maglambayan/tahanan/manufacturing/bom/tahanan-pcba-bom.csv

References | Qty | Value | Description | Manufacturer | MPN | Footprint | Fit | Alternates | Unit USD | Ext USD | Price basis | DigiKey stock | Supply note | DigiKey search | Mouser search | LCSC search | Datasheet
BT1 | 1 | CR1220 | Coin cell holder 12mm, RTC backup | Keystone | 3000 | BatteryHolder_Keystone_3000_1x12mm | fit |  | 0.550 | 0.55 | estimate |  |  | https://www.digikey.com/en/products/result?keywords=3000 | https://www.mouser.com/c/?q=3000 | https://www.lcsc.com/search?q=3000
C1 C2 C15 C25 C35 C45 C46 C53 C87 C88 C94 C95 C97 | 13 | 1uF 16V | MLCC 1uF 16V X5R 0402 | Samsung | CL05A105KO5NNNC | C_0402_1005Metric | fit |  | 0.008 | 0.10 | estimate |  |  | https://www.digikey.com/en/products/result?keywords=CL05A105KO5NNNC | https://www.mouser.com/c/?q=CL05A105KO5NNNC | https://www.lcsc.com/search?q=CL05A105KO5NNNC
C3 | 1 | 4.7uF 50V | MLCC 4.7uF 50V X5R 0805 | Samsung | CL21A475KBQNNNE | C_0805_2012Metric | fit |  | 0.008 | 0.01 | estimate |  |  | https://www.digikey.com/en/products/result?keywords=CL21A475KBQNNNE | https://www.mouser.com/c/?q=CL21A475KBQNNNE | https://www.lcsc.com/search?q=CL21A475KBQNNNE
C4 C6 C7 | 3 | 100nF 50V | MLCC 100nF 50V X7R 0603 | Samsung | CL10B104KB8NNNC | C_0603_1608Metric | fit |  | 0.008 | 0.02 | estimate |  |  | https://www.digikey.com/en/products/result?keywords=CL10B104KB8NNNC | https://www.mouser.com/c/?q=CL10B104KB8NNNC | https://www.lcsc.com/search?q=CL10B104KB8NNNC
C5 C8 C9 C11 C12 C21 C22 C31 C32 | 9 | 10uF 50V | MLCC 10uF 50V X7R 1210 | Samsung | CL32B106KBJNNNE | C_1210_3225Metric | fit |  | 0.160 | 1.44 | estimate |  |  | https://www.digikey.com/en/products/result?keywords=CL32B106KBJNNNE | https://www.mouser.com/c/?q=CL32B106KBJNNNE | https://www.lcsc.com/search?q=CL32B106KBJNNNE
C10 | 1 | 100uF 35V | Aluminium electrolytic 100uF 35V low-ESR | Panasonic | EEE-FT1V101AP | CP_Elec_6.3x7.7 | fit |  | 0.235 | 0.23 | DigiKey 2026-11-11, break at 1000 | 17076 |  | https://www.digikey.com/en/products/result?keywords=EEE-FT1V101AP | https://www.mouser.com/c/?q=EEE-FT1V101AP | https://www.lcsc.com/search?q=EEE-FT1V101AP
C13 C23 C33 | 3 | 220nF 50V | MLCC 220nF 50V X7R 0603 | Samsung | CL10B224KB8NNNC | C_0603_1608Metric | fit |  | 0.036 | 0.11 | DigiKey 2026-11-11, break at 500 | 138733 |  | https://www.digikey.com/en/products/result?keywords=CL10B224KB8NNNC | https://www.mouser.com/c/?q=CL10B224KB8NNNC | https://www.lcsc.com/search?q=CL10B224KB8NNNC
C14 C24 C34 C42 C51 C52 C57 C58 C60 C62 C64 C65 C66 C67 C68 C76 C80 C81 C83 C84 C85 C86 C91 C92 C93 C96 | 26 | 100nF 16V | MLCC 100nF 16V X7R 0402 | Samsung | CL05B104KO5NNNC | C_0402_1005Metric | fit |  | 0.008 | 0.21 | estimate |  |  | https://www.digikey.com/en/products/result?keywords=CL05B104KO5NNNC | https://www.mouser.com/c/?q=CL05B104KO5NNNC | https://www.lcsc.com/search?q=CL05B104KO5NNNC
C16 C26 C36 | 3 | 22pF 50V | MLCC 22pF 50V C0G 0402 | Samsung | CL05C220JB5NNNC | C_0402_1005Metric | fit |  | 0.008 | 0.02 | estimate |  |  | https://www.digikey.com/en/products/result?keywords=CL05C220JB5NNNC | https://www.mouser.com/c/?q=CL05C220JB5NNNC | https://www.lcsc.com/search?q=CL05C220JB5NNNC
C17 C18 C19 C20 C27 C28 C29 C30 C37 C38 C39 C40 C43 C44 C47 C48 C49 C50 C54 C55 C56 C90 | 22 | 22uF 10V | MLCC 22uF 10V X5R 0805 | Samsung | CL21A226MPQNNNE | C_0805_2012Metric | fit |  | 0.050 | 1.10 | estimate |  |  | https://www.digikey.com/en/products/result?keywords=CL21A226MPQNNNE | https://www.mouser.com/c/?q=CL21A226MPQNNNE | https://www.lcsc.com/search?q=CL21A226MPQNNNE
C41 C59 C75 C79 C82 C89 | 6 | 10uF 10V | MLCC 10uF 10V X5R 0603 | Samsung | CL10A106KP8NNNC | C_0603_1608Metric | fit |  | 0.008 | 0.05 | estimate |  |  | https://www.digikey.com/en/products/result?keywords=CL10A106KP8NNNC | https://www.mouser.com/c/?q=CL10A106KP8NNNC | https://www.lcsc.com/search?q=CL10A106KP8NNNC
C61 C63 | 2 | 150uF 6.3V | Polymer tantalum 150uF 6.3V 70mOhm | KEMET | T520B157M006ATE070 | CP_EIA-3528-21_Kemet-B | fit |  | 1.380 | 2.76 | DigiKey 2026-11-11, list price, break not shown | not shown |  | https://www.digikey.com/en/products/result?keywords=T520B157M006ATE070 | https://www.mouser.com/c/?q=T520B157M006ATE070 | https://www.lcsc.com/search?q=T520B157M006ATE070
C69 | 1 | 100nF 100V | MLCC 100nF 100V X7R 0805 | Samsung | CL21B104KCFNNNE | C_0805_2012Metric | fit |  | 0.008 | 0.01 | estimate |  |  | https://www.digikey.com/en/products/result?keywords=CL21B104KCFNNNE | https://www.mouser.com/c/?q=CL21B104KCFNNNE | https://www.lcsc.com/search?q=CL21B104KCFNNNE
C70 C72 | 2 | 1000uF 16V | Aluminium electrolytic 1000uF 16V, required by Ag5810 | Panasonic | EEE-FT1C102AP | CP_Elec_10x10.5 | fit |  | 0.580 | 1.16 | DigiKey 2026-11-11, break at 1000 | 9181 |  | https://www.digikey.com/en/products/result?keywords=EEE-FT1C102AP | https://www.mouser.com/c/?q=EEE-FT1C102AP | https://www.lcsc.com/search?q=EEE-FT1C102AP
C71 C73 | 2 | 10uF 25V | MLCC 10uF 25V X7R 1206 | Samsung | CL31B106KAHNNNE | C_1206_3216Metric | fit |  | 0.070 | 0.14 | estimate |  |  | https://www.digikey.com/en/products/result?keywords=CL31B106KAHNNNE | https://www.mouser.com/c/?q=CL31B106KAHNNNE | https://www.lcsc.com/search?q=CL31B106KAHNNNE
C74 | 1 | 4.7nF 2kV | MLCC 4.7nF 2kV X7R 1812 | KEMET | C1812C472KGRACTU | C_1812_4532Metric | fit |  | 0.740 | 0.74 | DigiKey 2026-11-11, break at 1000 | 2074 |  | https://www.digikey.com/en/products/result?keywords=C1812C472KGRACTU | https://www.mouser.com/c/?q=C1812C472KGRACTU | https://www.lcsc.com/search?q=C1812C472KGRACTU
C77 C78 | 2 | DNP 50V | MLCC DNP 50V C0G 0402 |  |  | C_0402_1005Metric | DNP |  | 0.000 | 0.00
C98 C99 | 2 | 1nF 50V | MLCC 1nF 50V X7R 0402 | Samsung | CL05B102KB5NNNC | C_0402_1005Metric | fit |  | 0.008 | 0.02 | estimate |  |  | https://www.digikey.com/en/products/result?keywords=CL05B102KB5NNNC | https://www.mouser.com/c/?q=CL05B102KB5NNNC | https://www.lcsc.com/search?q=CL05B102KB5NNNC
D1 | 1 | SMAJ22A | TVS 22V unidirectional 400W SMA | Littelfuse | SMAJ22A | D_SMA | fit |  | 0.120 | 0.12 | estimate |  |  | https://www.digikey.com/en/products/result?keywords=SMAJ22A | https://www.mouser.com/c/?q=SMAJ22A | https://www.lcsc.com/search?q=SMAJ22A | https://www.littelfuse.com/media?itemid=75e32973-b177-4ee3-a0ff-cedaf1abdb93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
D2 | 1 | BZT52C10S 10V | Zener 10V 200mW SOD-323, Q1 gate clamp | Diodes Inc | BZT52C10S-7-F | D_SOD-323 | fit |  | 0.030 | 0.03 | estimate |  |  | https://www.digikey.com/en/products/result?keywords=BZT52C10S-7-F | https://www.mouser.com/c/?q=BZT52C10S-7-F | https://www.lcsc.com/search?q=BZT52C10S-7-F
D3 | 1 | LED red | LED red 0603 | Wurth | 150060RS75000 | LED_0603_1608Metric | fit |  | 0.030 | 0.03 | estimate |  |  | https://www.digikey.com/en/products/result?keywords=150060RS75000 | https://www.mouser.com/c/?q=150060RS75000 | https://www.lcsc.com/search?q=150060RS75000
D4 D16 | 2 | LED green | LED green 0603 | Wurth | 150060GS75000 | LED_0603_1608Metric | fit |  | 0.030 | 0.06 | estimate |  |  | https://www.digikey.com/en/products/result?keywords=150060GS75000 | https://www.mouser.com/c/?q=150060GS75000 | https://www.lcsc.com/search?q=150060GS75000
D5 | 1 | LED blue | LED blue 0603 | Wurth | 150060BS75000 | LED_0603_1608Metric | fit |  | 0.030 | 0.03 | estimate |  |  | https://www.digikey.com/en/products/result?keywords=150060BS75000 | https://www.mouser.com/c/?q=150060BS75000 | https://www.lcsc.com/search?q=150060BS75000
D6 D17 | 2 | LED yellow | LED yellow 0603 | Wurth | 150060YS75000 | LED_0603_1608Metric | fit |  | 0.030 | 0.06 | estimate |  |  | https://www.digikey.com/en/products/result?keywords=150060YS75000 | https://www.mouser.com/c/?q=150060YS75000 | https://www.lcsc.com/search?q=150060YS75000
D7 D8 D9 D10 D11 D12 D13 D14 | 8 | PMEG10020ELR | Schottky 100V 2A SOD-123W, PoE input bridge | Nexperia | PMEG10020ELRX | Nexperia_CFP3_SOD-123W | fit | SS210 | 0.138 | 1.10 | DigiKey 2026-11-11, break at 500 | 236366 |  | https://www.digikey.com/en/products/result?keywords=PMEG10020ELRX | https://www.mouser.com/c/?q=PMEG10020ELRX | https://www.lcsc.com/search?q=PMEG10020ELRX | https://assets.nexperia.com/documents/data-sheet/PMEG10020ELR.pdf
D15 | 1 | SMAJ58A | TVS 58V unidirectional 400W SMA (pin 1 cathode to VPOE_P) | Littelfuse | SMAJ58A | D_SMA | fit |  | 0.120 | 0.12 | estimate |  |  | https://www.digikey.com/en/products/result?keywords=SMAJ58A | https://www.mouser.com/c/?q=SMAJ58A | https://www.lcsc.com/search?q=SMAJ58A | https://www.littelfuse.com/media?itemid=75e32973-b177-4ee3-a0ff-cedaf1abdb93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
FB1 FB2 | 2 | 1k@100MHz 2A | Ferrite bead | Taiyo Yuden | FBMH3225HM102NT | L_1210_3225Metric | fit |  | 0.530 | 1.06 | DigiKey 2026-11-11, list price, break not shown | not shown |  | https://www.digikey.com/en/products/result?keywords=FBMH3225HM102NT | https://www.mouser.com/c/?q=FBMH3225HM102NT | https://www.lcsc.com/search?q=FBMH3225HM102NT
FB3 FB5 FB6 | 3 | 220R@100MHz 1.4A | Ferrite bead | Murata | BLM18PG221SN1D | L_0603_1608Metric | fit |  | 0.030 | 0.09 | estimate |  |  | https://www.digikey.com/en/products/result?keywords=BLM18PG221SN1D | https://www.mouser.com/c/?q=BLM18PG221SN1D | https://www.lcsc.com/search?q=BLM18PG221SN1D
FB4 | 1 | 220R@100MHz 2A | Ferrite bead | Murata | BLM21PG221SN1D | L_0805_2012Metric | fit |  | 0.040 | 0.04 | estimate |  |  | https://www.digikey.com/en/products/result?keywords=BLM21PG221SN1D | https://www.mouser.com/c/?q=BLM21PG221SN1D | https://www.lcsc.com/search?q=BLM21PG221SN1D
H1 H2 H3 H4 | 4 | M2.5 standoff 3mm | SMT spacer M2.5 internal thread, 3.0mm, CM5 mounting | Wurth | 9774030151R | Mounting_Wuerth_WA-SMSI-M2.5_H3mm_9774030151 | fit |  | 0.601 | 2.41 | DigiKey 2026-11-11, break at 700 | 61790 |  | https://www.digikey.com/en/products/result?keywords=9774030151R | https://www.mouser.com/c/?q=9774030151R | https://www.lcsc.com/search?q=9774030151R
H9 | 1 | M.2 standoff 2280 | SMT spacer M2, M.2 2280 retention | Wurth | 9774025243R | Mounting_Wuerth_WA-SMSI-M2_H2.5mm_9774025243 | fit |  | 0.692 | 0.69 | DigiKey 2026-11-11, break at 950 | 127269 |  | https://www.digikey.com/en/products/result?keywords=9774025243R | https://www.mouser.com/c/?q=9774025243R | https://www.lcsc.com/search?q=9774025243R
H10 | 1 | M.2 standoff 2242 | SMT spacer M2, M.2 2242 retention | Wurth | 9774025243R | Mounting_Wuerth_WA-SMSI-M2_H2.5mm_9774025243 | fit |  | 0.692 | 0.69 | DigiKey 2026-11-11, break at 950 | 127269 |  | https://www.digikey.com/en/products/result?keywords=9774025243R | https://www.mouser.com/c/?q=9774025243R | https://www.lcsc.com/search?q=9774025243R
J1 | 1 | USB-C PD | USB Type-C receptacle, USB 2.0, 16 pin, top mount | GCT | USB4105-GF-A | USB_C_Receptacle_GCT_USB4105-xx-A_16P_TopMnt_Horizontal | fit | HRO TYPE-C-31-M-12 (different footprint) | 0.800 | 0.80 | DigiKey 2026-11-11, list price, break not shown | not shown |  | https://www.digikey.com/en/products/result?keywords=USB4105-GF-A | https://www.mouser.com/c/?q=USB4105-GF-A | https://www.lcsc.com/search?q=USB4105-GF-A | https://www.usb.org/sites/default/files/documents/usb_type-c.zip
J2 | 1 | RJ45 GbE PoE | RJ45 1000BASE-T with magnetics, four cable-side centre taps for PoE, 600 mA per tap | Wurth Elektronik | 7499511001A | RJ45_Wuerth_7499511001A | fit | Link-PP LPJG0926HENL (different footprint) | 7.791 | 7.79 | DigiKey 2026-11-11, break at 100 | 0 | 42 expected 2026-11-18 | https://www.digikey.com/en/products/result?keywords=7499511001A | https://www.mouser.com/c/?q=7499511001A | https://www.lcsc.com/search?q=7499511001A | https://www.we-online.com/components/products/datasheet/7499511001A.pdf
J3 | 1 | CM5 pins 1-100 | 100-pin 0.4mm board-to-board receptacle, 3.0mm stack, mates with CM5 | Hirose | DF40HC(3.0)-100DS-0.4V(51) | Hirose_DF40HC(3.0)-100DS-0.4V_2x50_P0.4mm | fit | Amphenol 10164227-1004A1RLF (4.0mm stack; confirm land pattern and change standoffs to 4.0mm) | 2.234 | 2.23 | DigiKey 2026-11-11, break at 1000 | 0 | backorder | https://www.digikey.com/en/products/result?keywords=DF40HC%283.0%29-100DS-0.4V%2851%29 | https://www.mouser.com/c/?q=DF40HC%283.0%29-100DS-0.4V%2851%29 | https://www.lcsc.com/search?q=DF40HC%283.0%29-100DS-0.4V%2851%29 | https://datasheets.raspberrypi.com/cm5/cm5-datasheet.pdf
J4 | 1 | M.2 Key M | M.2 Key M socket 0.5mm pitch, NVMe SSD | TE Connectivity | 2199119-4 | TE_M.2_M_2x38-1MP_P0.5mm | fit |  | 2.140 | 2.14 | DigiKey 2026-11-11, list price, break not shown | not shown |  | https://www.digikey.com/en/products/result?keywords=2199119-4 | https://www.mouser.com/c/?q=2199119-4 | https://www.lcsc.com/search?q=2199119-4 | https://web.archive.org/web/20200613074028/http://read.pudn.com/downloads794/doc/project/3133918/PCIe_M.2_Electromechanical_Spec_Rev1.0_Final_11012013_RS_Clea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
J5 | 1 | USB 3.0 x2 | Dual stacked USB 3.0 Type-A receptacle | Molex | 48406-0001 | USB3_A_Molex_48406-0001_Horizontal_Stacked | fit |  | 2.060 | 2.06 | DigiKey 2026-11-11, break at 1080 | 2312 | listed as 0484060001 | https://www.digikey.com/en/products/result?keywords=48406-0001 | https://www.mouser.com/c/?q=48406-0001 | https://www.lcsc.com/search?q=48406-0001
J6 | 1 | FAN | 4-pin 1.0mm fan header, Raspberry Pi 5 fan pinout | JST | SM04B-SRSS-TB | JST_SH_SM04B-SRSS-TB_1x04-1MP_P1.00mm_Horizontal | fit |  | 0.220 | 0.22 | estimate |  |  | https://www.digikey.com/en/products/result?keywords=SM04B-SRSS-TB | https://www.mouser.com/c/?q=SM04B-SRSS-TB | https://www.lcsc.com/search?q=SM04B-SRSS-TB
J7 | 1 | CONSOLE 3V3 | 3-pin header, serial console (UART4, 3.3V) | Wurth | 61300311121 | PinHeader_1x03_P2.54mm_Vertical | fit |  | 0.080 | 0.08 | estimate |  |  | https://www.digikey.com/en/products/result?keywords=61300311121 | https://www.mouser.com/c/?q=61300311121 | https://www.lcsc.com/search?q=61300311121
J8 | 1 | ZB SWD | SWD pads, not fitted |  |  | PinHeader_1x05_P1.27mm_Vertical | DNP |  | 0.000 | 0.00
J9 | 1 | U.FL Zigbee | U.FL coaxial receptacle 50 ohm | Hirose | U.FL-R-SMT-1(80) | U.FL_Hirose_U.FL-R-SMT-1_Vertical | fit |  | 0.380 | 0.38 | estimate |  |  | https://www.digikey.com/en/products/result?keywords=U.FL-R-SMT-1%2880%29 | https://www.mouser.com/c/?q=U.FL-R-SMT-1%2880%29 | https://www.lcsc.com/search?q=U.FL-R-SMT-1%2880%29
J10 | 1 | TH SWD | SWD pads, not fitted |  |  | PinHeader_1x05_P1.27mm_Vertical | DNP |  | 0.000 | 0.00
J11 | 1 | Z-Wave module socket | 2x5 2.54mm socket, Raspberry Pi header pins 1-10 for Z-Wave 800 module | Samtec | SSW-105-01-G-D | PinSocket_2x05_P2.54mm_Vertical | fit |  | 0.850 | 0.85 | estimate |  |  | https://www.digikey.com/en/products/result?keywords=SSW-105-01-G-D | https://www.mouser.com/c/?q=SSW-105-01-G-D | https://www.lcsc.com/search?q=SSW-105-01-G-D
J12 | 1 | SPEAKER 4R 3W | 2-pin 2.0mm header, speaker | JST | S2B-PH-K-S | JST_PH_S2B-PH-K_1x02_P2.00mm_Horizontal | fit |  | 0.060 | 0.06 | estimate |  |  | https://www.digikey.com/en/products/result?keywords=S2B-PH-K-S | https://www.mouser.com/c/?q=S2B-PH-K-S | https://www.lcsc.com/search?q=S2B-PH-K-S
J13 | 1 | CM5 pins 101-200 | 100-pin 0.4mm board-to-board receptacle, 3.0mm stack, mates with CM5 | Hirose | DF40HC(3.0)-100DS-0.4V(51) | Hirose_DF40HC(3.0)-100DS-0.4V_2x50_P0.4mm | fit | Amphenol 10164227-1004A1RLF (4.0mm stack; confirm land pattern and change standoffs to 4.0mm) | 2.234 | 2.23 | DigiKey 2026-11-11, break at 1000 | 0 | backorder | https://www.digikey.com/en/products/result?keywords=DF40HC%283.0%29-100DS-0.4V%2851%29 | https://www.mouser.com/c/?q=DF40HC%283.0%29-100DS-0.4V%2851%29 | https://www.lcsc.com/search?q=DF40HC%283.0%29-100DS-0.4V%2851%29 | https://datasheets.raspberrypi.com/cm5/cm5-datasheet.pdf
L1 L2 L3 | 3 | 6.8uH | Shielded power inductor 6.8uH | Bourns | SRP1038CC-6R8M | L_Bourns_SRP1038C_10.0x10.0mm | fit |  | 0.450 | 1.35 | DigiKey 2026-11-11, break at 1000 | 0 | 500 expected 2027-01-18. Replaces SRP1038C-6R8M, which is obsolete. Listed as 11.0 x 10.0 mm: check the footprint | https://www.digikey.com/en/products/result?keywords=SRP1038CC-6R8M | https://www.mouser.com/c/?q=SRP1038CC-6R8M | https://www.lcsc.com/search?q=SRP1038CC-6R8M
L4 | 1 | 4.7uH | Shielded power inductor 4.7uH 2A | Bourns | SRN4018-4R7M | L_Bourns-SRN4018 | fit |  | 0.220 | 0.22 | DigiKey 2026-11-11, break at 1000 | 90533 |  | https://www.digikey.com/en/products/result?keywords=SRN4018-4R7M | https://www.mouser.com/c/?q=SRN4018-4R7M | https://www.lcsc.com/search?q=SRN4018-4R7M
MK1 | 1 | IM73A135V01 | Analog MEMS microphone, 73dB SNR, differential, bottom port, IP57 | Infineon | IM73A135V01XTSA1 | Infineon_PG-LLGA-5-2 | fit | Knowles SPH8878LR5H-1 (different footprint) | 1.386 | 1.39 | DigiKey 2026-11-11, break at 500 | 87089 |  | https://www.digikey.com/en/products/result?keywords=IM73A135V01XTSA1 | https://www.mouser.com/c/?q=IM73A135V01XTSA1 | https://www.lcsc.com/search?q=IM73A135V01XTSA1 | https://www.infineon.com/dgdl/Infineon-IM73A135-DataSheet-v01_00-EN.pdf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
Q1 | 1 | DMP3013SFV | P-MOSFET -30V 13mOhm PowerDI3333-8 | Diodes Inc | DMP3013SFV-7 | Diodes_PowerDI3333-8 | fit | Si7617DN | 0.402 | 0.40 | DigiKey 2026-11-11, break at 100 | 25059 |  | https://www.digikey.com/en/products/result?keywords=DMP3013SFV-7 | https://www.mouser.com/c/?q=DMP3013SFV-7 | https://www.lcsc.com/search?q=DMP3013SFV-7 | https://www.diodes.com/assets/Datasheets/DMP3013SFV.pdf
Q2 Q3 | 2 | CSD17581Q3A | N-MOSFET 30V 3.8mOhm SON3.3x3.3 | Texas Instruments | CSD17581Q3A | VSON-8_3.3x3.3mm_P0.65mm_NexFET | fit | CSD17577Q3A | 1.330 | 2.66 | DigiKey 2026-11-11, list price, break not shown | not shown |  | https://www.digikey.com/en/products/result?keywords=CSD17581Q3A | https://www.mouser.com/c/?q=CSD17581Q3A | https://www.lcsc.com/search?q=CSD17581Q3A | https://www.ti.com/lit/ds/symlink/csd17581q3a.pdf
R1 | 1 | 470 | Resistor 470 1% 0402 | Yageo | RC0402FR-07470RL | R_0402_1005Metric | fit |  | 0.003 | 0.00 | estimate |  |  | https://www.digikey.com/en/products/result?keywords=RC0402FR-07470RL | https://www.mouser.com/c/?q=RC0402FR-07470RL | https://www.lcsc.com/search?q=RC0402FR-07470RL
R2 | 1 | 1k | Resistor 1k 1% 0603 | Yageo | RC0603FR-071kL | R_0603_1608Metric | fit |  | 0.003 | 0.00 | estimate |  |  | https://www.digikey.com/en/products/result?keywords=RC0603FR-071kL | https://www.mouser.com/c/?q=RC0603FR-071kL | https://www.lcsc.com/search?q=RC0603FR-071kL
R3 R5 R7 R8 R10 R12 R13 R15 R16 R24 R34 | 11 | 100k | Resistor 100k 1% 0402 | Yageo | RC0402FR-07100kL | R_0402_1005Metric | fit |  | 0.003 | 0.03 | estimate |  |  | https://www.digikey.com/en/products/result?keywords=RC0402FR-07100kL | https://www.mouser.com/c/?q=RC0402FR-07100kL | https://www.lcsc.com/search?q=RC0402FR-07100kL
R4 | 1 | 22k | Resistor 22k 1% 0402 | Yageo | RC0402FR-0722kL | R_0402_1005Metric | fit |  | 0.003 | 0.00 | estimate |  |  | https://www.digikey.com/en/products/result?keywords=RC0402FR-0722kL | https://www.mouser.com/c/?q=RC0402FR-0722kL | https://www.lcsc.com/search?q=RC0402FR-0722kL
R6 R11 | 2 | 24.9k | Resistor 24.9k 1% 0402 | Yageo | RC0402FR-0724k9L | R_0402_1005Metric | fit |  | 0.003 | 0.01 | estimate |  |  | https://www.digikey.com/en/products/result?keywords=RC0402FR-0724k9L | https://www.mouser.com/c/?q=RC0402FR-0724k9L | https://www.lcsc.com/search?q=RC0402FR-0724k9L
R9 | 1 | 18k | Resistor 18k 1% 0402 | Yageo | RC0402FR-0718kL | R_0402_1005Metric | fit |  | 0.003 | 0.00 | estimate |  |  | https://www.digikey.com/en/products/result?keywords=RC0402FR-0718kL | https://www.mouser.com/c/?q=RC0402FR-0718kL | https://www.lcsc.com/search?q=RC0402FR-0718kL
R14 | 1 | 43.2k | Resistor 43.2k 1% 0402 | Yageo | RC0402FR-0743k2L | R_0402_1005Metric | fit |  | 0.003 | 0.00 | estimate |  |  | https://www.digikey.com/en/products/result?keywords=RC0402FR-0743k2L | https://www.mouser.com/c/?q=RC0402FR-0743k2L | https://www.lcsc.com/search?q=RC0402FR-0743k2L
R17 R18 | 2 | 4.7k | Resistor 4.7k 1% 0402 | Yageo | RC0402FR-074k7L | R_0402_1005Metric | fit |  | 0.003 | 0.01 | estimate |  |  | https://www.digikey.com/en/products/result?keywords=RC0402FR-074k7L | https://www.mouser.com/c/?q=RC0402FR-074k7L | https://www.lcsc.com/search?q=RC0402FR-074k7L
R19 R20 R21 R22 | 4 | 1k | Resistor 1k 1% 0402 | Yageo | RC0402FR-071kL | R_0402_1005Metric | fit |  | 0.003 | 0.01 | estimate |  |  | https://www.digikey.com/en/products/result?keywords=RC0402FR-071kL | https://www.mouser.com/c/?q=RC0402FR-071kL | https://www.lcsc.com/search?q=RC0402FR-071kL
R23 | 1 | 47k | Resistor 47k 1% 0402 | Yageo | RC0402FR-0747kL | R_0402_1005Metric | fit |  | 0.003 | 0.00 | estimate |  |  | https://www.digikey.com/en/products/result?keywords=RC0402FR-0747kL | https://www.mouser.com/c/?q=RC0402FR-0747kL | https://www.lcsc.com/search?q=RC0402FR-0747kL
R25 | 1 | 27k | Resistor 27k 1% 1206 0.25W, opto LED current limit from 57V | Yageo | RC1206FR-0727kL | R_1206_3216Metric | fit |  | 0.003 | 0.00 | estimate |  |  | https://www.digikey.com/en/products/result?keywords=RC1206FR-0727kL | https://www.mouser.com/c/?q=RC1206FR-0727kL | https://www.lcsc.com/search?q=RC1206FR-0727kL
R26 R31 R33 | 3 | 10k | Resistor 10k 1% 0402 | Yageo | RC0402FR-0710kL | R_0402_1005Metric | fit |  | 0.003 | 0.01 | estimate |  |  | https://www.digikey.com/en/products/result?keywords=RC0402FR-0710kL | https://www.mouser.com/c/?q=RC0402FR-0710kL | https://www.lcsc.com/search?q=RC0402FR-0710kL
R27 | 1 | 1M | Resistor 1M 1% 1206 | Yageo | RC1206FR-071ML | R_1206_3216Metric | fit |  | 0.003 | 0.00 | estimate |  |  | https://www.digikey.com/en/products/result?keywords=RC1206FR-071ML | https://www.mouser.com/c/?q=RC1206FR-071ML | https://www.lcsc.com/search?q=RC1206FR-071ML
R28 R29 | 2 | 330 | Resistor 330 1% 0402 | Yageo | RC0402FR-07330RL | R_0402_1005Metric | fit |  | 0.003 | 0.01 | estimate |  |  | https://www.digikey.com/en/products/result?keywords=RC0402FR-07330RL | https://www.mouser.com/c/?q=RC0402FR-07330RL | https://www.lcsc.com/search?q=RC0402FR-07330RL
R30 | 1 | 0 | 0 ohm 0402, series element of antenna matching pi network | Yageo | RC0402FR-070RL | R_0402_1005Metric | fit |  | 0.003 | 0.00 | estimate |  |  | https://www.digikey.com/en/products/result?keywords=RC0402FR-070RL | https://www.mouser.com/c/?q=RC0402FR-070RL | https://www.lcsc.com/search?q=RC0402FR-070RL
R32 | 1 | 33 | Resistor 33 1% 0402 | Yageo | RC0402FR-0733RL | R_0402_1005Metric | fit |  | 0.003 | 0.00 | estimate |  |  | https://www.digikey.com/en/products/result?keywords=RC0402FR-0733RL | https://www.mouser.com/c/?q=RC0402FR-0733RL | https://www.lcsc.com/search?q=RC0402FR-0733RL
SW1 | 1 | POWER | Tactile switch, top actuated: POWER | C&K | PTS636SM25FSMTRLFS | SW_Tactile_SPST_NO_Straight_CK_PTS636Sx25SMTRLFS | fit |  | 0.166 | 0.17 | DigiKey 2026-11-11, break at 1000 | 12632 |  | https://www.digikey.com/en/products/result?keywords=PTS636SM25FSMTRLFS | https://www.mouser.com/c/?q=PTS636SM25FSMTRLFS | https://www.lcsc.com/search?q=PTS636SM25FSMTRLFS
SW2 | 1 | RPIBOOT | Tactile switch, top actuated: RPIBOOT | C&K | PTS636SM25FSMTRLFS | SW_Tactile_SPST_NO_Straight_CK_PTS636Sx25SMTRLFS | fit |  | 0.166 | 0.17 | DigiKey 2026-11-11, break at 1000 | 12632 |  | https://www.digikey.com/en/products/result?keywords=PTS636SM25FSMTRLFS | https://www.mouser.com/c/?q=PTS636SM25FSMTRLFS | https://www.lcsc.com/search?q=PTS636SM25FSMTRLFS
SW3 | 1 | USER | Tactile switch, top actuated: USER | C&K | PTS636SM25FSMTRLFS | SW_Tactile_SPST_NO_Straight_CK_PTS636Sx25SMTRLFS | fit |  | 0.166 | 0.17 | DigiKey 2026-11-11, break at 1000 | 12632 |  | https://www.digikey.com/en/products/result?keywords=PTS636SM25FSMTRLFS | https://www.mouser.com/c/?q=PTS636SM25FSMTRLFS | https://www.lcsc.com/search?q=PTS636SM25FSMTRLFS
SW4 | 1 | MIC MUTE | Slide switch SPDT, hardware microphone mute | C&K | JS102011SAQN | SW_SPDT_CK_JS102011SAQN | fit |  | 0.499 | 0.50 | DigiKey 2026-11-11, break at 1000 | 52403 |  | https://www.digikey.com/en/products/result?keywords=JS102011SAQN | https://www.mouser.com/c/?q=JS102011SAQN | https://www.lcsc.com/search?q=JS102011SAQN
U1 | 1 | STUSB4500QTR | Stand-alone USB PD controller (with sink Auto-run mode), QFN-24 | STMicroelectronics | STUSB4500QTR | QFN-24-1EP_4x4mm_P0.5mm_EP2.7x2.7mm | fit | STUSB4500LQTR (5V-only variant is NOT a substitute) | 1.220 | 1.22 | DigiKey 2026-11-11, break at 500 | 21991 |  | https://www.digikey.com/en/products/result?keywords=STUSB4500QTR | https://www.mouser.com/c/?q=STUSB4500QTR | https://www.lcsc.com/search?q=STUSB4500QTR | https://www.st.com/resource/en/datasheet/stusb4500.pdf
U2 | 1 | USBLC6-2SC6 | Very low capacitance ESD protection diode, 2 data-line, SOT-23-6 | STMicroelectronics | USBLC6-2SC6 | SOT-23-6 | fit |  | 0.540 | 0.54 | DigiKey 2026-11-11, list price, break not shown | not shown |  | https://www.digikey.com/en/products/result?keywords=USBLC6-2SC6 | https://www.mouser.com/c/?q=USBLC6-2SC6 | https://www.lcsc.com/search?q=USBLC6-2SC6 | https://www.st.com/resource/en/datasheet/usblc6-2.pdf
U3 U4 | 2 | LM74700-Q1 | Low Iq reverse battery protection ideal diode controller, SOT-23-6 | Texas Instruments | LM74700QDBVRQ1 | SOT-23-6 | fit | LM74701-Q1 | 1.333 | 2.67 | DigiKey 2026-11-11, break at 1000 | 0 | backorder | https://www.digikey.com/en/products/result?keywords=LM74700QDBVRQ1 | https://www.mouser.com/c/?q=LM74700QDBVRQ1 | https://www.lcsc.com/search?q=LM74700QDBVRQ1 | http://www.ti.com/lit/gpn/LM74700-Q1
U5 U6 | 2 | LMR33640ADDA | Simple Switcher Synchronous Buck Regulator, Vin=3.8-36V, Iout=4A, F=400kHz, Adjustable output voltage, HSOP-8 | Texas Instruments | LMR33640ADDAR | Texas_HSOP-8-1EP_3.9x4.9mm_P1.27mm_ThermalVias | fit | LMR33640DDDAR (2.1MHz, needs smaller L) | 1.694 | 3.39 | DigiKey 2026-11-11, break at 500 | 0 | 2,500 expected 2027-07-08, 26 week lead time | https://www.digikey.com/en/products/result?keywords=LMR33640ADDAR | https://www.mouser.com/c/?q=LMR33640ADDAR | https://www.lcsc.com/search?q=LMR33640ADDAR | http://www.ti.com/lit/ds/symlink/lmr33640.pdf
U7 | 1 | LMR33630ADDA | Simple Switcher Synchronous Buck Regulator, Vin=3.8-36V, Iout=3A, F=400kHz, Adjustable output voltage, HSOP-8 | Texas Instruments | LMR33630ADDAR | Texas_HSOP-8-1EP_3.9x4.9mm_P1.27mm_ThermalVias | fit | LMR33640ADDAR | 1.642 | 1.64 | DigiKey 2026-11-11, break at 500 | 0 | backorder | https://www.digikey.com/en/products/result?keywords=LMR33630ADDAR | https://www.mouser.com/c/?q=LMR33630ADDAR | https://www.lcsc.com/search?q=LMR33630ADDAR | http://www.ti.com/lit/ds/symlink/lmr33630.pdf
U8 | 1 | AP63203WU | 2A, 1.1MHz Buck DC/DC Converter, fixed 3.3V output voltage, TSOT-23-6 | Diodes Inc | AP63203WU-7 | TSOT-23-6 | fit | AP63205WU-7 is 5V, not a substitute | 0.502 | 0.50 | DigiKey 2026-11-11, break at 100 | 4977 |  | https://www.digikey.com/en/products/result?keywords=AP63203WU-7 | https://www.mouser.com/c/?q=AP63203WU-7 | https://www.lcsc.com/search?q=AP63203WU-7 | https://www.diodes.com/assets/Datasheets/AP63200-AP63201-AP63203-AP63205.pdf
U9 | 1 | AP2112K-1.8 | 600mA low dropout linear regulator, with enable pin, 2.5V-6V input voltage range, 1.8V fixed positive output, SOT-23-5 | Diodes Inc | AP2112K-1.8TRG1 | SOT-23-5 | fit |  | 0.132 | 0.13 | DigiKey 2026-11-11, break at 100 | not shown |  | https://www.digikey.com/en/products/result?keywords=AP2112K-1.8TRG1 | https://www.mouser.com/c/?q=AP2112K-1.8TRG1 | https://www.lcsc.com/search?q=AP2112K-1.8TRG1 | https://www.diodes.com/assets/Datasheets/AP2112.pdf
U10 | 1 | TPS2561DRC | Dual channel precision adjustable current-limited power switches | Texas Instruments | TPS2561DRCR | VSON-10-1EP_3x3mm_P0.5mm_EP1.65x2.4mm_ThermalVias | fit | TPS2561ADRCR | 0.763 | 0.76 | DigiKey 2026-11-11, break at 1000 | 0 | 3,000 expected 2026-12-01 | https://www.digikey.com/en/products/result?keywords=TPS2561DRCR | https://www.mouser.com/c/?q=TPS2561DRCR | https://www.lcsc.com/search?q=TPS2561DRCR | http://www.ti.com/lit/ds/symlink/tps2561.pdf
U11 U13 U15 U16 | 4 | TPD4E05U06DQA | 4-channel ESD array 0.5pF, USB 3.0 SuperSpeed pairs | Texas Instruments | TPD4E05U06DQAR | USON-10_2.5x1.0mm_P0.5mm | fit |  | 0.860 | 3.44 | DigiKey 2026-11-11, list price, break not shown | not shown |  | https://www.digikey.com/en/products/result?keywords=TPD4E05U06DQAR | https://www.mouser.com/c/?q=TPD4E05U06DQAR | https://www.lcsc.com/search?q=TPD4E05U06DQAR | https://www.ti.com/lit/ds/symlink/tpd4e05u06.pdf
U12 U14 | 2 | TPD2EUSB30 | 2-channel ESD array, USB 2.0 D+/D- | Texas Instruments | TPD2EUSB30DRTR | Texas_DRT-3 | fit |  | 0.391 | 0.78 | DigiKey 2026-11-11, break at 500 | 0 | backorder | https://www.digikey.com/en/products/result?keywords=TPD2EUSB30DRTR | https://www.mouser.com/c/?q=TPD2EUSB30DRTR | https://www.lcsc.com/search?q=TPD2EUSB30DRTR | http://www.ti.com/lit/ds/symlink/tpd2eusb30a.pdf
U17 | 1 | Ag5810 | 60 W IEEE 802.3bt Type 4 isolated PoE PD module, 12 V out | Silvertel | Ag5810 | Silvertel_Ag5810 | fit | Ag5800 (85W, larger footprint) | 17.490 | 17.49 | DigiKey 2026-11-11, list price, break not shown | 343 | top price tier, via Octopart listing of DigiKey | https://www.digikey.com/en/products/result?keywords=Ag5810 | https://www.mouser.com/c/?q=Ag5810 | https://www.lcsc.com/search?q=Ag5810 | https://silvertel.com/images/datasheets/Ag5810-datasheet-IEEE802_3bt-Power-over-Ethernet-4-pair-PD.pdf
U18 | 1 | LTV-817S | Optocoupler 5kV, PoE Type 4 detect across the isolation barrier | Lite-On | LTV-817S | SMDIP-4_W9.53mm | fit | PC817X (SMD), TLP785 | 0.410 | 0.41 | DigiKey 2026-11-11, list price, break not shown | not shown |  | https://www.digikey.com/en/products/result?keywords=LTV-817S | https://www.mouser.com/c/?q=LTV-817S | https://www.lcsc.com/search?q=LTV-817S | http://www.us.liteon.com/downloads/LTV-817-827-847.PDF
U19 | 1 | MGM240P Zigbee (RF pin) | Silicon Labs MGM240P EFR32MG24 multiprotocol 2.4 GHz module (Zigbee, Thread, BLE) | Silicon Labs | MGM240PA32VNN3 | SiliconLabs_MGM240P | fit | MGM240PB32VNA3 / MGM240PB32VNN3 pending certification check | 9.610 | 9.61 | DigiKey 2026-11-11, list price, break not shown | not shown |  | https://www.digikey.com/en/products/result?keywords=MGM240PA32VNN3 | https://www.mouser.com/c/?q=MGM240PA32VNN3 | https://www.lcsc.com/search?q=MGM240PA32VNN3 | https://www.silabs.com/documents/public/data-sheets/mgm240p-datasheet.pdf
U20 | 1 | MGM240P Thread (antenna) | Silicon Labs MGM240P EFR32MG24 multiprotocol 2.4 GHz module (Zigbee, Thread, BLE) | Silicon Labs | MGM240PA32VNA3 | SiliconLabs_MGM240P | fit | MGM240PB32VNA3 / MGM240PB32VNN3 pending certification check | 11.070 | 11.07 | DigiKey 2026-11-11, list price, break not shown | not shown |  | https://www.digikey.com/en/products/result?keywords=MGM240PA32VNA3 | https://www.mouser.com/c/?q=MGM240PA32VNA3 | https://www.lcsc.com/search?q=MGM240PA32VNA3 | https://www.silabs.com/documents/public/data-sheets/mgm240p-datasheet.pdf
U21 | 1 | TLV320AIC3100 | Low Power Audio Codec with Audio Processing and Mono Class‑D Amplifier, VQFN-32 | Texas Instruments | TLV320AIC3100IRHBR | VQFN-32-1EP_5x5mm_P0.5mm_EP3.5x3.5mm | fit | TLV320AIC3110IRHBR (stereo class-D, same driver) | 2.188 | 2.19 | DigiKey 2026-11-11, break at 500 | 0 | 2,995 expected 2026-11-18 | https://www.digikey.com/en/products/result?keywords=TLV320AIC3100IRHBR | https://www.mouser.com/c/?q=TLV320AIC3100IRHBR | https://www.lcsc.com/search?q=TLV320AIC3100IRHBR | http://www.ti.com/lit/ds/symlink/tlv320aic3100.pdf
Y1 | 1 | 12.288MHz | CMOS oscillator 12.288MHz 2.5x2.0mm | ECS | ECS-2520MVLC-122.8-BN-TR | Oscillator_SMD_ECS_2520MV-xxx-xx-4Pin_2.5x2.0mm | fit | SiTime SIT2001BI-S2-33E-12.288000 | 0.922 | 0.92 | DigiKey 2026-11-11, break at 1000 | 862 | replaces ECS-2520MV-122.8-BN-TR, which DigiKey does not list | https://www.digikey.com/en/products/result?keywords=ECS-2520MVLC-122.8-BN-TR | https://www.mouser.com/c/?q=ECS-2520MVLC-122.8-BN-TR | https://www.lcsc.com/search?q=ECS-2520MVLC-122.8-BN-TR | https://www.ecsxtal.com/store/pdf/ECS-2520MV.pdf
