maglambayan/tahanan/mechanical/out/tahanan-assembly.step

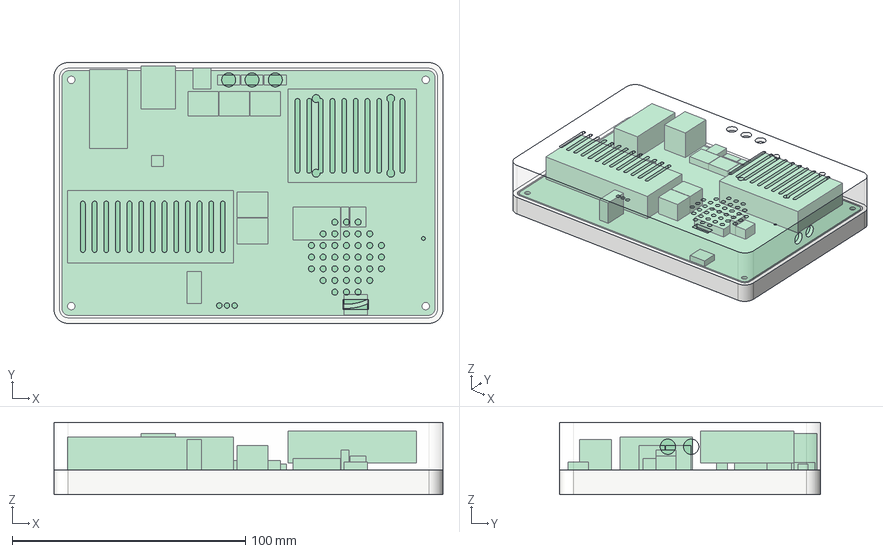
[picture p1: CAD file, 2026-11-10]
mechanical/out/tahanan-assembly.step
166.8 x 111.8 x 30.9 mm
base_part
lid_part
pcb_keepout_part
