maglambayan/tahanan/mechanical/out/tahanan-lid.step

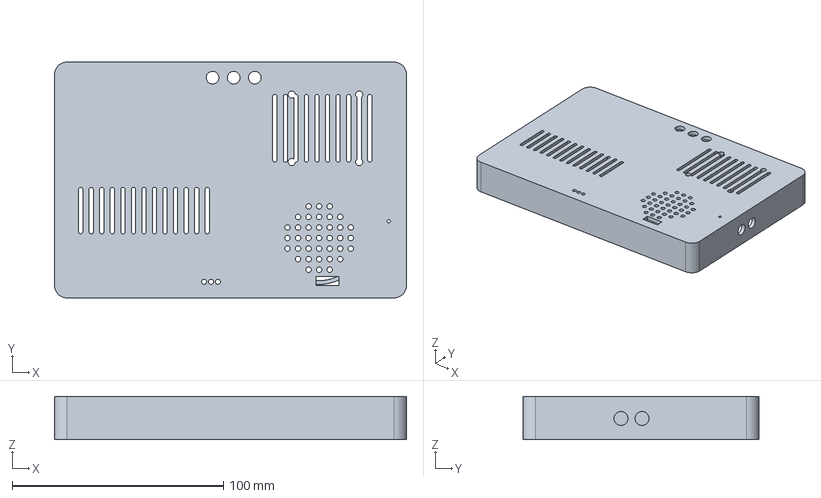
[picture p2: CAD file, 2026-11-10]
mechanical/out/tahanan-lid.step
166.8 x 111.8 x 20.4 mm
