maglambayan/tahanan/mechanical/out/tahanan-base.step

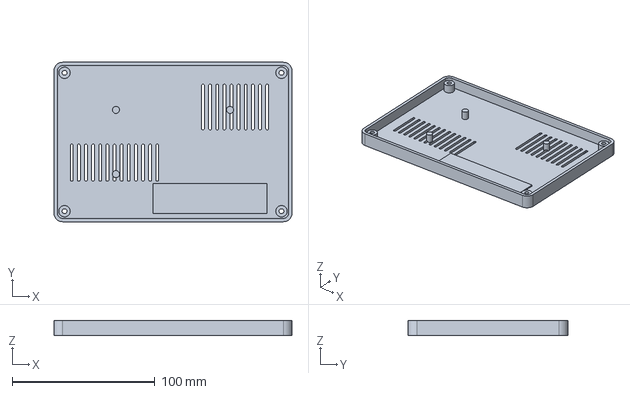
[picture p3: CAD file, 2026-11-10]
mechanical/out/tahanan-base.step
166.8 x 111.8 x 10.5 mm
