maglambayan/tahanan/mechanical/out/tahanan-button-plunger.step

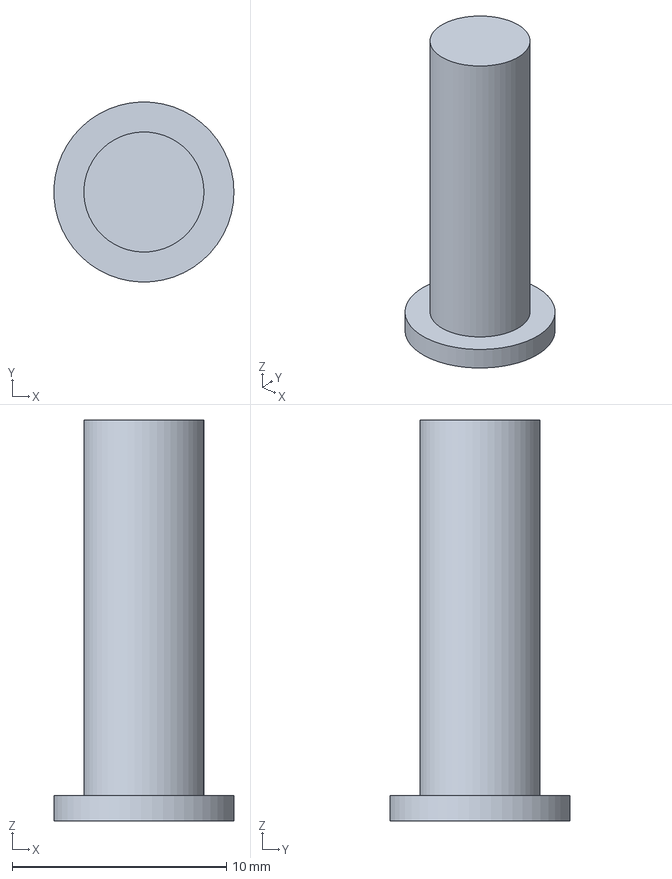
[picture p4: CAD file, 2026-11-10]
mechanical/out/tahanan-button-plunger.step
8.39 x 8.40 x 18.7 mm
