maglambayan/tahanan/mechanical/out/tahanan-mute-slider.step

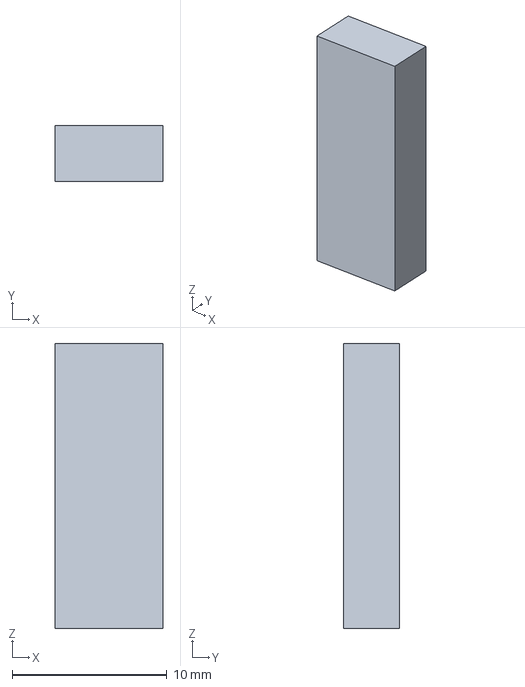
[picture p5: CAD file, 2026-11-10]
mechanical/out/tahanan-mute-slider.step
7.00 x 3.60 x 18.4 mm
