maglambayan/tahanan/(list of files, cad)

Other CAD files:
mechanical/out/tahanan-base.3mf
mechanical/out/tahanan-base.stl
mechanical/out/tahanan-button-plunger.3mf
mechanical/out/tahanan-button-plunger.stl
mechanical/out/tahanan-lid.3mf
mechanical/out/tahanan-lid.stl
mechanical/out/tahanan-mute-slider.3mf
mechanical/out/tahanan-mute-slider.stl
