maglambayan/tahanan/manufacturing/drawings/tahanan-placement-top.pdf

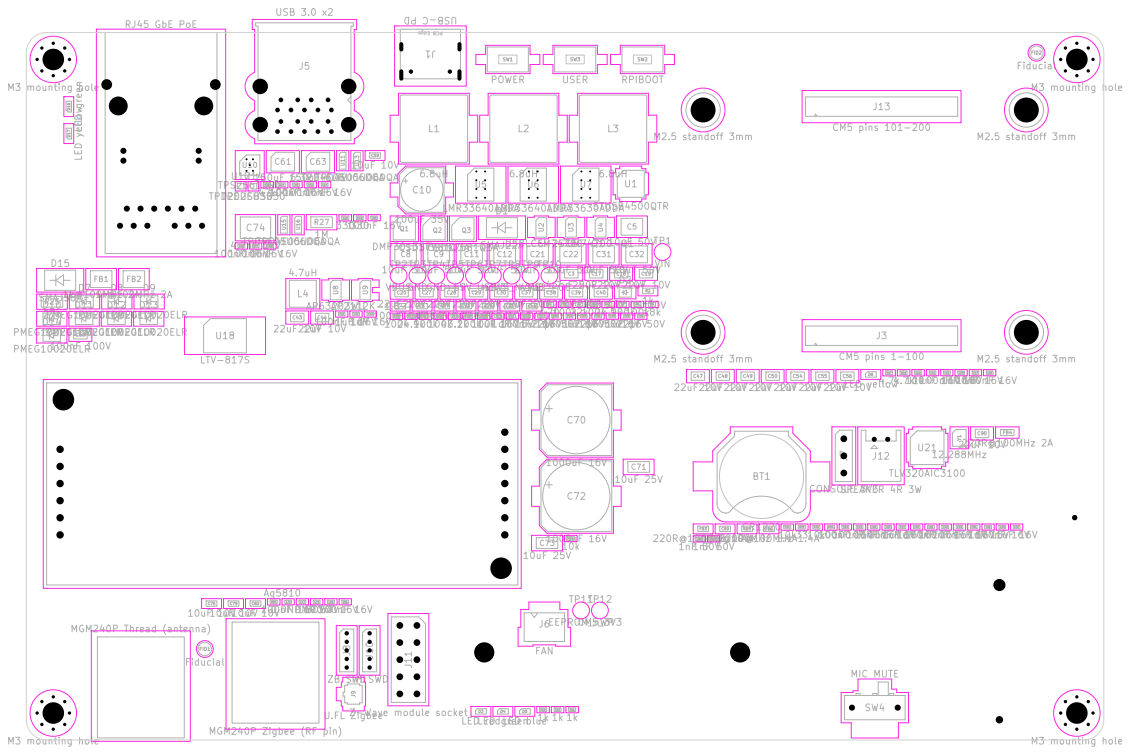
[picture p6: page 1]

L4 | VBUS | 4.7uF 50V | 22uF 10V

D14 | PMEG10020ELR | C44 | 22k C25 100nF 50V
