maglambayan/tahanan/manufacturing/drawings/tahanan-schematic.pdf

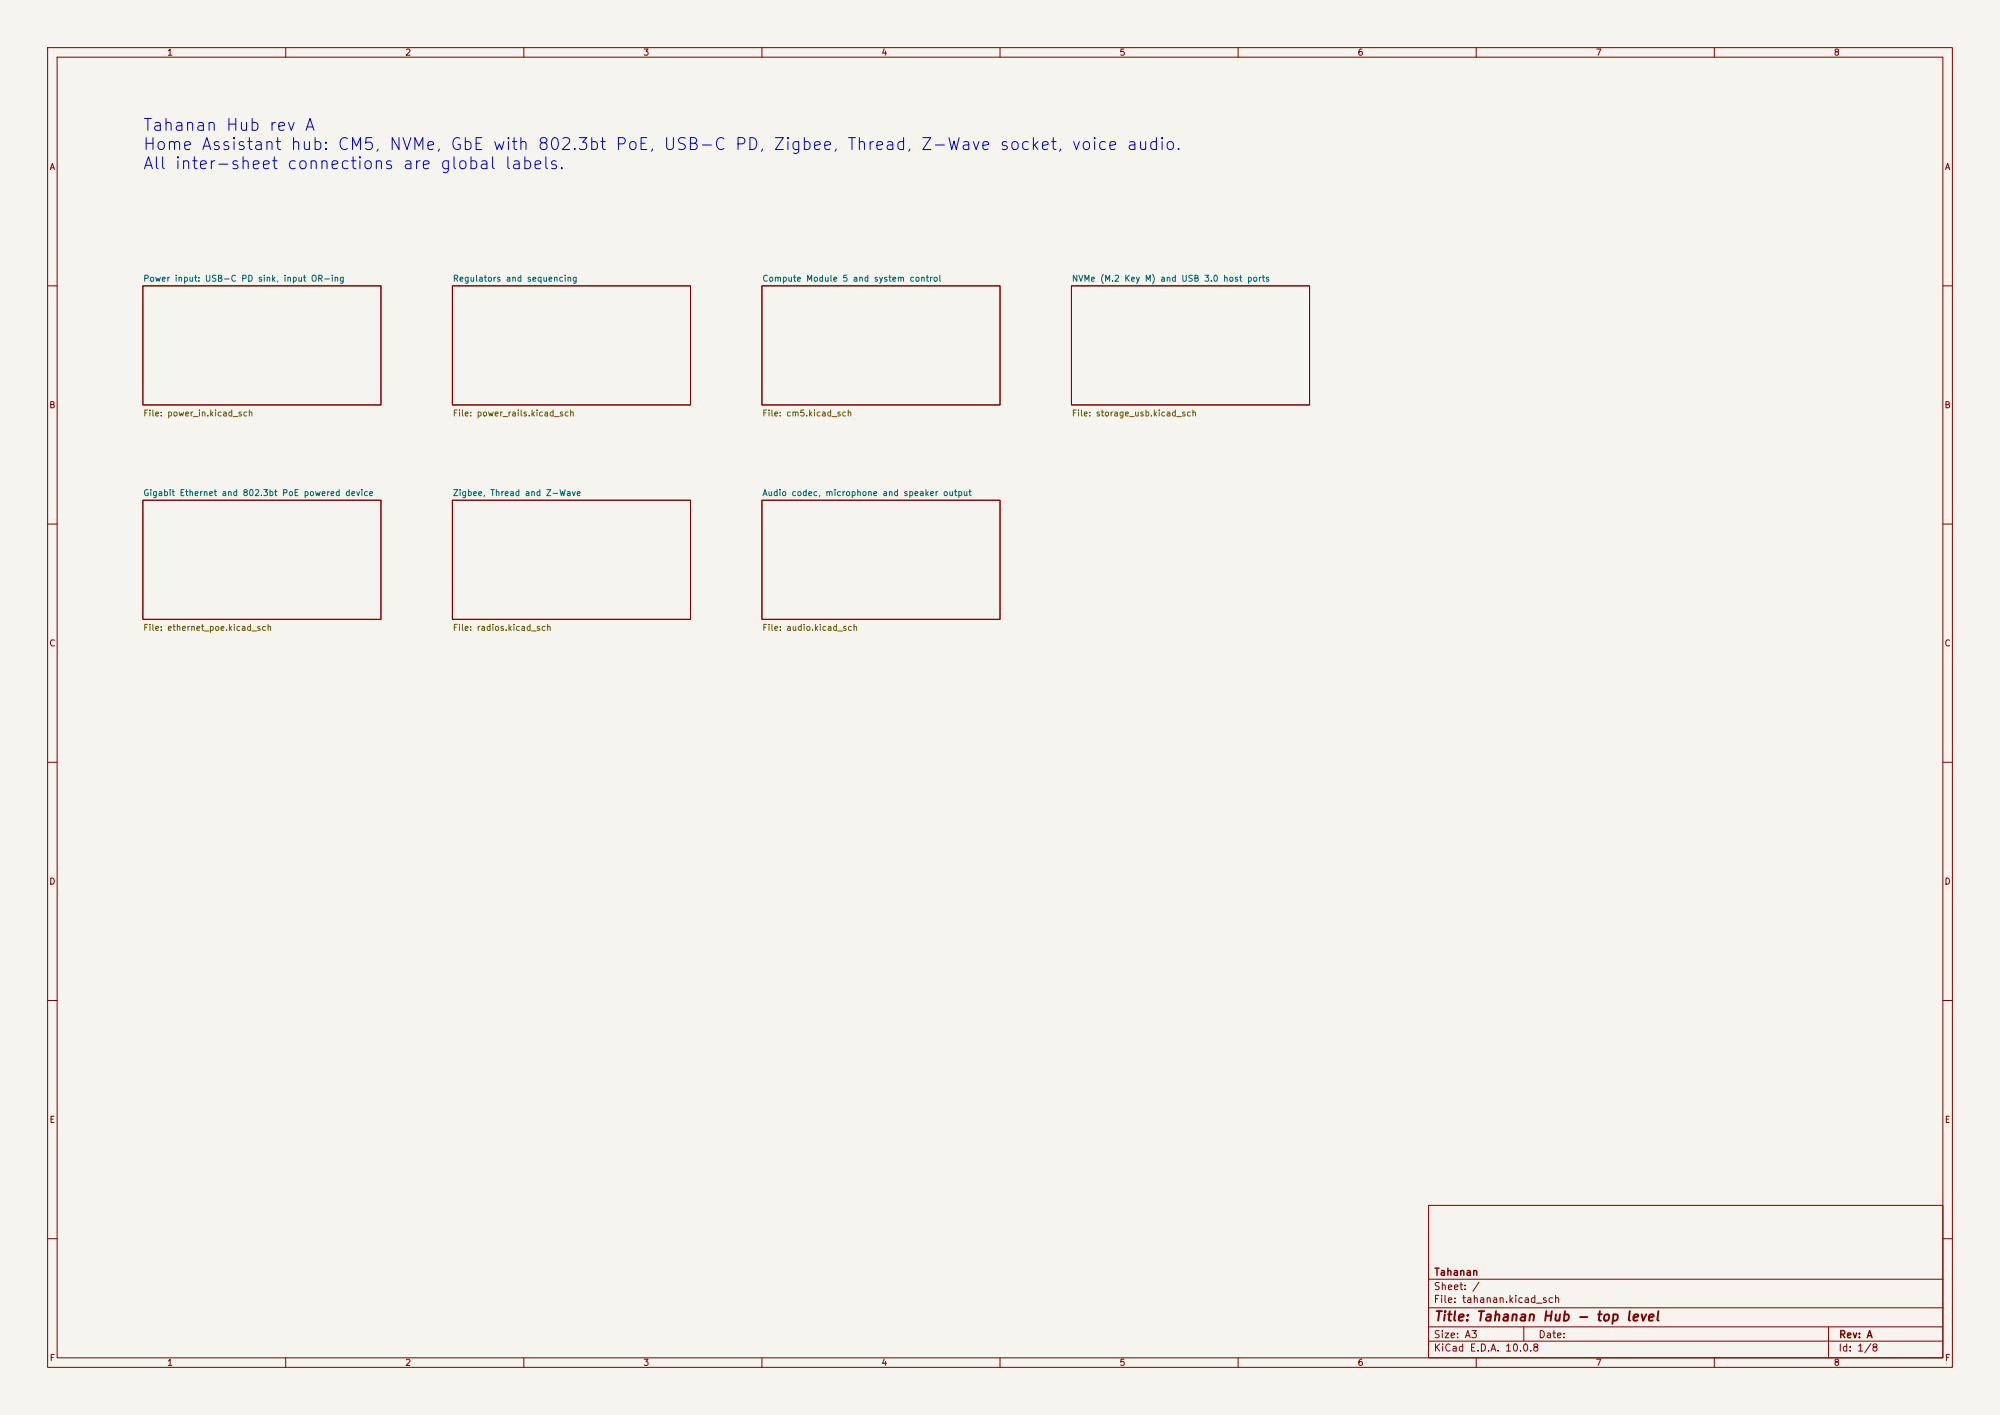
[picture p7: page 1]

Audio codec, microphone and speaker output File: audio.kicad_sch Tahanan Hub rev A
Home Assistant hub: CM5, NVMe, GbE with 802.3bt PoE, USB-C PD, Zigbee, Thread, Z-Wave socket, voice audio.
All inter-sheet connections are global labels.

Power input: USB-C PD sink, input OR-ing

Gigabit Ethernet and 802.3bt PoE powered device

Zigbee, Thread and Z-Wave

Tahanan
Sheet: /
File: tahanan.kicad_sch
Title: Tahanan Hub - top level

Size: A3 | Rev: A | F Date:
KiCad E.D.A. 10.0.8 | Id: 1/8

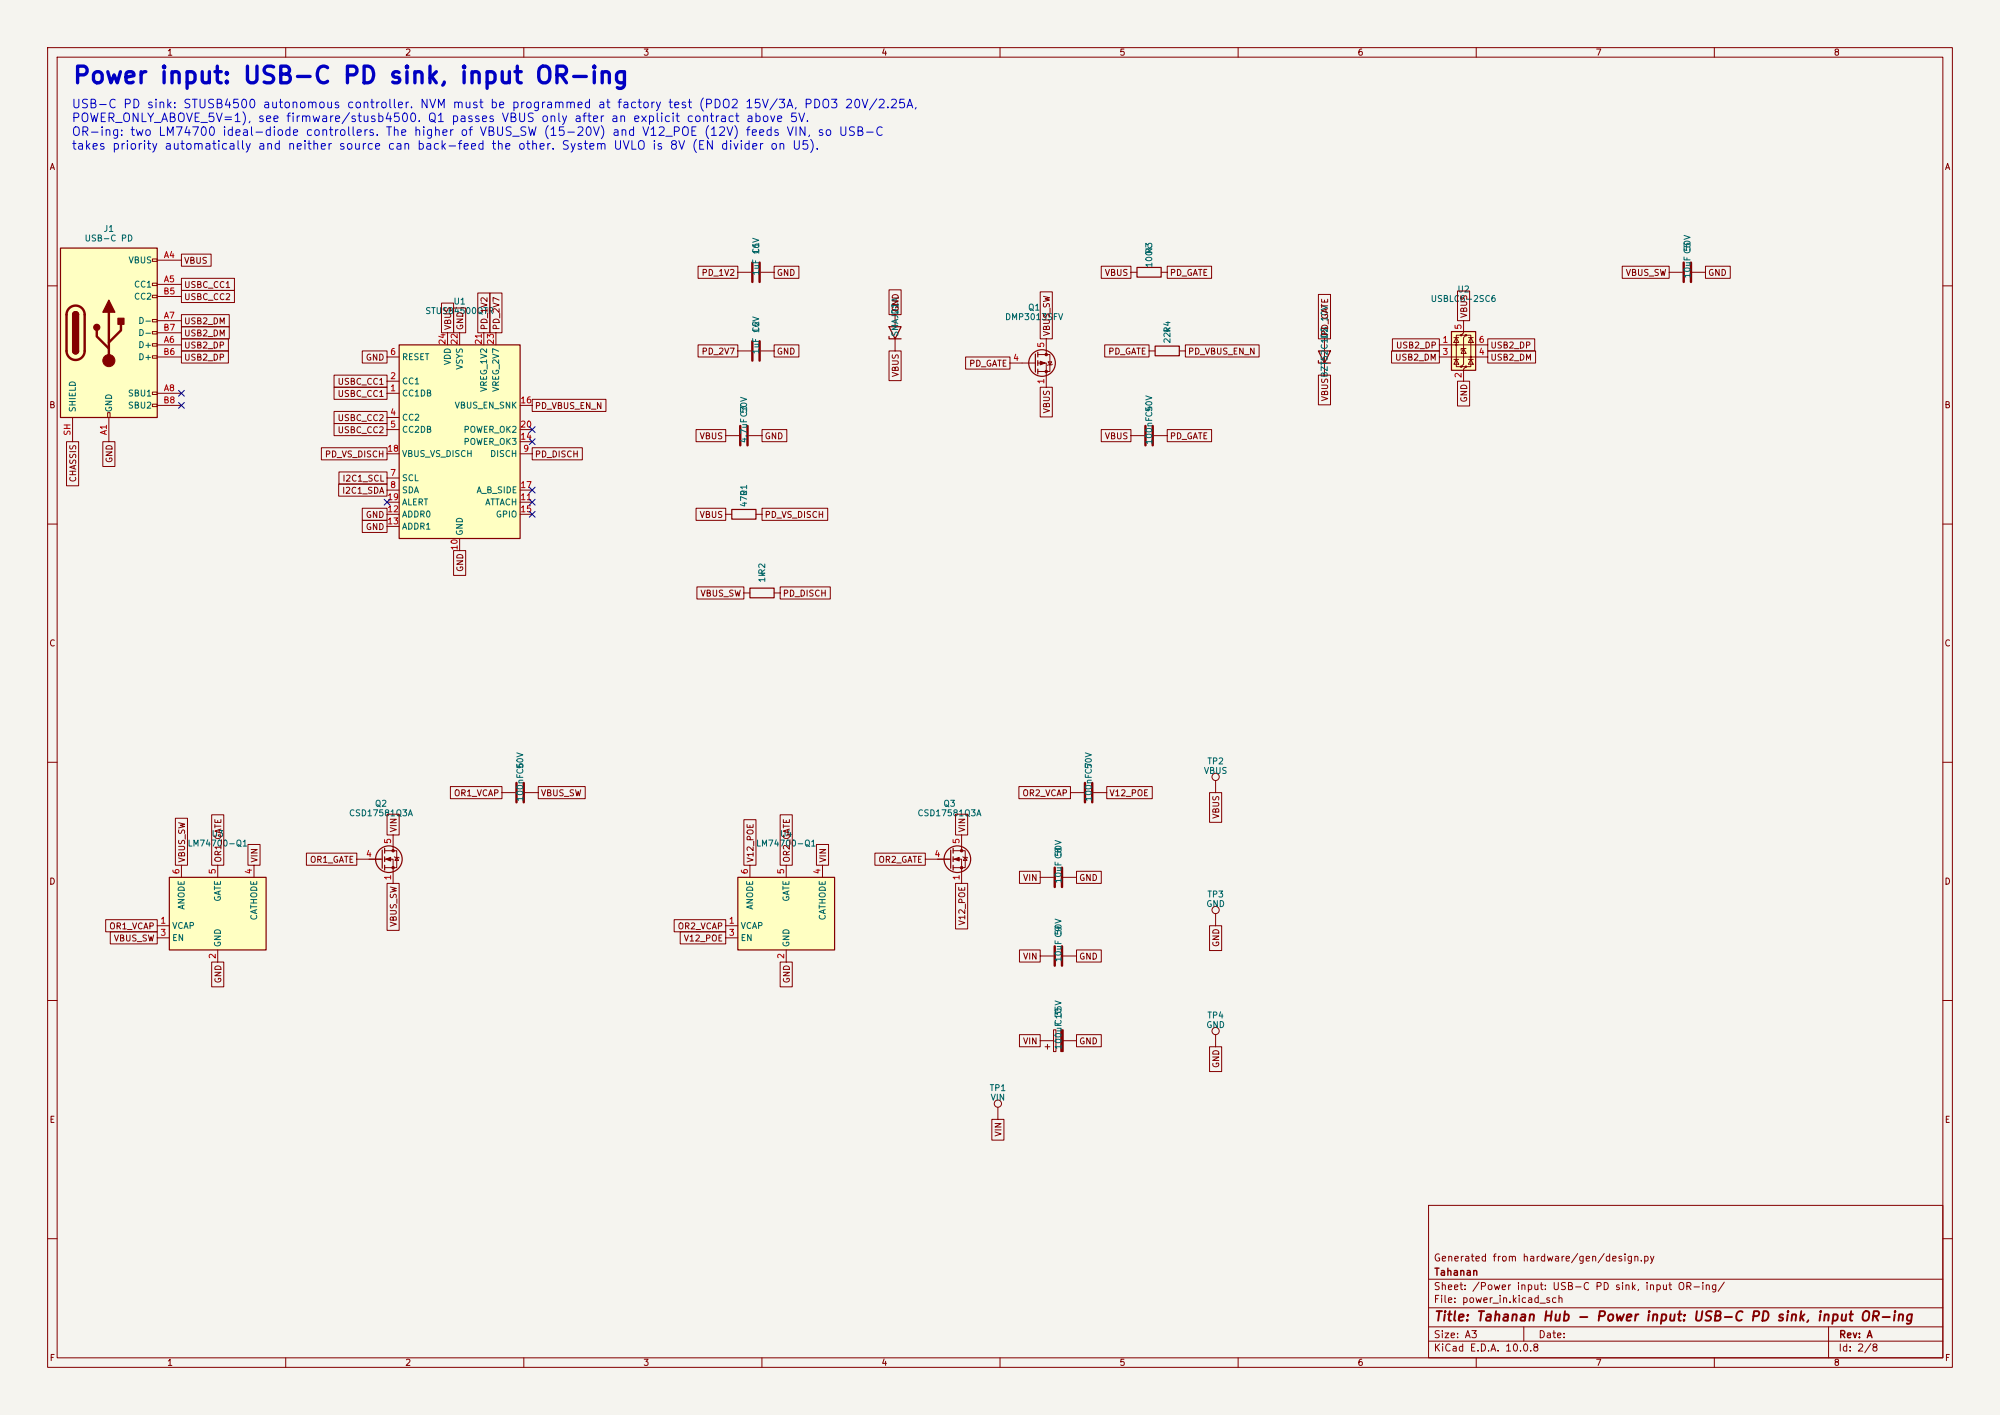
[picture p8: page 2]

Power input: USB-C PD sink, input OR-ing

PD_1V2 USB-C PD sink: STUSB4500 autonomous controller. NVM must be programmed at factory test (PDO2 15V/3A, PDO3 20V/2.25A,
POWER_ONLY_ABOVE_5V=1), see firmware/stusb4500. Q1 passes VBUS only after an explicit contract above 5V.
OR-ing: two LM74700 ideal-diode controllers. The higher of VBUS_SW (15-20V) and V12_POE (12V) feeds VIN, so USB-C
takes priority automatically and neither source can back-feed the other. System UVLO is 8V (EN divider on U5).

Generated from hardware/gen/design.py
Tahanan
Sheet: /Power input: USB-C PD sink, input OR-ing/
File: power_in.kicad_sch
Title: Tahanan Hub - Power input: USB-C PD sink, input OR-ing

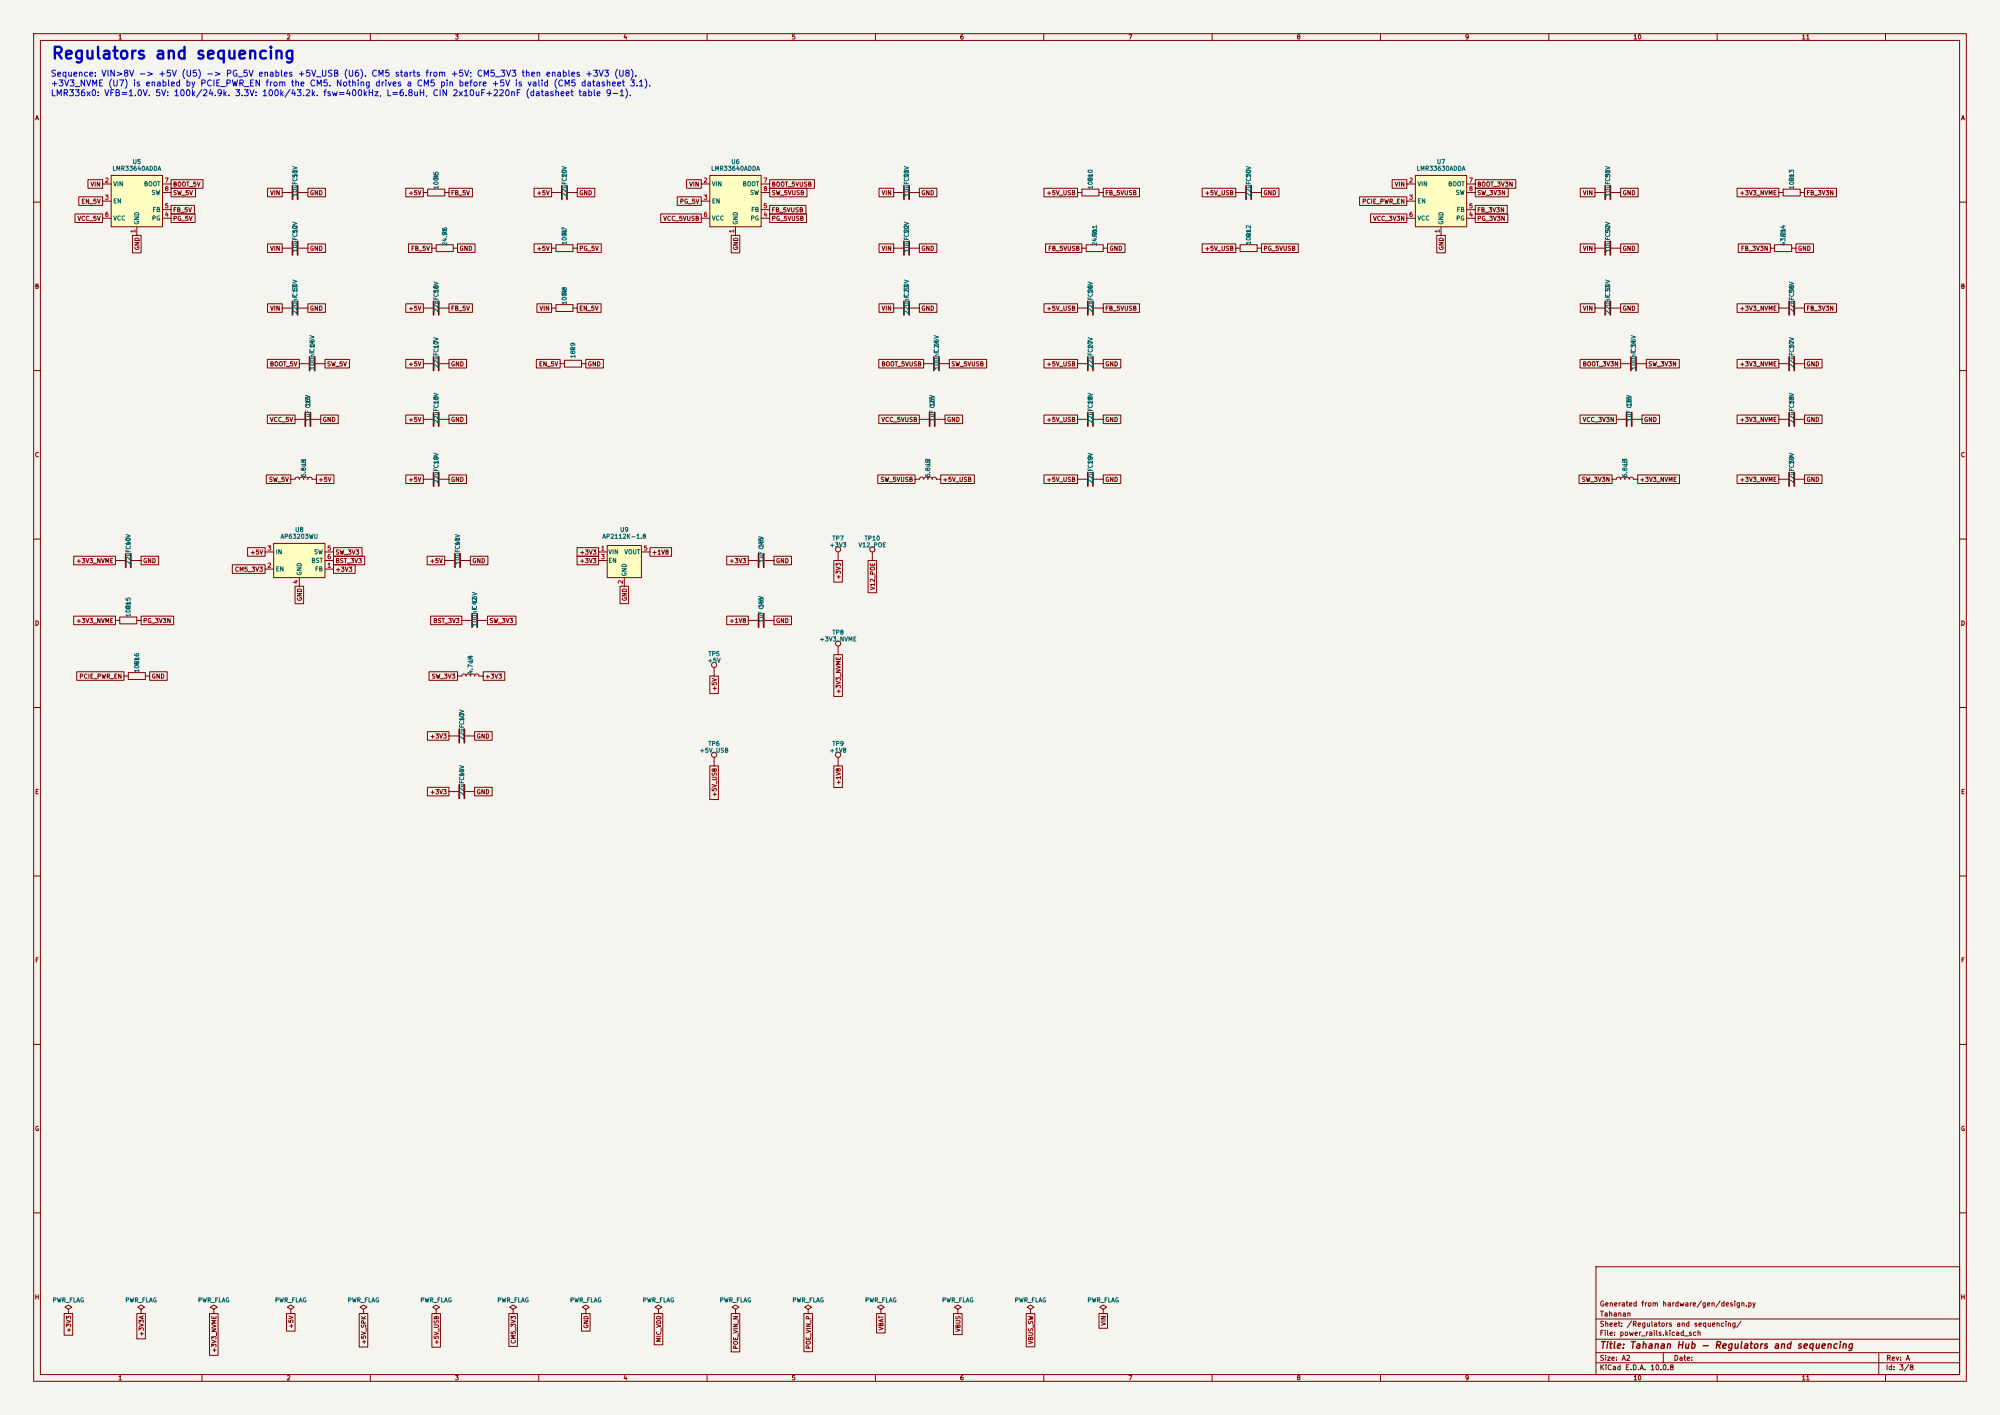
[picture p9: page 3]

VIN Sequence: VIN>8V -> +5V (U5) -> PG_5V enables +5V_USB (U6). CM5 starts from +5V; CM5_3V3 then enables +3V3 (U8).
+3V3_NVME (U7) is enabled by PCIE_PWR_EN from the CM5. Nothing drives a CM5 pin before +5V is valid (CM5 datasheet 3.1).
LMR336x0: VFB=1.0V. 5V: 100k/24.9k. 3.3V: 100k/43.2k. fsw=400kHz, L=6.8uH, CIN 2x10uF+220nF (datasheet table 9-1).

Tahanan
Sheet: /Regulators and sequencing/
File: power_rails.kicad_sch
Title: Tahanan Hub - Regulators and sequencing

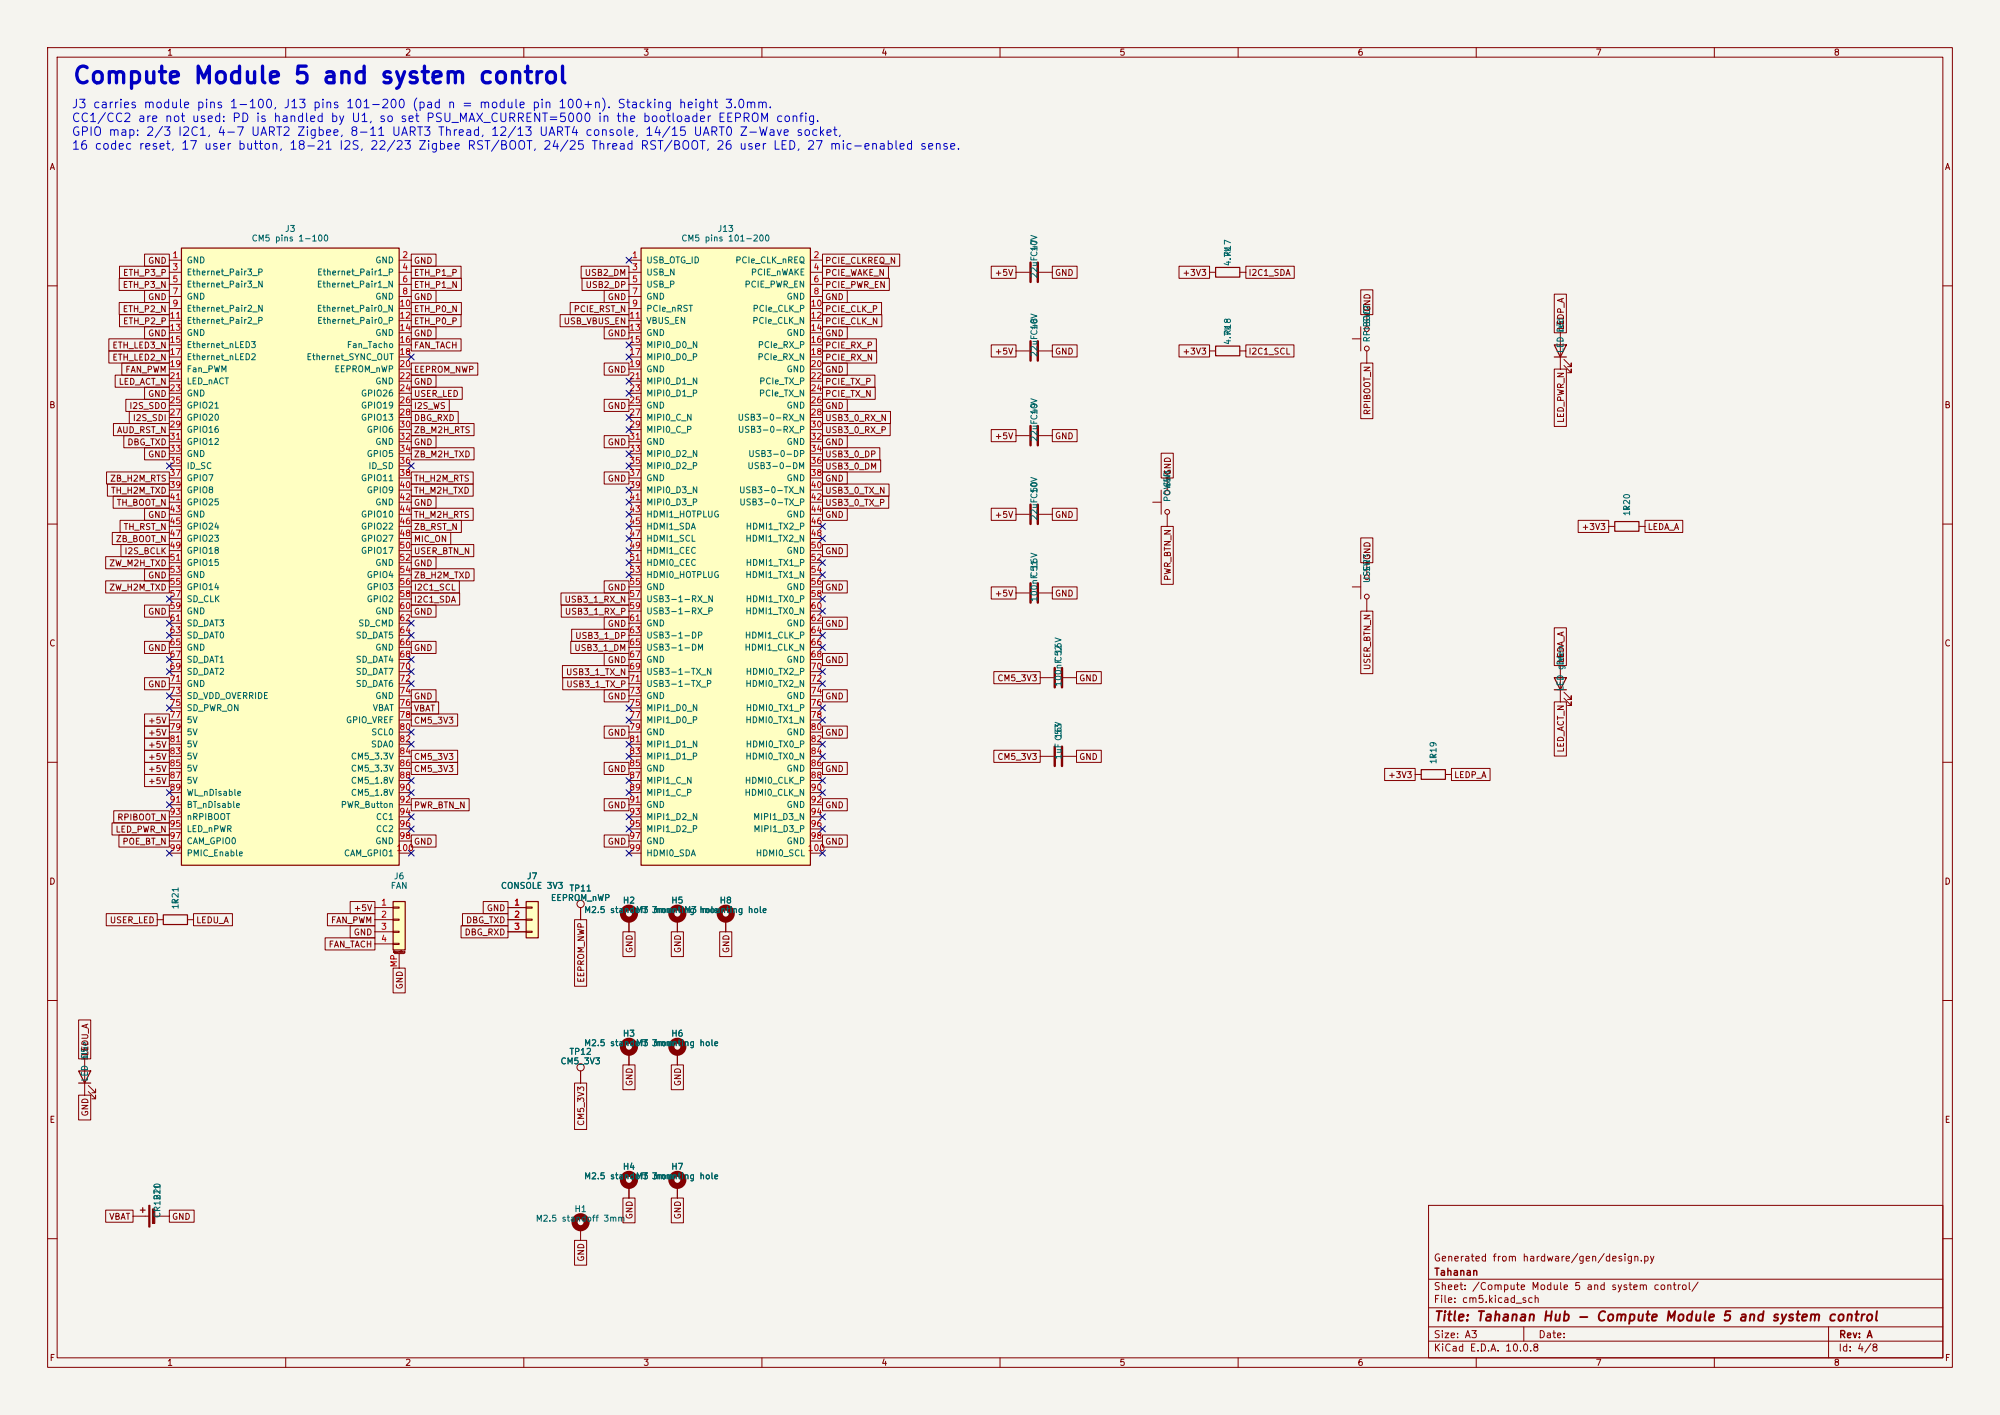
[picture p10: page 4]

16 codec reset, 17 user button, 18-21 I2S, 22/23 Zigbee RST/BOOT, 24/25 Thread RST/BOOT, 26 user LED, 27 mic-enabled sense. Compute Module 5 and system control
GND USB_VBUS_EN
FAN_TACH

J3 carries module pins 1-100, J13 pins 101-200 (pad n = module pin 100+n). Stacking height 3.0mm.
CC1/CC2 are not used: PD is handled by U1, so set PSU_MAX_CURRENT=5000 in the bootloader EEPROM config.
GPIO map: 2/3 I2C1, 4-7 UART2 Zigbee, 8-11 UART3 Thread, 12/13 UART4 console, 14/15 UART0 Z-Wave socket,

GND
H7 M3 mounting hole H5 M3 mounting hole H2 M2.5 standoff 3mm

Generated from hardware/gen/design.py R21 1k

Tahanan
Sheet: /Compute Module 5 and system control/
File: cm5.kicad_sch
Title: Tahanan Hub - Compute Module 5 and system control

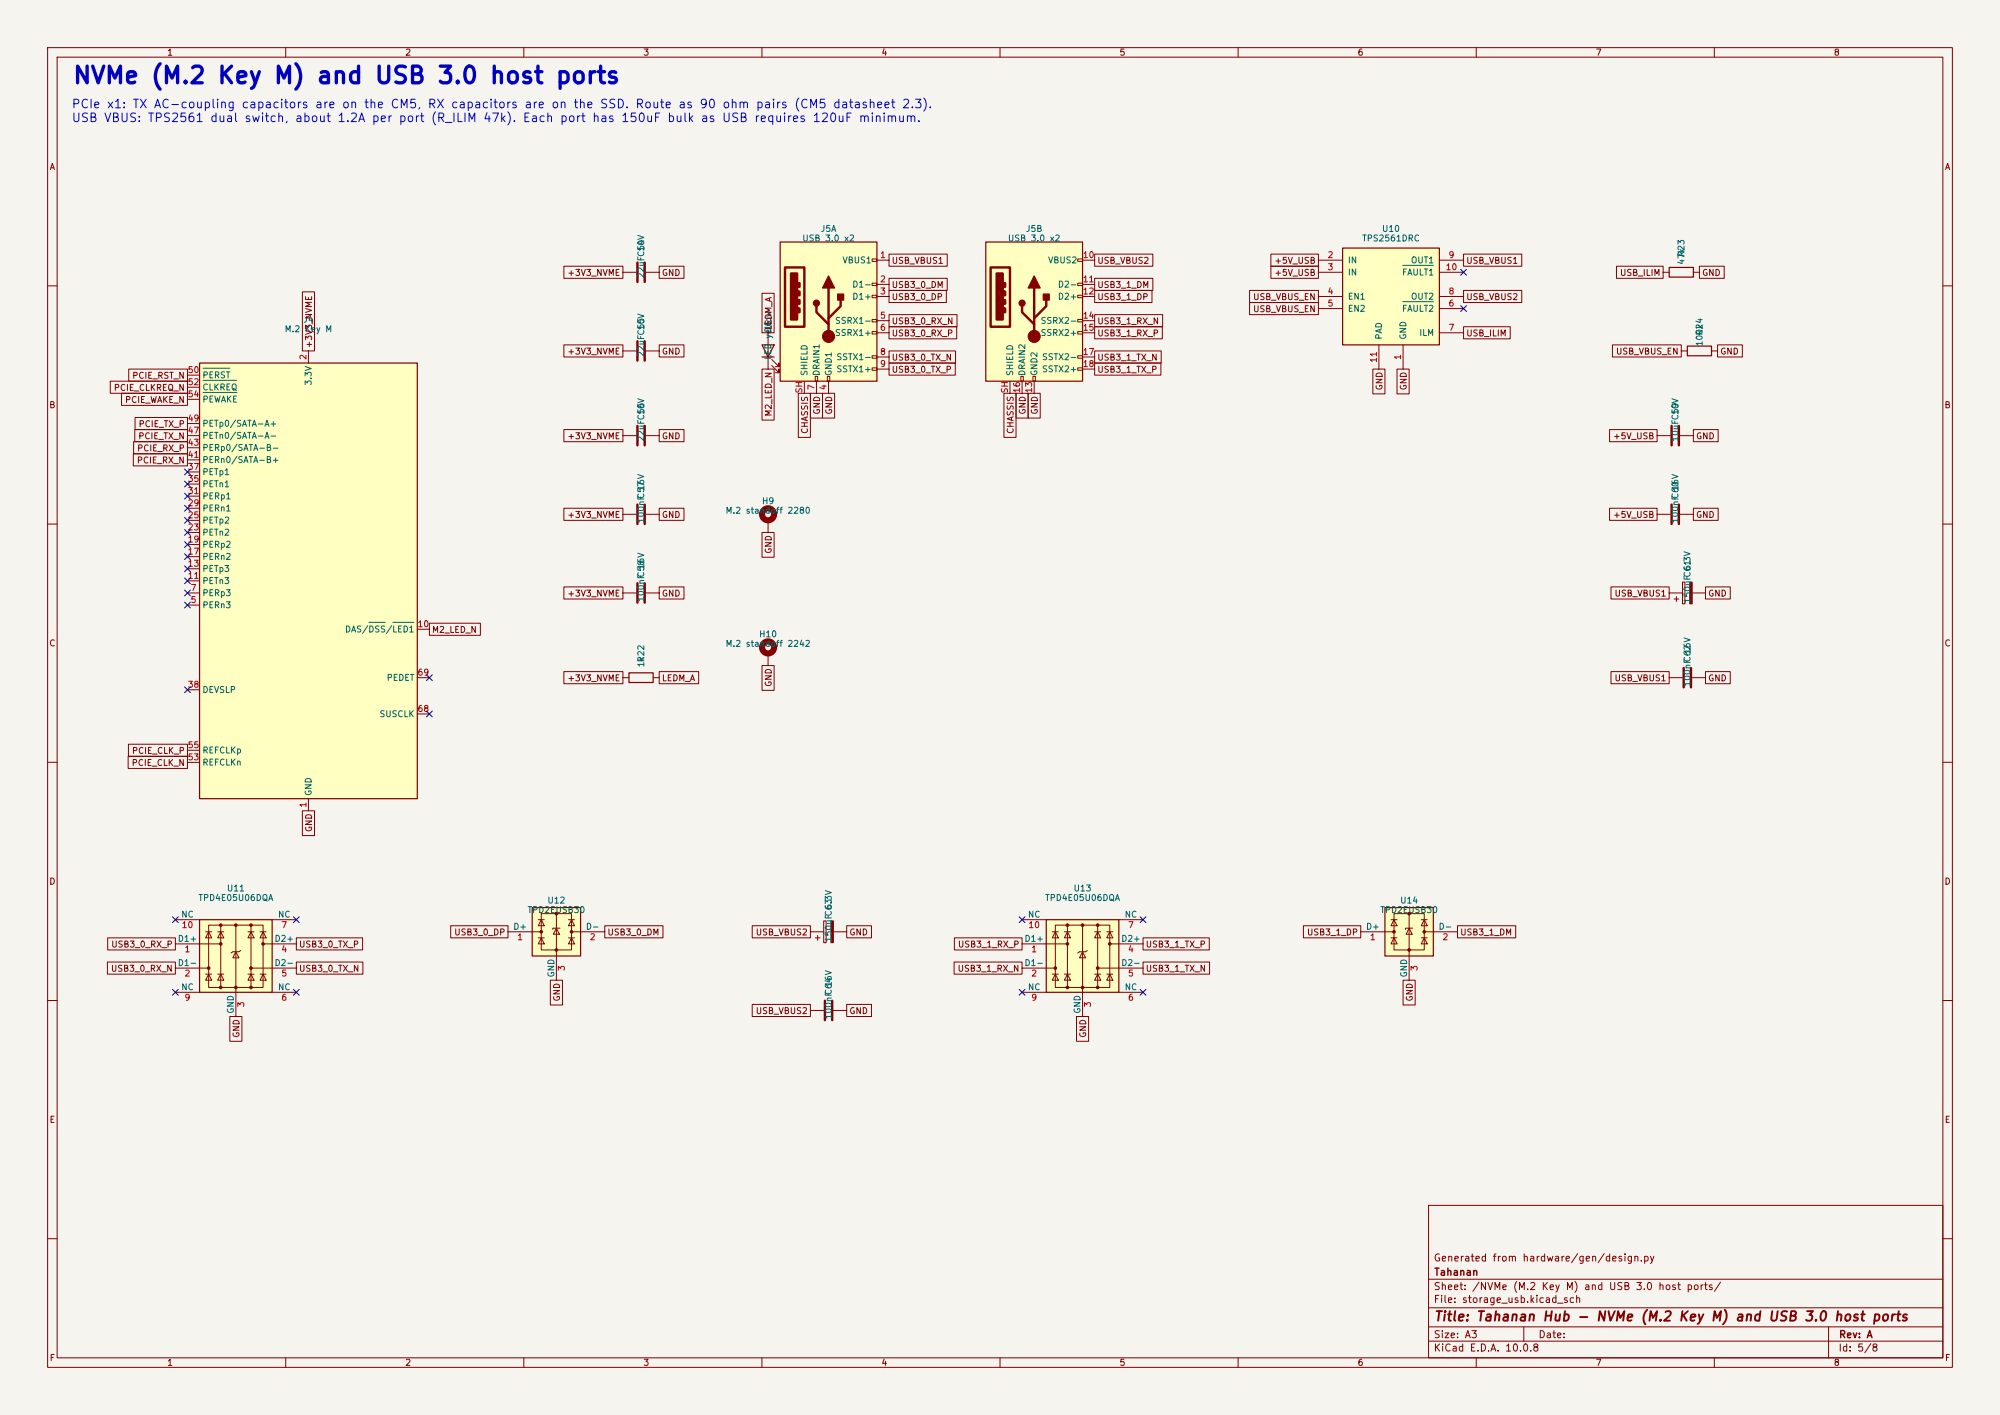
[picture p11: page 5]

USB3_1_DM NVMe (M.2 Key M) and USB 3.0 host ports

PCIe x1: TX AC-coupling capacitors are on the CM5, RX capacitors are on the SSD. Route as 90 ohm pairs (CM5 datasheet 2.3).
USB VBUS: TPS2561 dual switch, about 1.2A per port (R_ILIM 47k). Each port has 150uF bulk as USB requires 120uF minimum.

1 3.3V 2 PERn3 5 PERp3 7 DAS/DSS/LED1 10 PETn3 11 PETp3 13 PERn2 17 PERp2 19 PETn2 23 PETp2 25 PERn1 29 PERp1 31 PETn1 35 PETp1 37 DEVSLP 38 PERn0/SATA-B+ 41 PERp0/SATA-B- 43 PETn0/SATA-A- 47 PETp0/SATA-A+ 49 PERST 50 CLKREQ 52 REFCLKn 53 PEWAKE 54 REFCLKp 55

Generated from hardware/gen/design.py D+

Tahanan
Sheet: /NVMe (M.2 Key M) and USB 3.0 host ports/
File: storage_usb.kicad_sch
Title: Tahanan Hub - NVMe (M.2 Key M) and USB 3.0 host ports

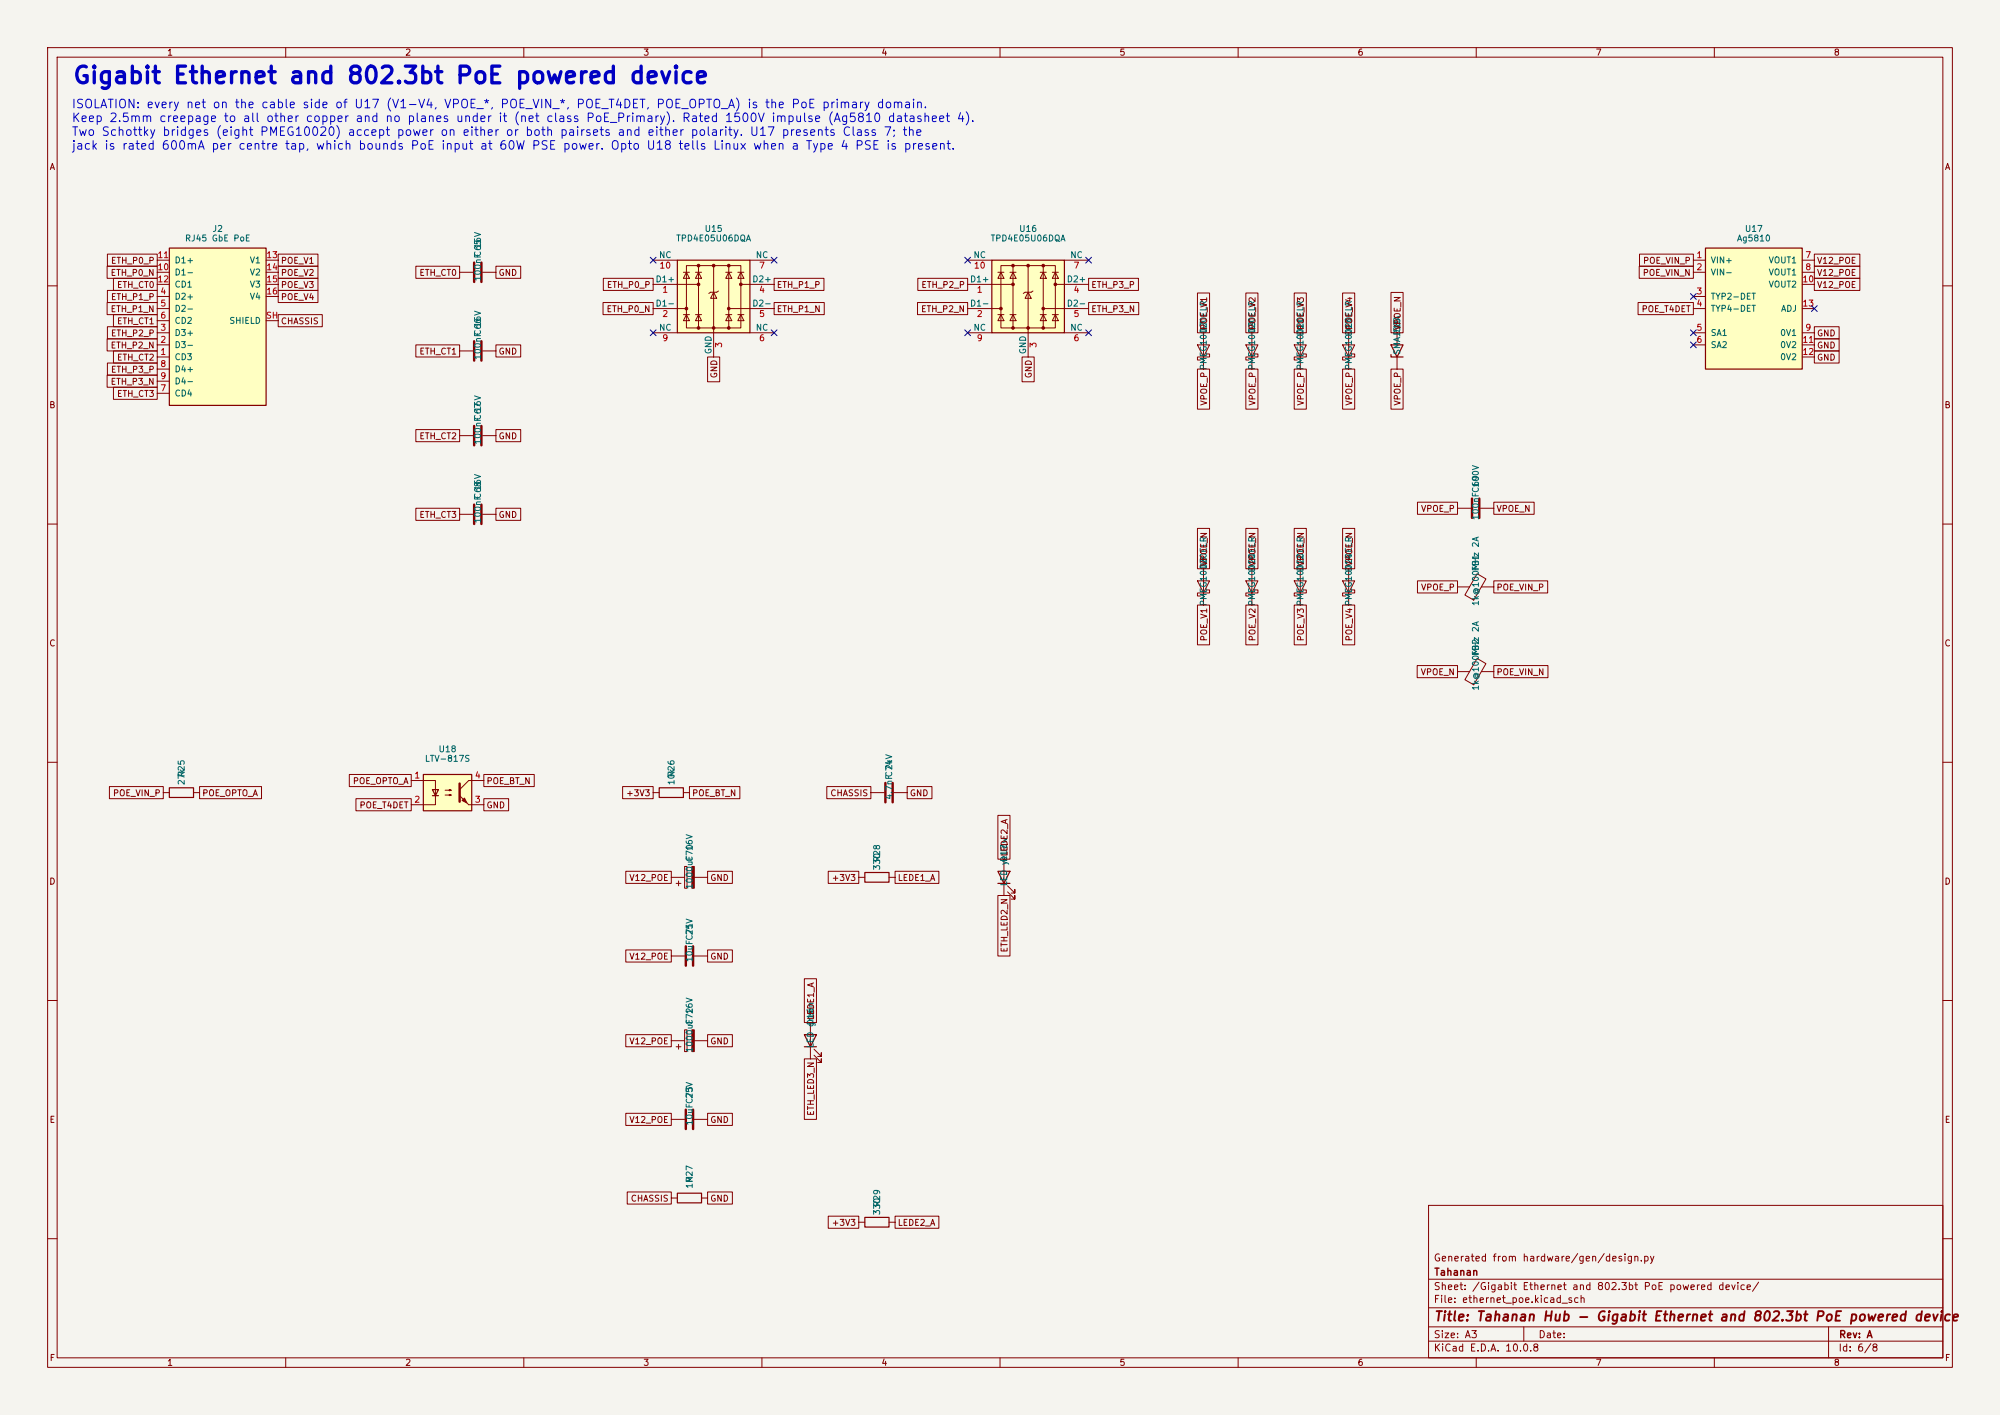
[picture p12: page 6]

Gigabit Ethernet and 802.3bt PoE powered device

ISOLATION: every net on the cable side of U17 (V1-V4, VPOE_*, POE_VIN_*, POE_T4DET, POE_OPTO_A) is the PoE primary domain.
Keep 2.5mm creepage to all other copper and no planes under it (net class PoE_Primary). Rated 1500V impulse (Ag5810 datasheet 4).
Two Schottky bridges (eight PMEG10020) accept power on either or both pairsets and either polarity. U17 presents Class 7; the
jack is rated 600mA per centre tap, which bounds PoE input at 60W PSE power. Opto U18 tells Linux when a Type 4 PSE is present.

Generated from hardware/gen/design.py
Tahanan
Sheet: /Gigabit Ethernet and 802.3bt PoE powered device/
File: ethernet_poe.kicad_sch
Title: Tahanan Hub - Gigabit Ethernet and 802.3bt PoE powered device

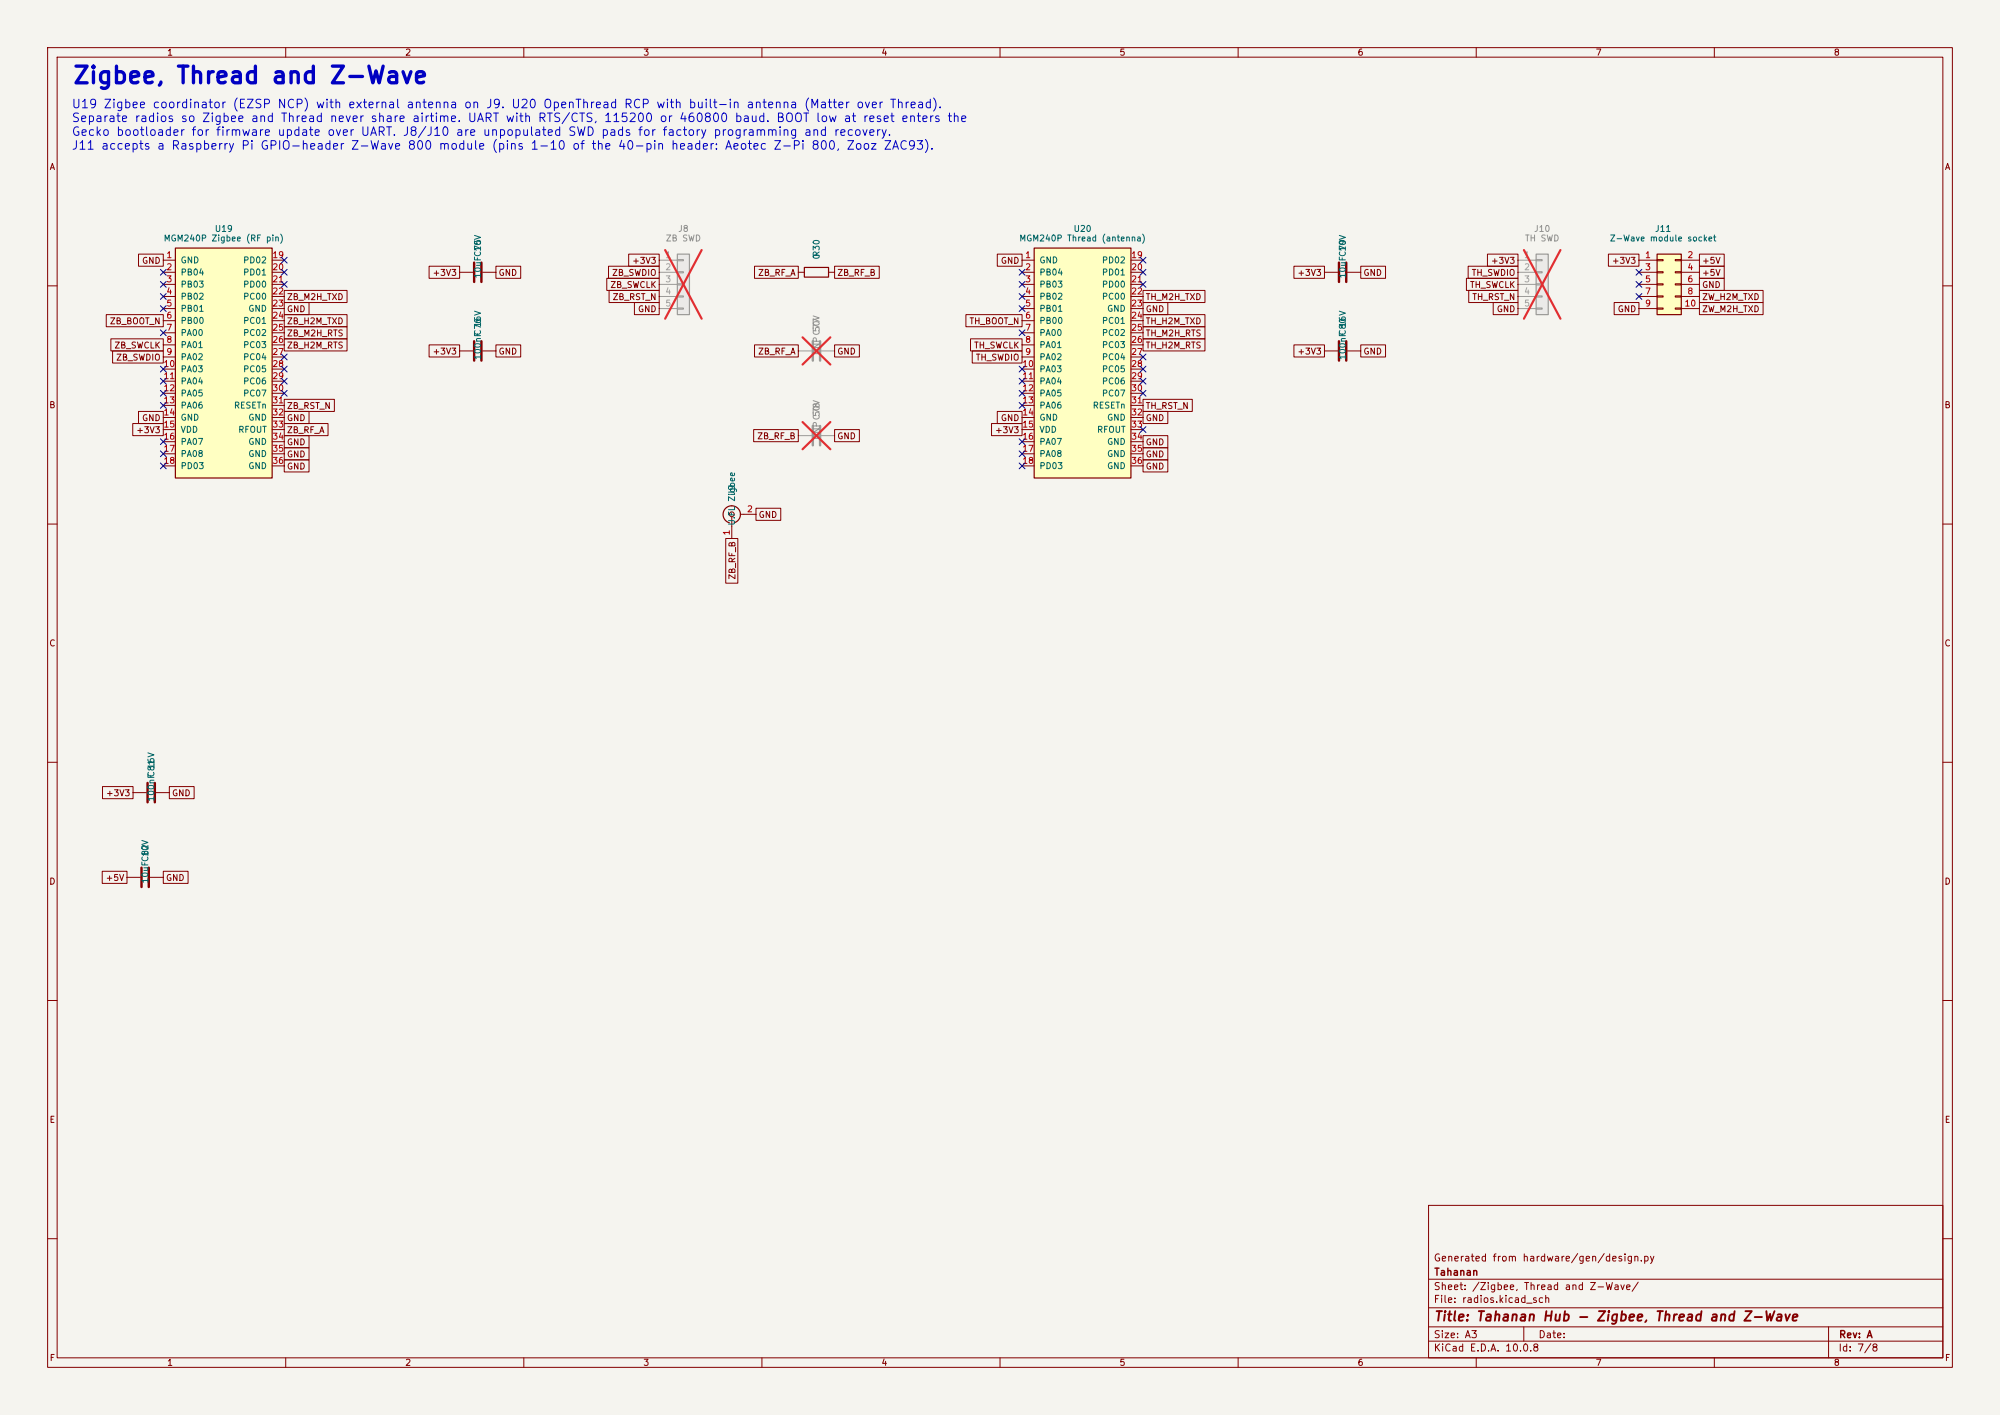
[picture p13: page 7]

U19 Zigbee coordinator (EZSP NCP) with external antenna on J9. U20 OpenThread RCP with built-in antenna (Matter over Thread).
Separate radios so Zigbee and Thread never share airtime. UART with RTS/CTS, 115200 or 460800 baud. BOOT low at reset enters the
Gecko bootloader for firmware update over UART. J8/J10 are unpopulated SWD pads for factory programming and recovery.
J11 accepts a Raspberry Pi GPIO-header Z-Wave 800 module (pins 1-10 of the 40-pin header: Aeotec Z-Pi 800, Zooz ZAC93).

Z-Wave module socket C78 DNP 50V

Generated from hardware/gen/design.py C81 100nF 16V

Tahanan
Sheet: /Zigbee, Thread and Z-Wave/
File: radios.kicad_sch
Title: Tahanan Hub - Zigbee, Thread and Z-Wave

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
# Title: Tahanan Hub - Audio codec, microphone and speaker output

### File: audio.kicad_sch

### Sheet: /Audio codec, microphone and speaker output/

Tahanan

### Generated from hardware/gen/design.py IOVSS

## 1 IOVDD

2 DVDD

# 3 DOUT 4 DIN 5 WCLK 6 BCLK 7 MCLK 8

SDA 9

SCL 10

VOL/MICDET 11 MICBIAS 12 MIC1LP 13 MIC1RP 14 MIC1LM 15 AVSS 16 AVDD 17 DVSS 18

# SPKM 19 SPKVSS 20 SPKVDD 21

SPKP 22 SPKVDD 24 | HPL 27 HPVDD 28 HPVSS 29 | HPR 30 RESET 31 GPIO1 32 | EP 33 U21
TLV320AIC3100 | C97 1uF 16V
OUT+ | 1

VDD 2 OUT- 3 GND

4 MK1
IM73A135V01

1

# 2 J12 SPEAKER 4R 3W FB3 220R@100MHz 1.4A C87 1uF 16V C96 100nF 16V

FID2

Fiducial FB6 220R@100MHz 1.4A FB5 220R@100MHz 1.4A

FID1

Fiducial | FID4

Fiducial C98 1nF 50V C99 1nF 50V

FID3

Fiducial C92 100nF 16V C86 100nF 16V C85 100nF 16V C83 100nF 16V FB4 220R@100MHz 2A | C90 22uF 10V C91 100nF 16V C84 100nF 16V | C88 1uF 16V
Tri-State 1 | GND

2 OUT VDD 3

4

Y1

12.288MHz R31 10k C89 10uF 10V | C93 100nF 16V | R32 33 R34 100k R33 10k | C95 1uF 16V C94 1uF 16V

1
2
3
SW4 MIC MUTE | MIC_VDD
+3V3 +5V_SPK | MIC_IN_N GND | GND | GND | GND | GND

GND

SPK_M

# SPK_P MIC_ON MIC_VDD GND

GND +3V3A MIC_VDD | MIC_VDD
GND | MIC_OUT_P | MIC_IN_N MIC_OUT_P | MIC_IN_P MIC_VDD | MIC_OUT_N

AUD_MCLK

AUD_MCLK | GND

I2S_BCLK

I2S_WS | MIC_OUT_N +5V_SPK | GND +5V_SPK | GND

GND

AUD_OSC

I2S_SDI | +3V3 +3V3A | GND | GND
AUD_OSC +3V3 +3V3 GND | AUD_RST_N | GND +3V3 | GND +1V8 | GND

GND +1V8 +3V3 +5V_SPK

GND +3V3A | GND +3V3A | +3V3A | GND | +5V_SPK +5V | GND +3V3A | GND

SPK_OUT_P +5V_SPK
SPK_OUT_M +3V3A | +1V8 | +3V3
SPK_P | SPK_OUT_P

I2C1_SCL

SPK_M | SPK_OUT_M

I2C1_SDA

I2S_SDO | MIC_ON | SPK_OUT_P | SPK_OUT_M

GND

GND

AUD_RST_N | MIC_IN_P TLV320AIC3100 is the I2S clock master, clocked by Y1 (12.288MHz = 256 x 48kHz); the CM5 I2S port is the clock consumer. One shared clock for capture and playback keeps the echo-cancellation reference sample-accurate. I2C address 0x18.

MK1 is a bottom-port analog MEMS mic mounted on the bottom side over a 1.0mm acoustic hole. SW4 removes microphone power in hardware (privacy) and GPIO27 reports the state. Class-D output: 2.5W into 4 ohm from +5V.

Audio codec, microphone and speaker output FB3 220R@100MHz 1.4A FB4 220R@100MHz 2A FB5 220R@100MHz 1.4A FB6 220R@100MHz 1.4A
