maglambayan/tahanan/hardware/tahanan.kicad_pcb

## KiCad design hardware/tahanan.kicad_pcb (2026-11-11)

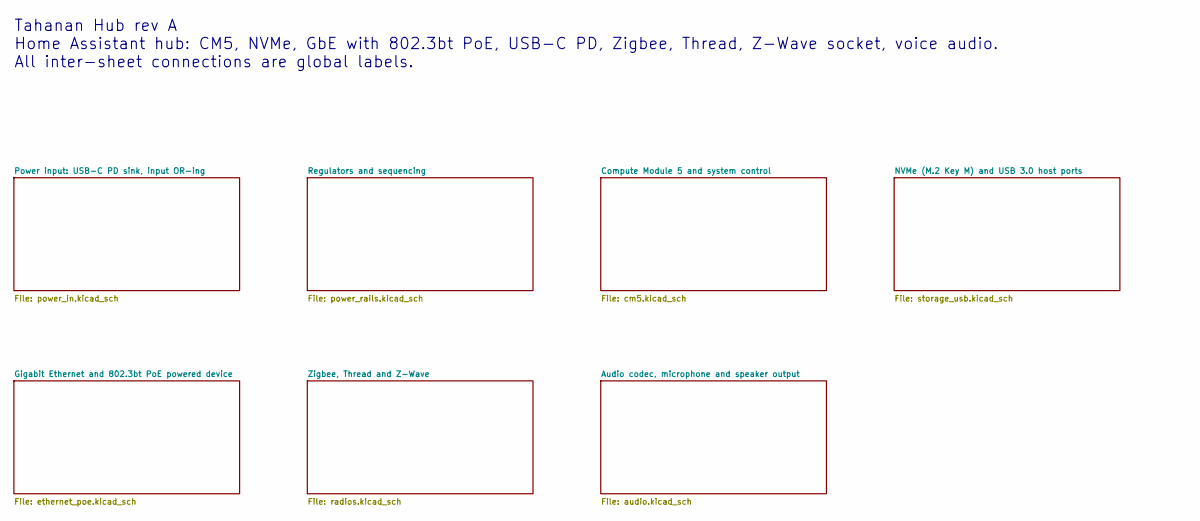
[picture p14: schematic tahanan.kicad_sch, Tahanan Hub - top level]

Notes on the sheet:
Tahanan Hub rev A Home Assistant hub: CM5, NVMe, GbE with 802.3bt PoE, USB-C PD, Zigbee, Thread, Z-Wave socket, voice audio. All inter-sheet connections are global labels.

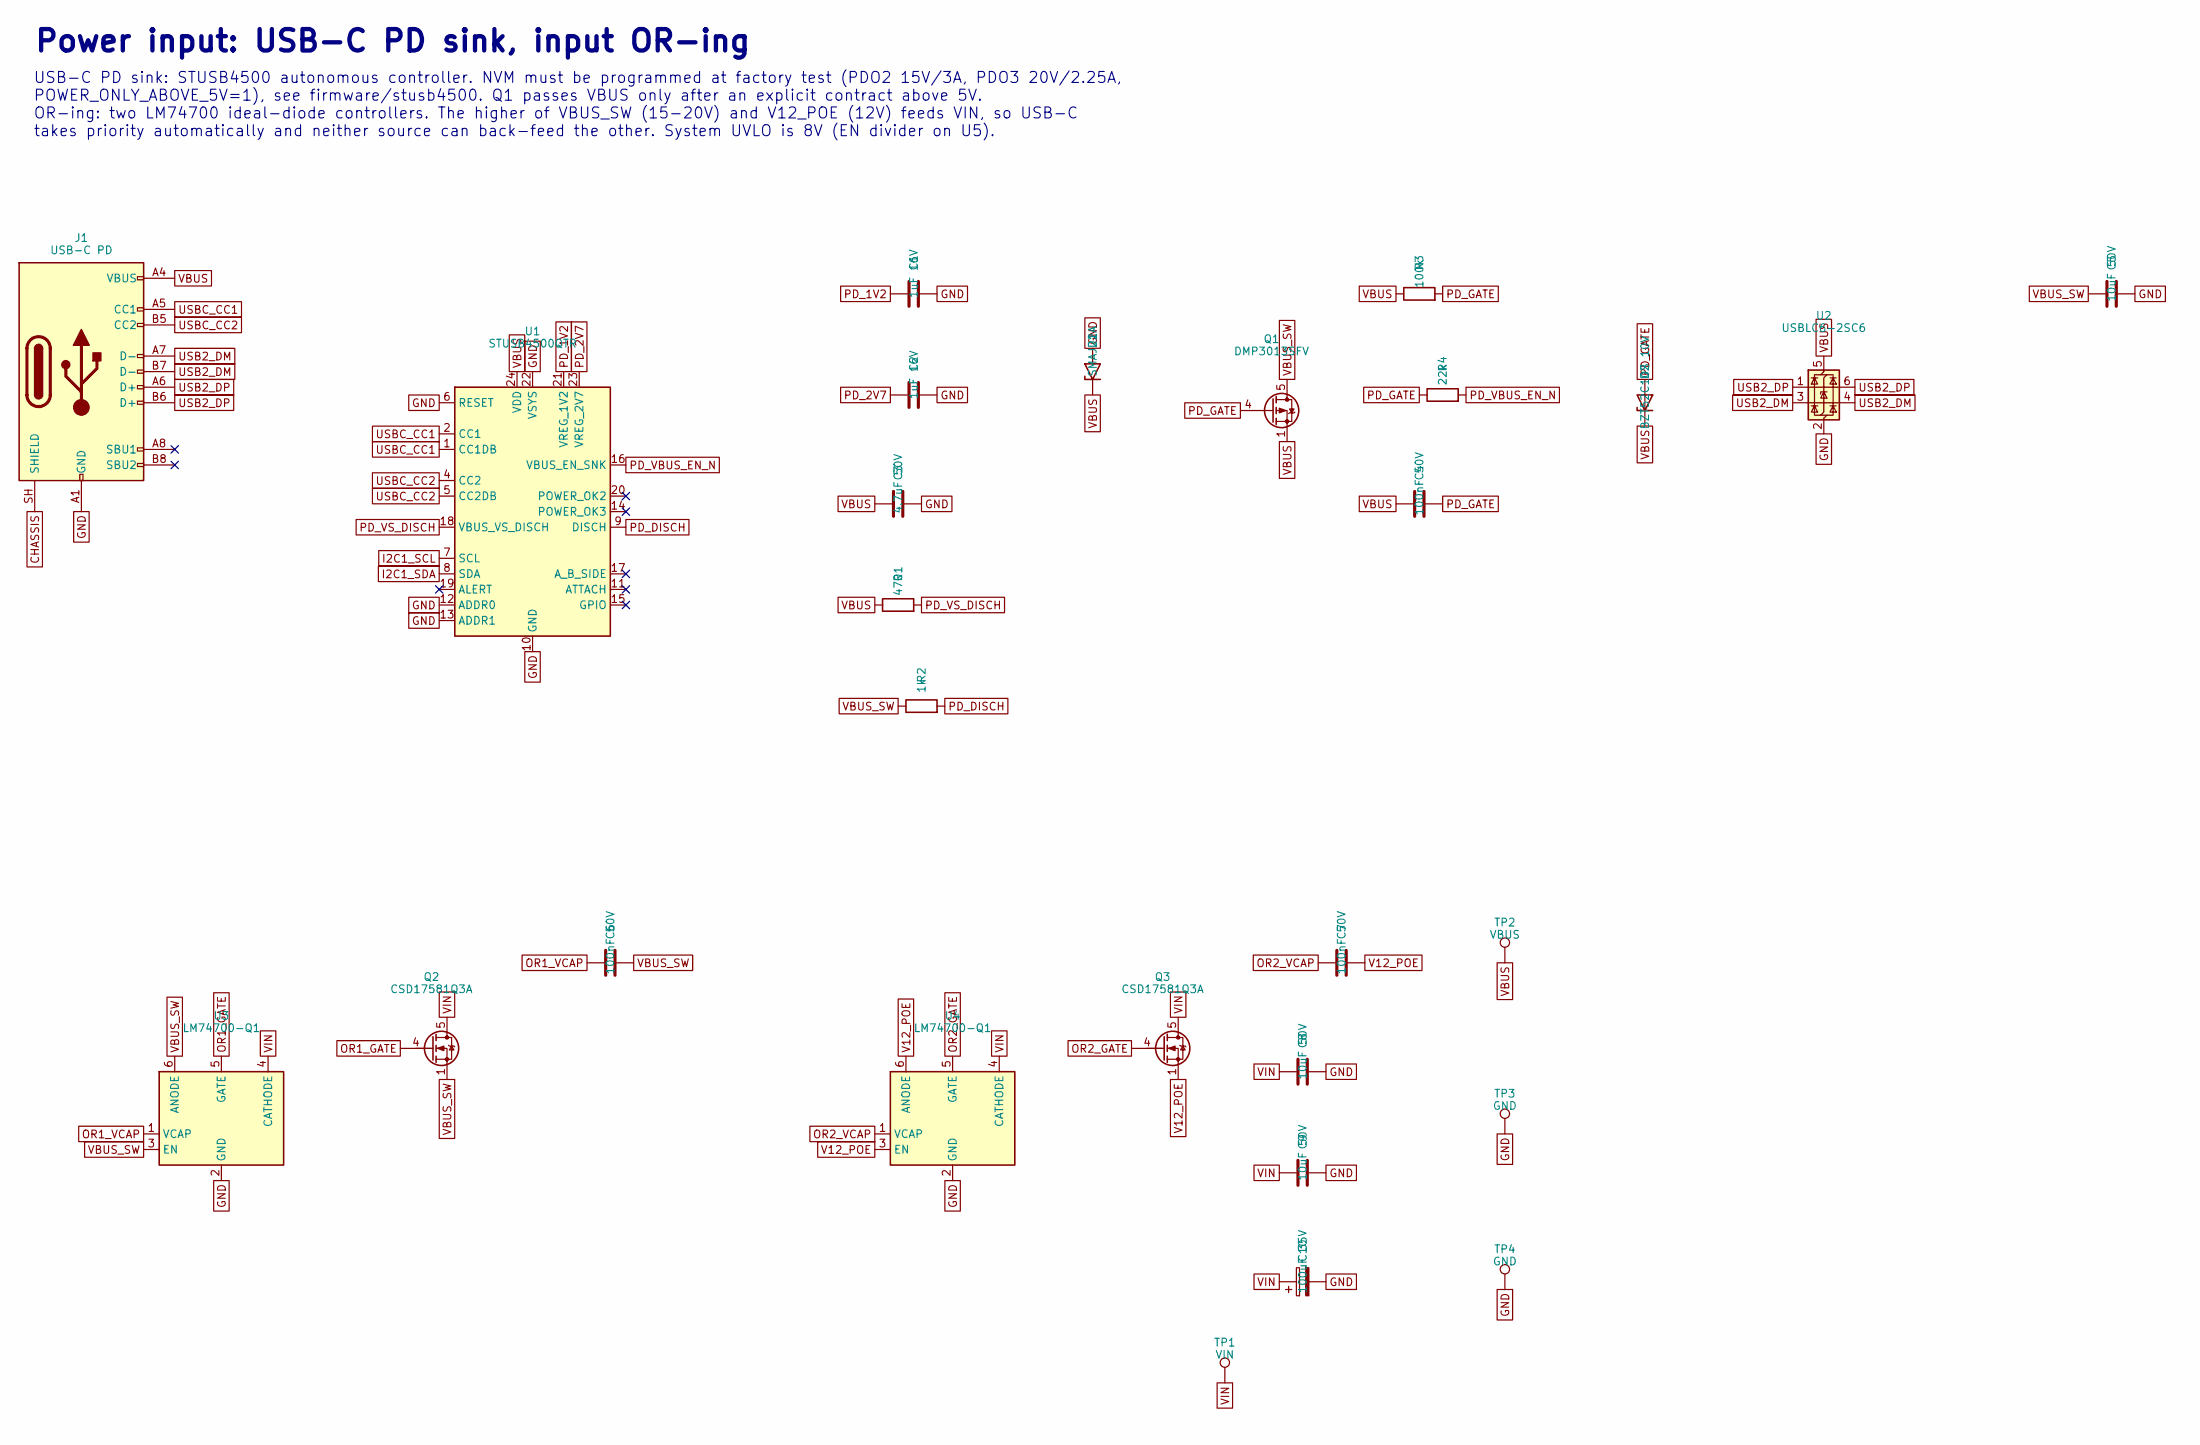
[picture p15: schematic power_in.kicad_sch, Tahanan Hub - Power input: USB-C PD sink, input OR-ing]

Parts:
C1, C2: 1uF 16V; C_0402_1005Metric; MPN CL05A105KO5NNNC
C3: 4.7uF 50V; C_0805_2012Metric; MPN CL21A475KBQNNNE
C4, C6, C7: 100nF 50V; C_0603_1608Metric; MPN CL10B104KB8NNNC
C5, C8, C9: 10uF 50V; C_1210_3225Metric; MPN CL32B106KBJNNNE
C10: 100uF 35V; CP_Elec_6.3x7.7; MPN EEE-FT1V101AP
D1: SMAJ22A; D_SMA; MPN SMAJ22A
D2: BZT52C10S 10V; D_SOD-323; MPN BZT52C10S-7-F
J1: USB-C PD; USB_C_Receptacle_GCT_USB4105-xx-A_16P_TopMnt_Horizontal; MPN USB4105-GF-A
Q1: DMP3013SFV; Diodes_PowerDI3333-8; MPN DMP3013SFV-7
Q2, Q3: CSD17581Q3A; VSON-8_3.3x3.3mm_P0.65mm_NexFET; MPN CSD17581Q3A
R1: 470; R_0402_1005Metric; MPN RC0402FR-07470RL
R2: 1k; R_0603_1608Metric; MPN RC0603FR-071kL
R3: 100k; R_0402_1005Metric; MPN RC0402FR-07100kL
R4: 22k; R_0402_1005Metric; MPN RC0402FR-0722kL
TP1: VIN; TestPoint_Pad_D1.5mm
TP2: VBUS; TestPoint_Pad_D1.5mm
TP3, TP4: GND; TestPoint_Pad_D1.5mm
U1: STUSB4500QTR; QFN-24-1EP_4x4mm_P0.5mm_EP2.7x2.7mm; MPN STUSB4500QTR
U2: USBLC6-2SC6; SOT-23-6; MPN USBLC6-2SC6
U3, U4: LM74700-Q1; SOT-23-6; MPN LM74700QDBVRQ1

Connections:
CHASSIS: J1.SH (SHIELD); also elsewhere on the board
GND: C1.2, C2.2, C3.2, C5.2, C8.2, C9.2, C10.2, D1.2 (A2), J1.A1 (GND), J1.A12 (GND), J1.B1 (GND), J1.B12 (GND), TP3.1, TP4.1, U1.6 (RESET), U1.10 (GND), U1.12 (ADDR0), U1.13 (ADDR1), U1.22 (VSYS), U1.25 (GND), U2.2 (GND), U3.2 (GND), U4.2 (GND); also elsewhere on the board
I2C1_SCL: U1.7 (SCL); also elsewhere on the board
I2C1_SDA: U1.8 (SDA); also elsewhere on the board
OR1_GATE: Q2.4 (G), U3.5 (GATE)
OR1_VCAP: C6.1, U3.1 (VCAP)
OR2_GATE: Q3.4 (G), U4.5 (GATE)
OR2_VCAP: C7.1, U4.1 (VCAP)
PD_1V2: C1.1, U1.21 (VREG_1V2)
PD_2V7: C2.1, U1.23 (VREG_2V7)
PD_DISCH: R2.2, U1.9 (DISCH)
PD_GATE: C4.2, D2.2 (A), Q1.4 (G), R3.2, R4.1
PD_VBUS_EN_N: R4.2, U1.16 (VBUS_EN_SNK)
PD_VS_DISCH: R1.2, U1.18 (VBUS_VS_DISCH)
USB2_DM: J1.A7 (D-), J1.B7 (D-), U2.3 (I/O2), U2.4 (I/O2); also elsewhere on the board
USB2_DP: J1.A6 (D+), J1.B6 (D+), U2.1 (I/O1), U2.6 (I/O1); also elsewhere on the board
USBC_CC1: J1.A5 (CC1), U1.1 (CC1DB), U1.2 (CC1)
USBC_CC2: J1.B5 (CC2), U1.4 (CC2), U1.5 (CC2DB)
V12_POE: C7.2, Q3.1 (S), Q3.2 (S), Q3.3 (S), U4.3 (EN), U4.6 (ANODE); also elsewhere on the board
VBUS: C3.1, C4.1, D1.1 (A1), D2.1 (K), J1.A4 (VBUS), J1.A9 (VBUS), J1.B4 (VBUS), J1.B9 (VBUS), Q1.1 (S), Q1.2 (S), Q1.3 (S), R1.1, R3.1, TP2.1, U1.24 (VDD), U2.5 (VBUS)
VBUS_SW: C5.1, C6.2, Q1.5 (D), Q2.1 (S), Q2.2 (S), Q2.3 (S), R2.1, U3.3 (EN), U3.6 (ANODE)
VIN: C8.1, C9.1, C10.1, Q2.5 (D), Q3.5 (D), TP1.1, U3.4 (CATHODE), U4.4 (CATHODE); also elsewhere on the board

Notes on the sheet:
Power input: USB-C PD sink, input OR-ing
USB-C PD sink: STUSB4500 autonomous controller. NVM must be programmed at factory test (PDO2 15V/3A, PDO3 20V/2.25A, POWER_ONLY_ABOVE_5V=1), see firmware/stusb4500. Q1 passes VBUS only after an explicit contract above 5V. OR-ing: two LM74700 ideal-diode controllers. The higher of VBUS_SW (15-20V) a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

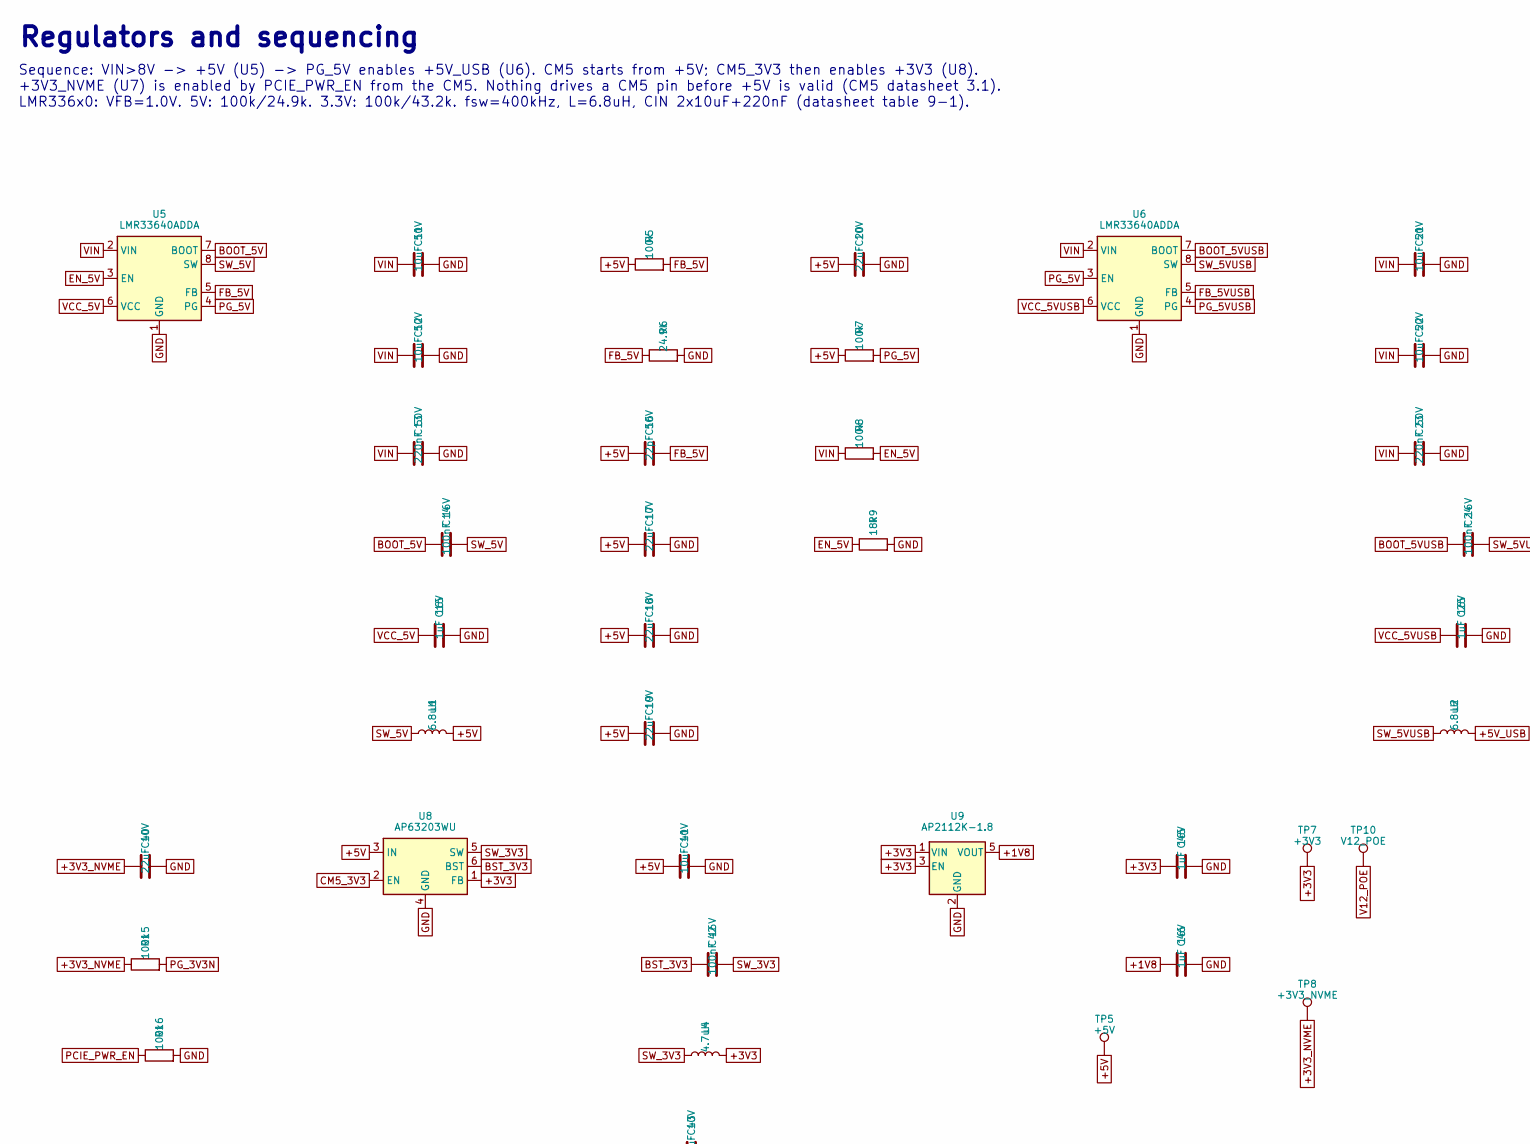
[picture p16: schematic power_rails.kicad_sch, Tahanan Hub - Regulators and sequencing, part in row 1, column 1]

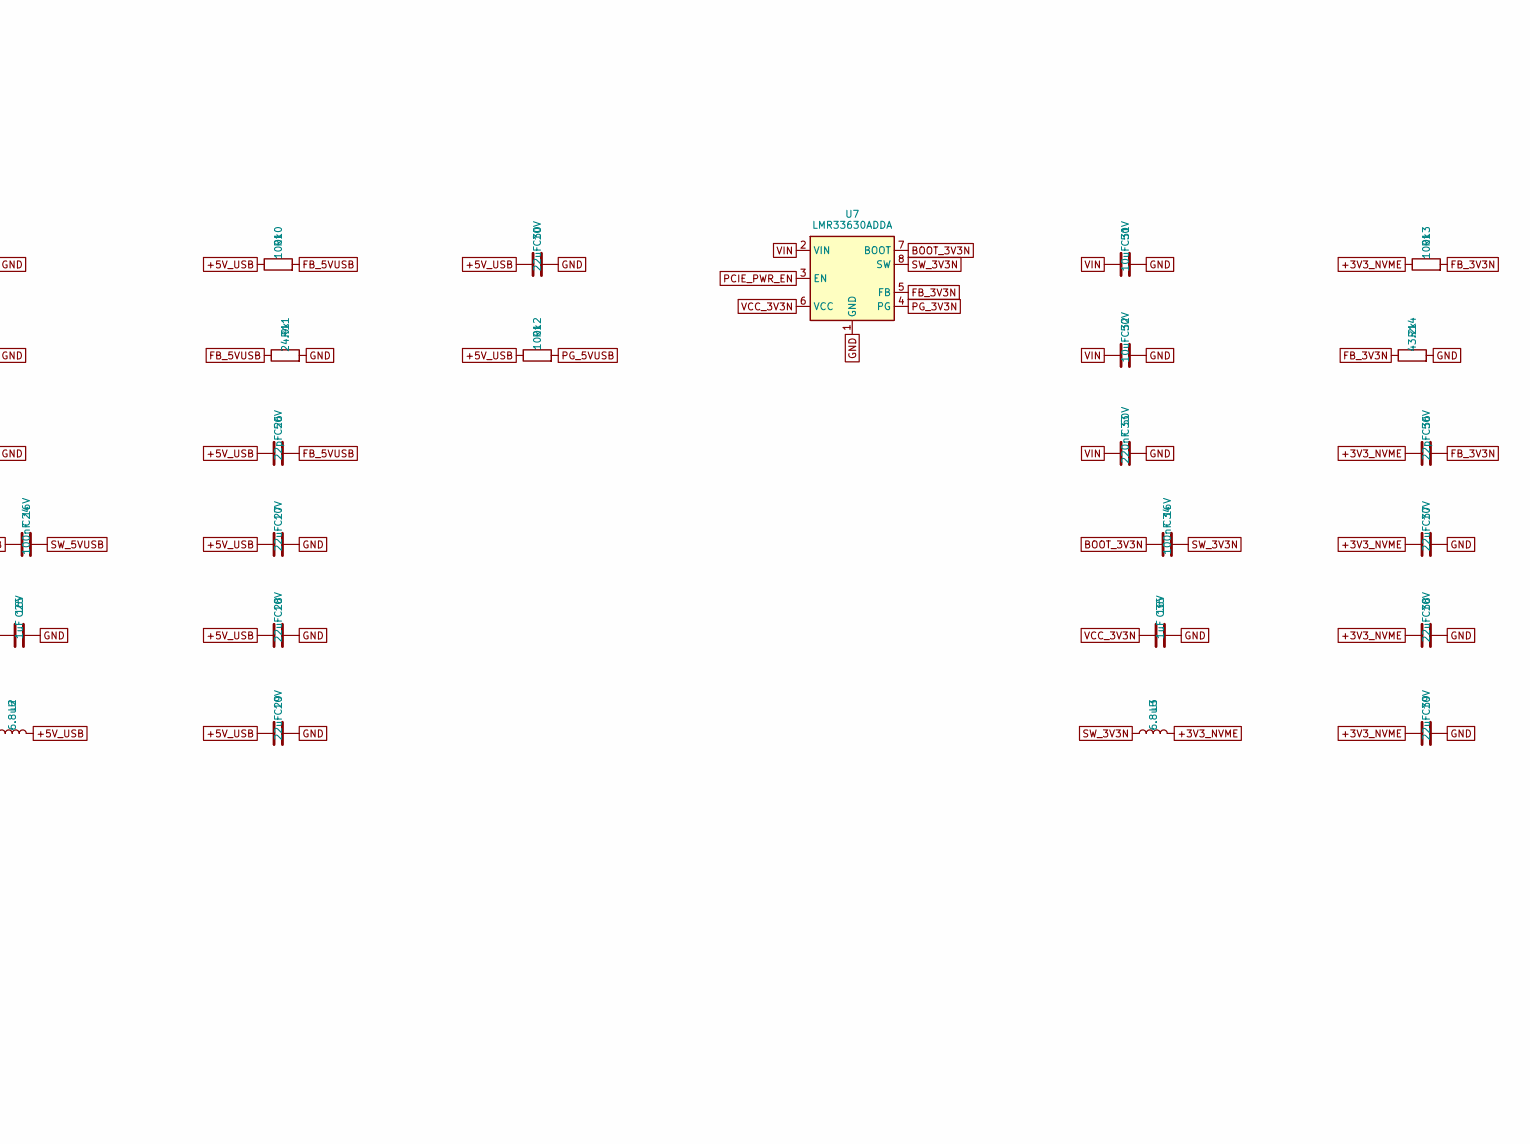
[picture p17: schematic power_rails.kicad_sch, Tahanan Hub - Regulators and sequencing, part in row 1, column 2]

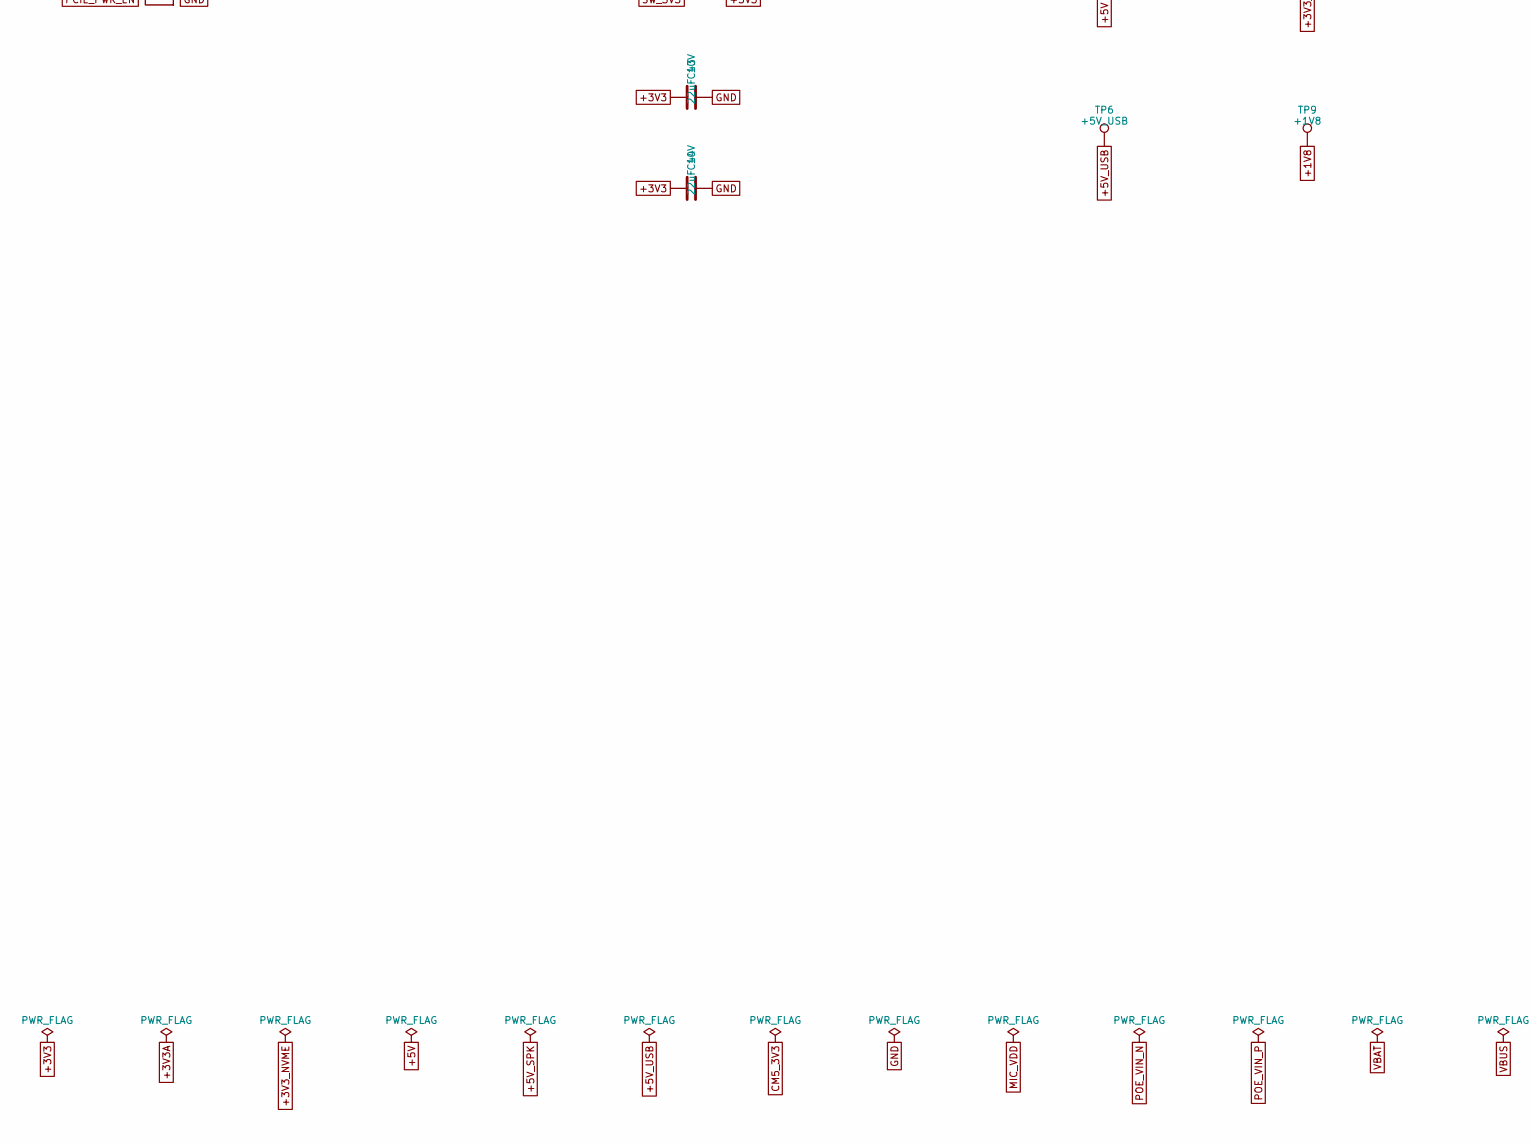
[picture p18: schematic power_rails.kicad_sch, Tahanan Hub - Regulators and sequencing, part in row 2, column 1]

Parts:
C11, C12, C21, C22, C31, C32: 10uF 50V; C_1210_3225Metric; MPN CL32B106KBJNNNE
C13, C23, C33: 220nF 50V; C_0603_1608Metric; MPN CL10B224KB8NNNC
C14, C24, C34, C42: 100nF 16V; C_0402_1005Metric; MPN CL05B104KO5NNNC
C15, C25, C35, C45, C46: 1uF 16V; C_0402_1005Metric; MPN CL05A105KO5NNNC
C16, C26, C36: 22pF 50V; C_0402_1005Metric; MPN CL05C220JB5NNNC
C17, C18, C19, C20, C27, C28, C29, C30, C37, C38, C39, C40, C43, C44: 22uF 10V; C_0805_2012Metric; MPN CL21A226MPQNNNE
C41: 10uF 10V; C_0603_1608Metric; MPN CL10A106KP8NNNC
L1, L2, L3: 6.8uH; L_Bourns_SRP1038C_10.0x10.0mm; MPN SRP1038CC-6R8M
L4: 4.7uH; L_Bourns-SRN4018; MPN SRN4018-4R7M
R5, R7, R8, R10, R12, R13, R15, R16: 100k; R_0402_1005Metric; MPN RC0402FR-07100kL
R6, R11: 24.9k; R_0402_1005Metric; MPN RC0402FR-0724k9L
R9: 18k; R_0402_1005Metric; MPN RC0402FR-0718kL
R14: 43.2k; R_0402_1005Metric; MPN RC0402FR-0743k2L
TP5: +5V; TestPoint_Pad_D1.5mm
TP6: +5V_USB; TestPoint_Pad_D1.5mm
TP7: +3V3; TestPoint_Pad_D1.5mm
TP8: +3V3_NVME; TestPoint_Pad_D1.5mm
TP9: +1V8; TestPoint_Pad_D1.5mm
TP10: V12_POE; TestPoint_Pad_D1.5mm
U5, U6: LMR33640ADDA; Texas_HSOP-8-1EP_3.9x4.9mm_P1.27mm_ThermalVias; MPN LMR33640ADDAR
U7: LMR33630ADDA; Texas_HSOP-8-1EP_3.9x4.9mm_P1.27mm_ThermalVias; MPN LMR33630ADDAR
U8: AP63203WU; TSOT-23-6; MPN AP63203WU-7
U9: AP2112K-1.8; SOT-23-5; MPN AP2112K-1.8TRG1

Connections:
+1V8: C46.1, TP9.1, U9.5 (VOUT); also elsewhere on the board
+3V3: C43.1, C44.1, C45.1, L4.2, TP7.1, U8.1 (FB), U9.1 (VIN), U9.3 (EN); also elsewhere on the board
+3V3_NVME: C36.1, C37.1, C38.1, C39.1, C40.1, L3.2, R13.1, R15.1, TP8.1; also elsewhere on the board
+5V: C16.1, C17.1, C18.1, C19.1, C20.1, C41.1, L1.2, R5.1, R7.1, TP5.1, U8.3 (IN); also elsewhere on the board
+5V_USB: C26.1, C27.1, C28.1, C29.1, C30.1, L2.2, R10.1, R12.1, TP6.1; also elsewhere on the board
BOOT_3V3N: C34.1, U7.7 (BOOT)
BOOT_5V: C14.1, U5.7 (BOOT)
BOOT_5VUSB: C24.1, U6.7 (BOOT)
BST_3V3: C42.1, U8.6 (BST)
CM5_3V3: U8.2 (EN); also elsewhere on the board
EN_5V: R8.2, R9.1, U5.3 (EN)
FB_3V3N: C36.2, R13.2, R14.1, U7.5 (FB)
FB_5V: C16.2, R5.2, R6.1, U5.5 (FB)
FB_5VUSB: C26.2, R10.2, R11.1, U6.5 (FB)
GND: C11.2, C12.2, C13.2, C15.2, C17.2, C18.2, C19.2, C20.2, C21.2, C22.2, C23.2, C25.2, C27.2, C28.2, C29.2, C30.2, C31.2, C32.2, C33.2, C35.2, C37.2, C38.2, C39.2, C40.2, C41.2, C43.2, C44.2, C45.2, C46.2, R6.2, R9.2, R11.2, R14.2, R16.2, U5.1 (GND), U5.9 (GND), U6.1 (GND), U6.9 (GND), U7.1 (GND), U7.9 (GND), U8.4 (GND), U9.2 (GND); also elsewhere on the board
PCIE_PWR_EN: R16.1, U7.3 (EN); also elsewhere on the board
PG_3V3N: R15.2, U7.4 (PG)
PG_5V: R7.2, U5.4 (PG), U6.3 (EN)
PG_5VUSB: R12.2, U6.4 (PG)
SW_3V3: C42.2, L4.1, U8.5 (SW)
SW_3V3N: C34.2, L3.1, U7.8 (SW)
SW_5V: C14.2, L1.1, U5.8 (SW)
SW_5VUSB: C24.2, L2.1, U6.8 (SW)
V12_POE: TP10.1; also elsewhere on the board
VCC_3V3N: C35.1, U7.6 (VCC)
VCC_5V: C15.1, U5.6 (VCC)
VCC_5VUSB: C25.1, U6.6 (VCC)
VIN: C11.1, C12.1, C13.1, C21.1, C22.1, C23.1, C31.1, C32.1, C33.1, R8.1, U5.2 (VIN), U6.2 (VIN), U7.2 (VIN); also elsewhere on the board

Notes on the sheet:
Regulators and sequencing
Sequence: VIN>8V -> +5V (U5) -> PG_5V enables +5V_USB (U6). CM5 starts from +5V; CM5_3V3 then enables +3V3 (U8). +3V3_NVME (U7) is enabled by PCIE_PWR_EN from the CM5. Nothing drives a CM5 pin before +5V is valid (CM5 datasheet 3.1). LMR336x0: VFB=1.0V. 5V: 100k/24.9k. 3.3V: 100k/43.2k. fsw=400kHz,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

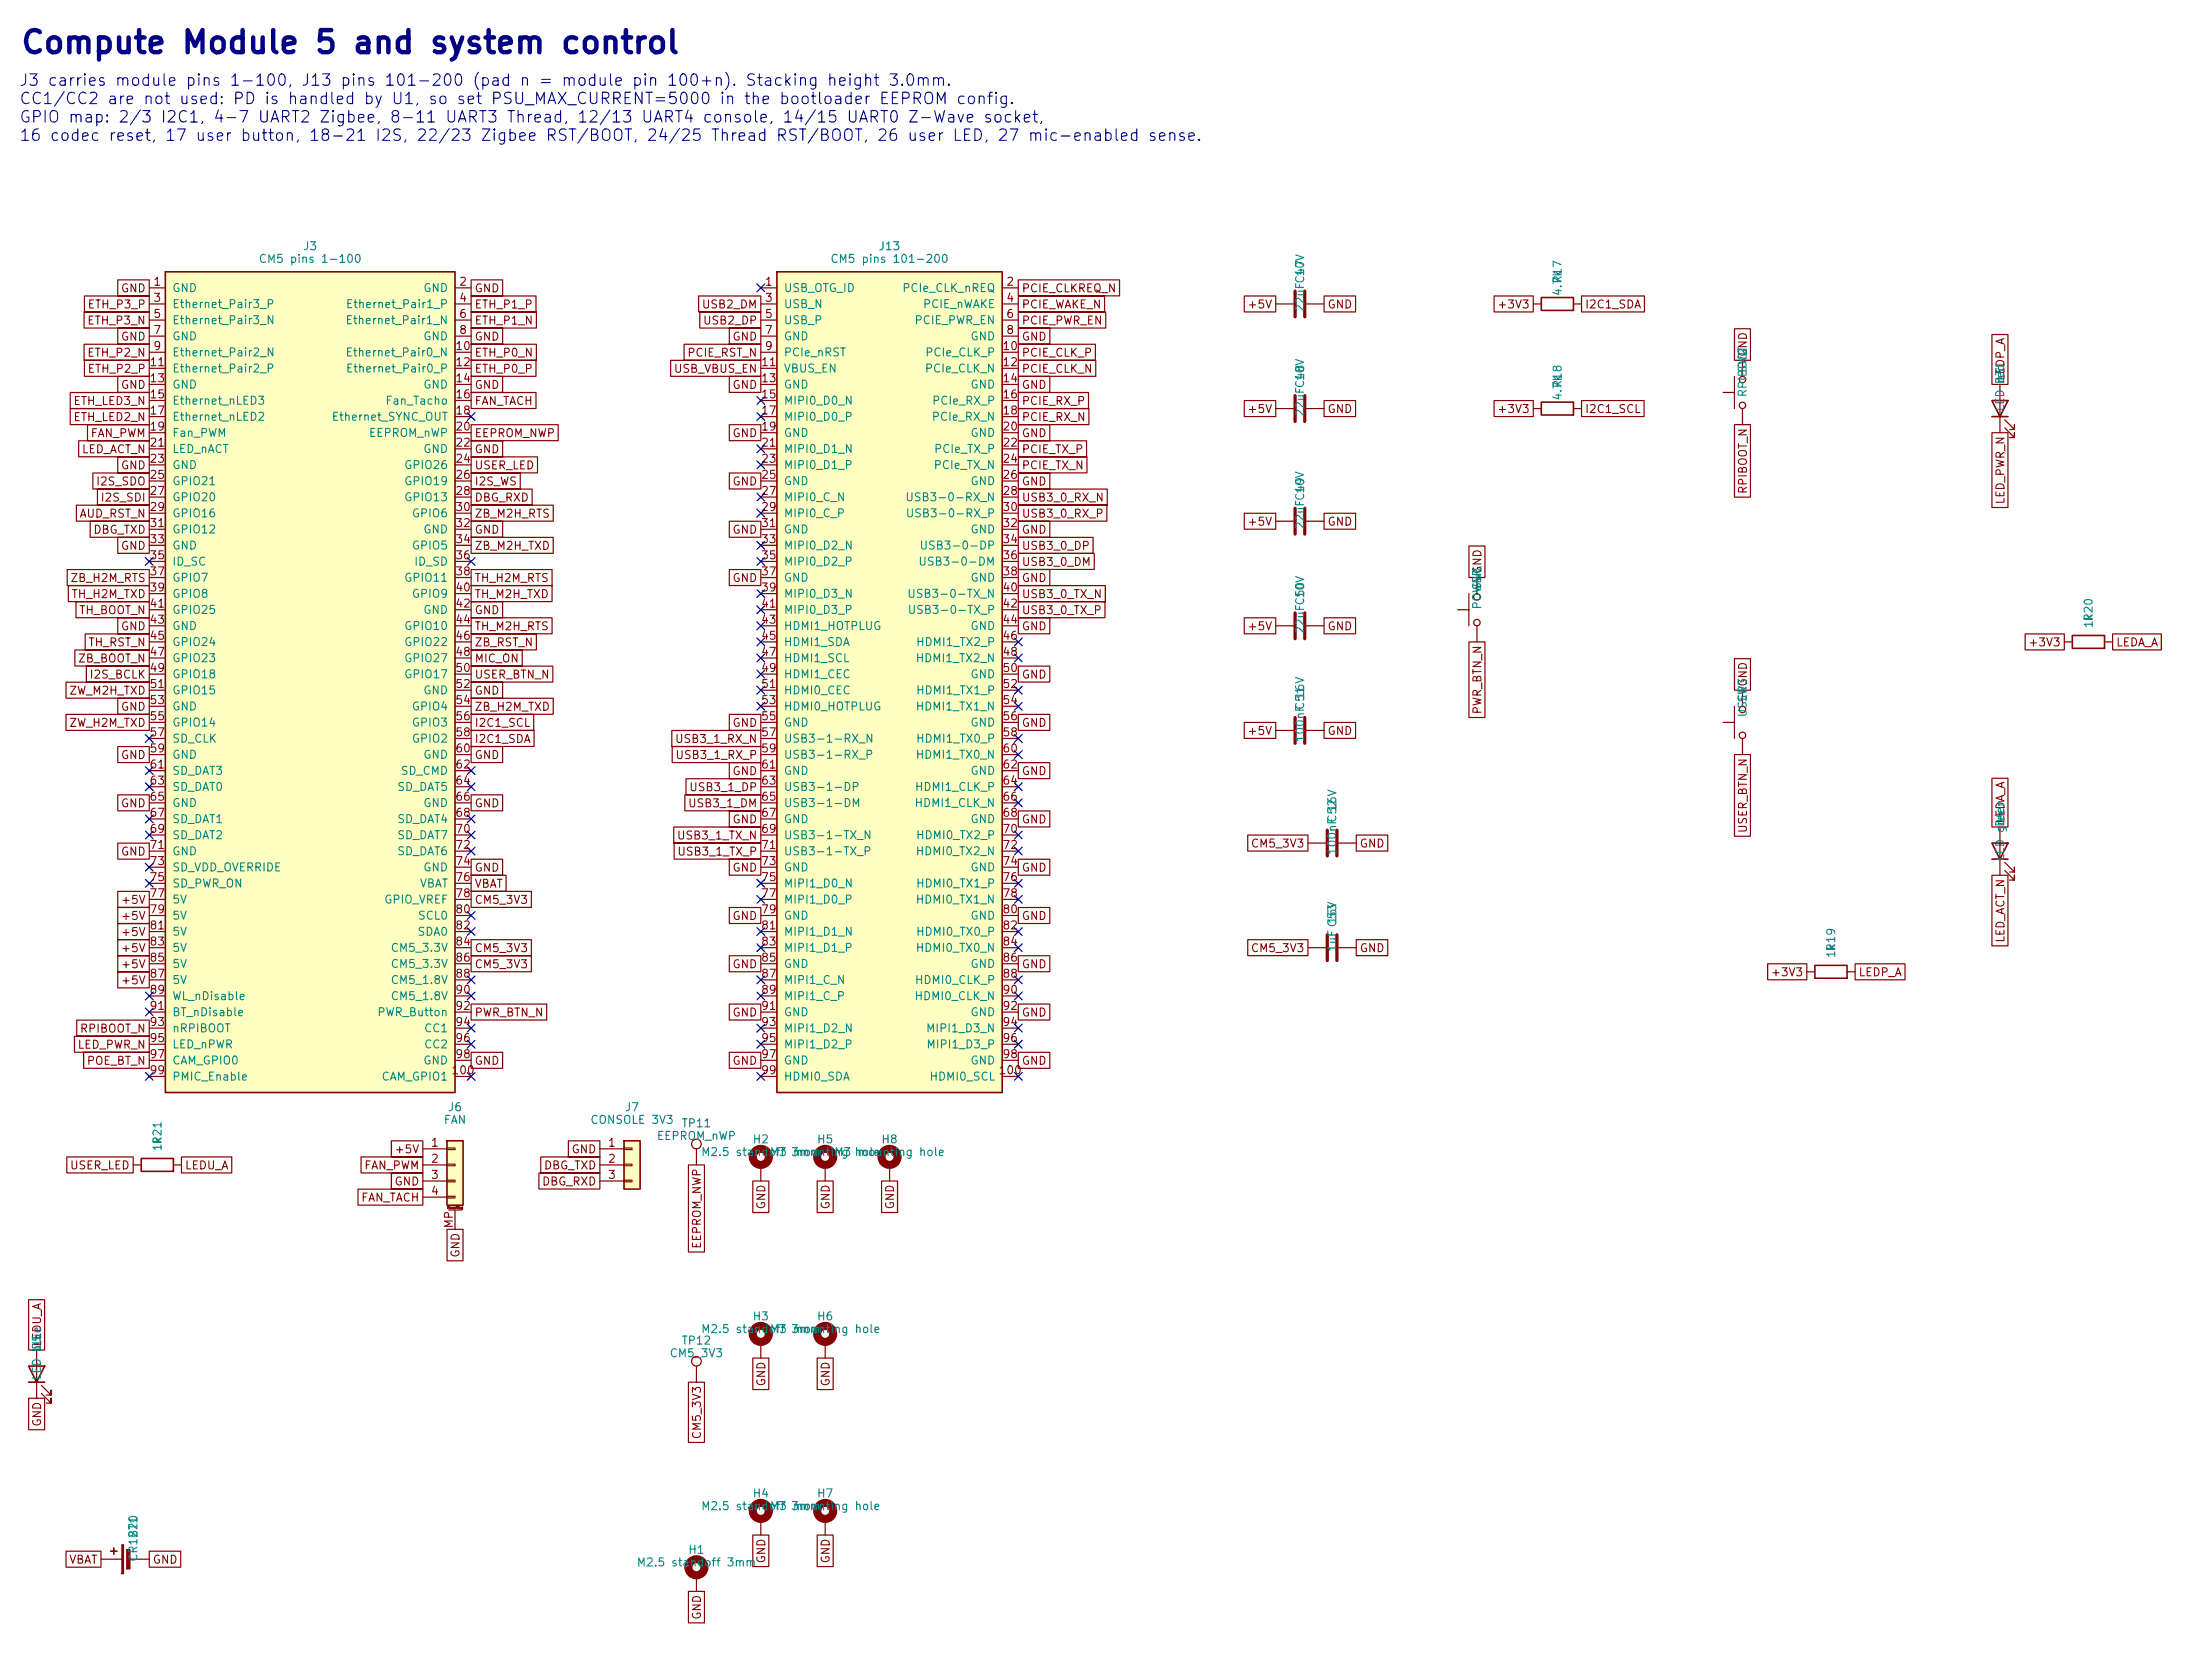
[picture p19: schematic cm5.kicad_sch, Tahanan Hub - Compute Module 5 and system control]

Parts:
BT1: CR1220; BatteryHolder_Keystone_3000_1x12mm; MPN 3000
C47, C48, C49, C50: 22uF 10V; C_0805_2012Metric; MPN CL21A226MPQNNNE
C51, C52: 100nF 16V; C_0402_1005Metric; MPN CL05B104KO5NNNC
C53: 1uF 16V; C_0402_1005Metric; MPN CL05A105KO5NNNC
D3: LED red; LED_0603_1608Metric; MPN 150060RS75000
D4: LED green; LED_0603_1608Metric; MPN 150060GS75000
D5: LED blue; LED_0603_1608Metric; MPN 150060BS75000
H1, H2, H3, H4: M2.5 standoff 3mm; Mounting_Wuerth_WA-SMSI-M2.5_H3mm_9774030151; MPN 9774030151R
H5, H6, H7, H8: M3 mounting hole; MountingHole_3.2mm_M3_Pad_Via
J3: CM5 pins 1-100; Hirose_DF40HC(3.0)-100DS-0.4V_2x50_P0.4mm; MPN DF40HC(3.0)-100DS-0.4V(51)
J6: FAN; JST_SH_SM04B-SRSS-TB_1x04-1MP_P1.00mm_Horizontal; MPN SM04B-SRSS-TB
J7: CONSOLE 3V3; PinHeader_1x03_P2.54mm_Vertical; MPN 61300311121
J13: CM5 pins 101-200; Hirose_DF40HC(3.0)-100DS-0.4V_2x50_P0.4mm; MPN DF40HC(3.0)-100DS-0.4V(51)
R17, R18: 4.7k; R_0402_1005Metric; MPN RC0402FR-074k7L
R19, R20, R21: 1k; R_0402_1005Metric; MPN RC0402FR-071kL
SW1: POWER; SW_Tactile_SPST_NO_Straight_CK_PTS636Sx25SMTRLFS; MPN PTS636SM25FSMTRLFS
SW2: RPIBOOT; SW_Tactile_SPST_NO_Straight_CK_PTS636Sx25SMTRLFS; MPN PTS636SM25FSMTRLFS
SW3: USER; SW_Tactile_SPST_NO_Straight_CK_PTS636Sx25SMTRLFS; MPN PTS636SM25FSMTRLFS
TP11: EEPROM_nWP; TestPoint_Pad_D1.5mm
TP12: CM5_3V3; TestPoint_Pad_D1.5mm

Connections:
+3V3: R17.1, R18.1, R19.1, R20.1; also elsewhere on the board
+5V: C47.1, C48.1, C49.1, C50.1, C51.1, J3.77 (5V), J3.79 (5V), J3.81 (5V), J3.83 (5V), J3.85 (5V), J3.87 (5V), J6.1; also elsewhere on the board
AUD_RST_N: J3.29 (GPIO16); also elsewhere on the board
CM5_3V3: C52.1, C53.1, J3.78 (GPIO_VREF), J3.84 (CM5_3.3V), J3.86 (CM5_3.3V), TP12.1; also elsewhere on the board
DBG_RXD: J3.28 (GPIO13), J7.3
DBG_TXD: J3.31 (GPIO12), J7.2
EEPROM_NWP: J3.20 (EEPROM_nWP), TP11.1
ETH_LED2_N: J3.17 (Ethernet_nLED2); also elsewhere on the board
ETH_LED3_N: J3.15 (Ethernet_nLED3); also elsewhere on the board
ETH_P0_N: J3.10 (Ethernet_Pair0_N); also elsewhere on the board
ETH_P0_P: J3.12 (Ethernet_Pair0_P); also elsewhere on the board
ETH_P1_N: J3.6 (Ethernet_Pair1_N); also elsewhere on the board
ETH_P1_P: J3.4 (Ethernet_Pair1_P); also elsewhere on the board
ETH_P2_N: J3.9 (Ethernet_Pair2_N); also elsewhere on the board
ETH_P2_P: J3.11 (Ethernet_Pair2_P); also elsewhere on the board
ETH_P3_N: J3.5 (Ethernet_Pair3_N); also elsewhere on the board
ETH_P3_P: J3.3 (Ethernet_Pair3_P); also elsewhere on the board
FAN_PWM: J3.19 (Fan_PWM), J6.2
FAN_TACH: J3.16 (Fan_Tacho), J6.4
GND: BT1.2 (-), C47.2, C48.2, C49.2, C50.2, C51.2, C52.2, C53.2, D5.1 (K), H1.1, H2.1, H3.1, H4.1, H5.1, H6.1, H7.1, H8.1, J3.1 (GND), J3.2 (GND), J3.7 (GND), J3.8 (GND), J3.13 (GND), J3.14 (GND), J3.22 (GND), J3.23 (GND), J3.32 (GND), J3.33 (GND), J3.42 (GND), J3.43 (GND), J3.52 (GND), J3.53 (GND), J3.59 (GND), J3.60 (GND), J3.65 (GND), J3.66 (GND), J3.71 (GND), J3.74 (GND), J3.98 (GND), J6.3, J6.MP (MountPin), J7.1, J13.7 (GND), J13.8 (GND), J13.13 (GND), J13.14 (GND), J13.19 (GND), J13.20 (GND), J13.25 (GND), J13.26 (GND), J13.31 (GND), J13.32 (GND), J13.37 (GND), J13.38 (GND), J13.44 (GND), J13.50 (GND), J13.55 (GND), J13.56 (GND), J13.61 (GND), J13.62 (GND), J13.67 (GND), J13.68 (GND), J13.73 (GND), J13.74 (GND), J13.79 (GND), J13.80 (GND), J13.85 (GND), J13.86 (GND), J13.91 (GND), J13.92 (GND), J13.97 (GND), J13.98 (GND), SW1.2, SW2.2, SW3.2; also elsewhere on the board
I2C1_SCL: J3.56 (GPIO3), R18.2; also elsewhere on the board
I2C1_SDA: J3.58 (GPIO2), R17.2; also elsewhere on the board
I2S_BCLK: J3.49 (GPIO18); also elsewhere on the board
I2S_SDI: J3.27 (GPIO20); also elsewhere on the board
I2S_SDO: J3.25 (GPIO21); also elsewhere on the board
I2S_WS: J3.26 (GPIO19); also elsewhere on the board
LEDA_A: D4.2 (A), R20.2
LEDP_A: D3.2 (A), R19.2
LEDU_A: D5.2 (A), R21.2
LED_ACT_N: D4.1 (K), J3.21 (LED_nACT)
LED_PWR_N: D3.1 (K), J3.95 (LED_nPWR)
MIC_ON: J3.48 (GPIO27); also elsewhere on the board
PCIE_CLKREQ_N: J13.2 (PCIe_CLK_nREQ); also elsewhere on the board
PCIE_CLK_N: J13.12 (PCIe_CLK_N); also elsewhere on the board
PCIE_CLK_P: J13.10 (PCIe_CLK_P); also elsewhere on the board
PCIE_PWR_EN: J13.6 (PCIE_PWR_EN); also elsewhere on the board
PCIE_RST_N: J13.9 (PCIe_nRST); also elsewhere on the board
PCIE_RX_N: J13.18 (PCIe_RX_N); also elsewhere on the board
PCIE_RX_P: J13.16 (PCIe_RX_P); also elsewhere on the board
PCIE_TX_N: J13.24 (PCIe_TX_N); also elsewhere on the board
PCIE_TX_P: J13.22 (PCIe_TX_P); also elsewhere on the board
PCIE_WAKE_N: J13.4 (PCIE_nWAKE); also elsewhere on the board
POE_BT_N: J3.97 (CAM_GPIO0); also elsewhere on the board
PWR_BTN_N: J3.92 (PWR_Button), SW1.1
RPIBOOT_N: J3.93 (nRPIBOOT), SW2.1
TH_BOOT_N: J3.41 (GPIO25); also elsewhere on the board
TH_H2M_RTS: J3.38 (GPIO11); also elsewhere on the board
TH_H2M_TXD: J3.39 (GPIO8); also elsewhere on the board
TH_M2H_RTS: J3.44 (GPIO10); also elsewhere on the board
TH_M2H_TXD: J3.40 (GPIO9); also elsewhere on the board
TH_RST_N: J3.45 (GPIO24); also elsewhere on the board
USB2_DM: J13.3 (USB_N); also elsewhere on the board
USB2_DP: J13.5 (USB_P); also elsewhere on the board
USB3_0_DM: J13.36 (USB3-0-DM); also elsewhere on the board
USB3_0_DP: J13.34 (USB3-0-DP); also elsewhere on the board
USB3_0_RX_N: J13.28 (USB3-0-RX_N); also elsewhere on the board
USB3_0_RX_P: J13.30 (USB3-0-RX_P); also elsewhere on the board
USB3_0_TX_N: J13.40 (USB3-0-TX_N); also elsewhere on the board
USB3_0_TX_P: J13.42 (USB3-0-TX_P); also elsewhere on the board
USB3_1_DM: J13.65 (USB3-1-DM); also elsewhere on the board
USB3_1_DP: J13.63 (USB3-1-DP); also elsewhere on the board
USB3_1_RX_N: J13.57 (USB3-1-RX_N); also elsewhere on the board
USB3_1_RX_P: J13.59 (USB3-1-RX_P); also elsewhere on the board
USB3_1_TX_N: J13.69 (USB3-1-TX_N); also elsewhere on the board
USB3_1_TX_P: J13.71 (USB3-1-TX_P); also elsewhere on the board
USB_VBUS_EN: J13.11 (VBUS_EN); also elsewhere on the board
USER_BTN_N: J3.50 (GPIO17), SW3.1
USER_LED: J3.24 (GPIO26), R21.1
VBAT: BT1.1 (+), J3.76 (VBAT)
ZB_BOOT_N: J3.47 (GPIO23); also elsewhere on the board
ZB_H2M_RTS: J3.37 (GPIO7); also elsewhere on the board
ZB_H2M_TXD: J3.54 (GPIO4); also elsewhere on the board
ZB_M2H_RTS: J3.30 (GPIO6); also elsewhere on the board
ZB_M2H_TXD: J3.34 (GPIO5); also elsewhere on the board
ZB_RST_N: J3.46 (GPIO22); also elsewhere on the board
ZW_H2M_TXD: J3.55 (GPIO14); also elsewhere on the board
ZW_M2H_TXD: J3.51 (GPIO15); also elsewhere on the board

Notes on the sheet:
Compute Module 5 and system control
J3 carries module pins 1-100, J13 pins 101-200 (pad n = module pin 100+n). Stacking height 3.0mm. CC1/CC2 are not used: PD is handled by U1, so set PSU_MAX_CURRENT=5000 in the bootloader EEPROM config. GPIO map: 2/3 I2C1, 4-7 UART2 Zigbee, 8-11 UART3 Thread, 12/13 UART4 console, 14/15 UART0 Z-Wave 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
