maglambayan/tahanan/hardware/tahanan.kicad_pcb

## KiCad design hardware/tahanan.kicad_pcb (continued)

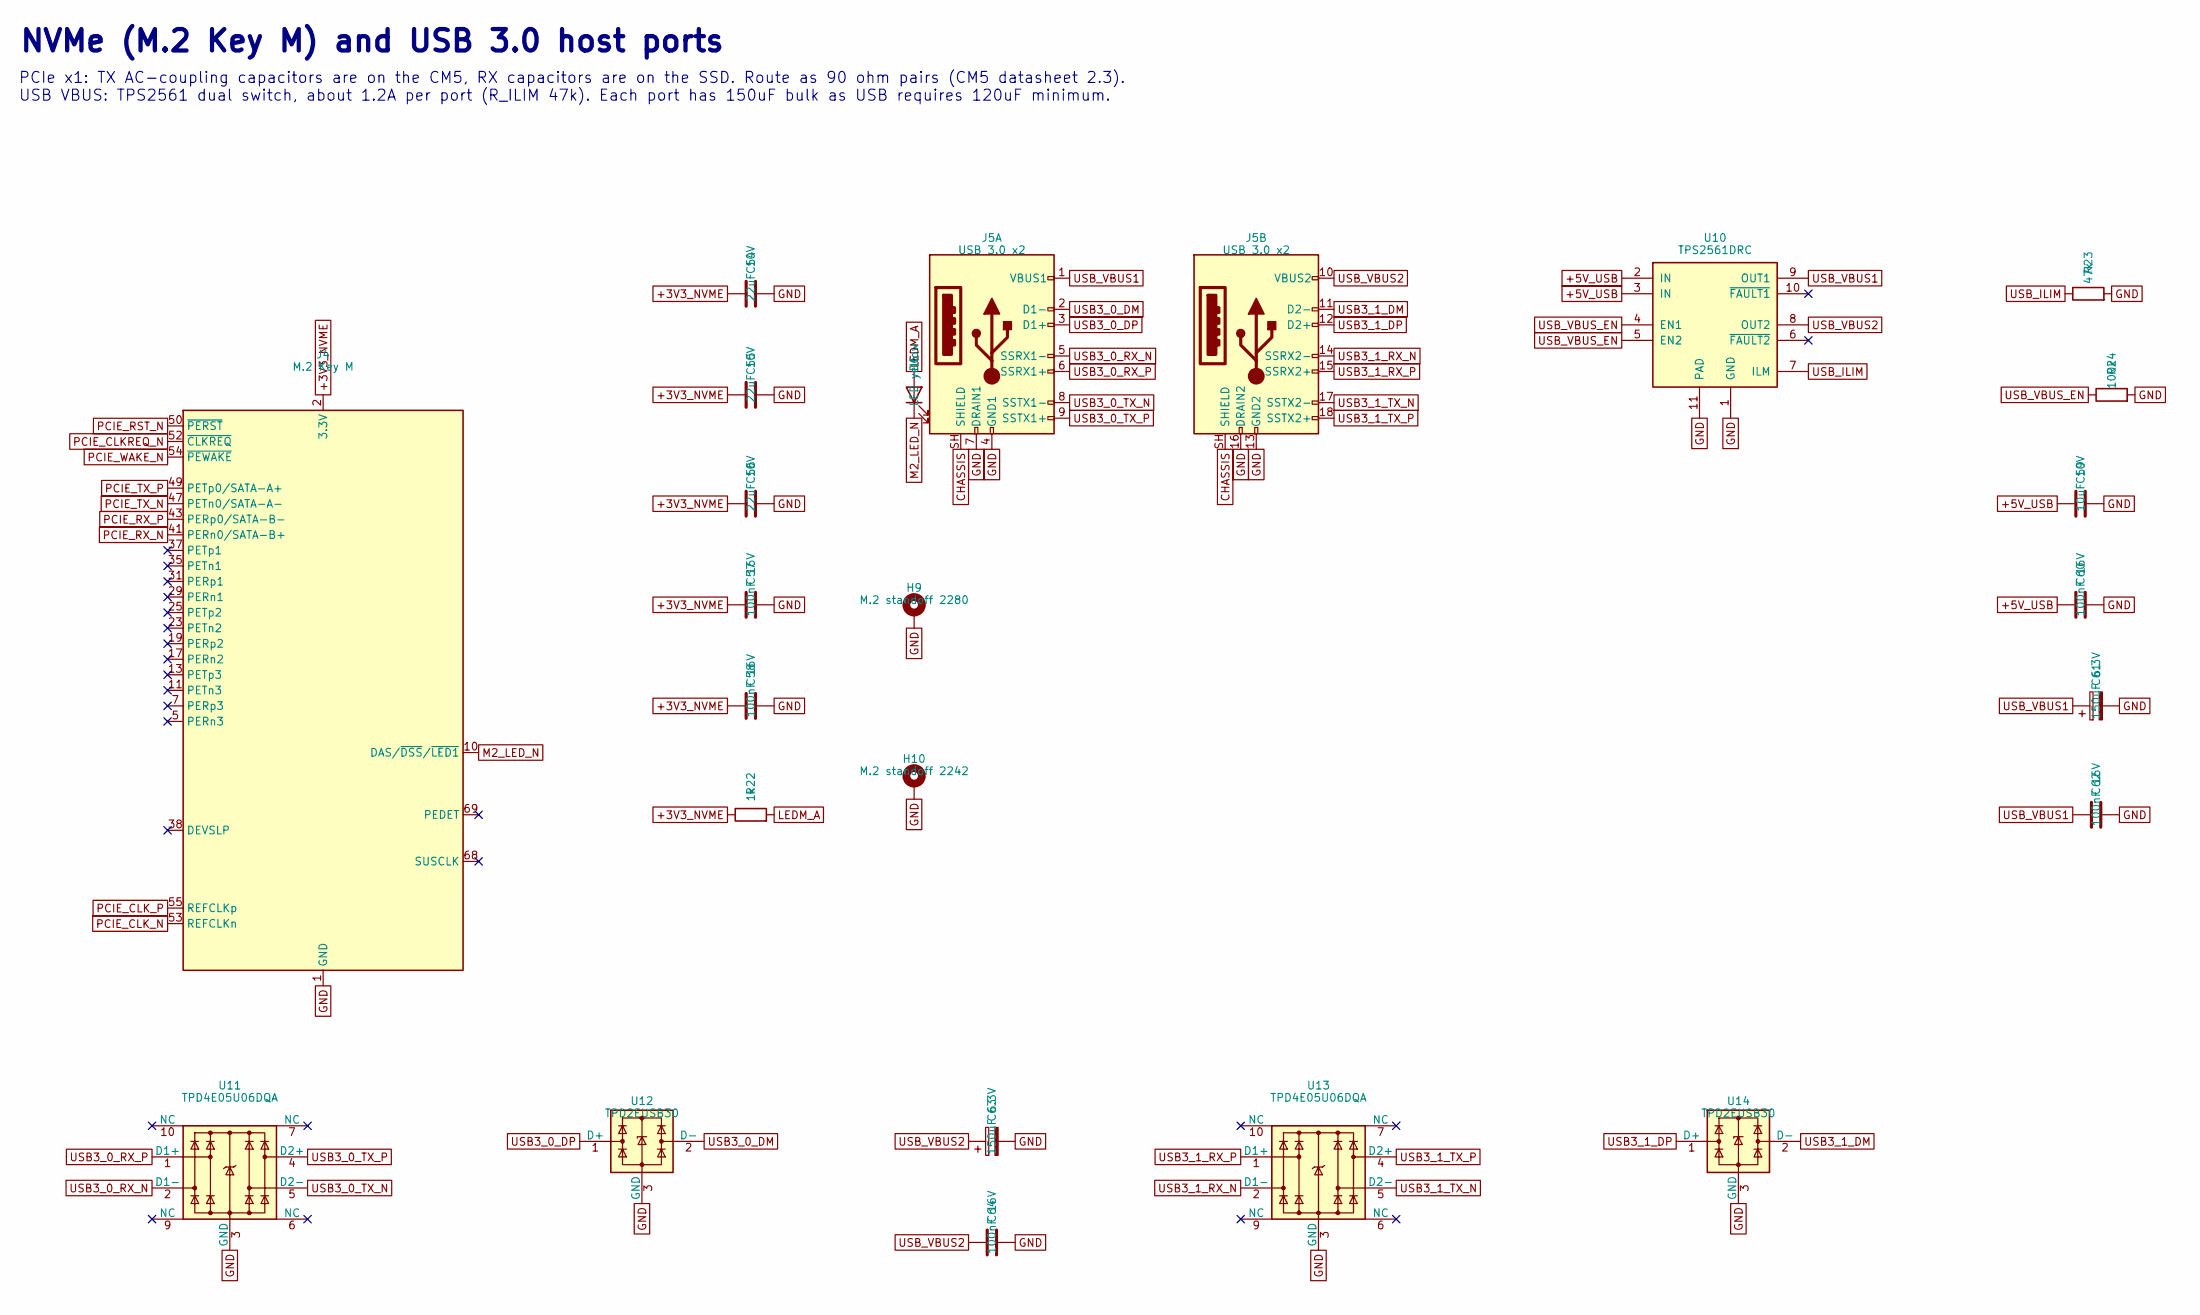
[picture p20: schematic storage_usb.kicad_sch, Tahanan Hub - NVMe (M.2 Key M) and USB 3.0 host ports]

Parts:
C54, C55, C56: 22uF 10V; C_0805_2012Metric; MPN CL21A226MPQNNNE
C57, C58, C60, C62, C64: 100nF 16V; C_0402_1005Metric; MPN CL05B104KO5NNNC
C59: 10uF 10V; C_0603_1608Metric; MPN CL10A106KP8NNNC
C61, C63: 150uF 6.3V; CP_EIA-3528-21_Kemet-B; MPN T520B157M006ATE070
D6: LED yellow; LED_0603_1608Metric; MPN 150060YS75000
H9: M.2 standoff 2280; Mounting_Wuerth_WA-SMSI-M2_H2.5mm_9774025243; MPN 9774025243R
H10: M.2 standoff 2242; Mounting_Wuerth_WA-SMSI-M2_H2.5mm_9774025243; MPN 9774025243R
J4: M.2 Key M; TE_M.2_M_2x38-1MP_P0.5mm; MPN 2199119-4
J5: USB 3.0 x2; USB3_A_Molex_48406-0001_Horizontal_Stacked; MPN 48406-0001
R22: 1k; R_0402_1005Metric; MPN RC0402FR-071kL
R23: 47k; R_0402_1005Metric; MPN RC0402FR-0747kL
R24: 100k; R_0402_1005Metric; MPN RC0402FR-07100kL
U10: TPS2561DRC; VSON-10-1EP_3x3mm_P0.5mm_EP1.65x2.4mm_ThermalVias; MPN TPS2561DRCR
U11, U13: TPD4E05U06DQA; USON-10_2.5x1.0mm_P0.5mm; MPN TPD4E05U06DQAR
U12, U14: TPD2EUSB30; Texas_DRT-3; MPN TPD2EUSB30DRTR

Connections:
+3V3_NVME: C54.1, C55.1, C56.1, C57.1, C58.1, J4.2 (3.3V), J4.4 (3.3V), J4.12 (3.3V), J4.14 (3.3V), J4.16 (3.3V), J4.18 (3.3V), J4.70 (3.3V), J4.72 (3.3V), J4.74 (3.3V), R22.1; also elsewhere on the board
+5V_USB: C59.1, C60.1, U10.2 (IN), U10.3 (IN); also elsewhere on the board
CHASSIS: J5.SH (SHIELD); also elsewhere on the board
GND: C54.2, C55.2, C56.2, C57.2, C58.2, C59.2, C60.2, C61.2, C62.2, C63.2, C64.2, H9.1, H10.1, J4.1 (GND), J4.3 (GND), J4.9 (GND), J4.15 (GND), J4.21 (GND), J4.27 (GND), J4.33 (GND), J4.39 (GND), J4.45 (GND), J4.51 (GND), J4.57 (GND), J4.71 (GND), J4.73 (GND), J4.75 (GND), J5.4 (GND1), J5.7 (DRAIN1), J5.13 (GND2), J5.16 (DRAIN2), R23.2, R24.2, U10.1 (GND), U10.11 (PAD), U11.3 (GND), U11.8 (GND), U12.3 (GND), U13.3 (GND), U13.8 (GND), U14.3 (GND); also elsewhere on the board
LEDM_A: D6.2 (A), R22.2
M2_LED_N: D6.1 (K), J4.10 (DAS/~DSS/~LED1)
PCIE_CLKREQ_N: J4.52 (~CLKREQ); also elsewhere on the board
PCIE_CLK_N: J4.53 (REFCLKn); also elsewhere on the board
PCIE_CLK_P: J4.55 (REFCLKp); also elsewhere on the board
PCIE_RST_N: J4.50 (~PERST); also elsewhere on the board
PCIE_RX_N: J4.41 (PERn0/SATA-B+); also elsewhere on the board
PCIE_RX_P: J4.43 (PERp0/SATA-B-); also elsewhere on the board
PCIE_TX_N: J4.47 (PETn0/SATA-A-); also elsewhere on the board
PCIE_TX_P: J4.49 (PETp0/SATA-A+); also elsewhere on the board
PCIE_WAKE_N: J4.54 (~PEWAKE); also elsewhere on the board
USB3_0_DM: J5.2 (D1-), U12.2 (D-); also elsewhere on the board
USB3_0_DP: J5.3 (D1+), U12.1 (D+); also elsewhere on the board
USB3_0_RX_N: J5.5 (SSRX1-), U11.2 (D1-); also elsewhere on the board
USB3_0_RX_P: J5.6 (SSRX1+), U11.1 (D1+); also elsewhere on the board
USB3_0_TX_N: J5.8 (SSTX1-), U11.5 (D2-); also elsewhere on the board
USB3_0_TX_P: J5.9 (SSTX1+), U11.4 (D2+); also elsewhere on the board
USB3_1_DM: J5.11 (D2-), U14.2 (D-); also elsewhere on the board
USB3_1_DP: J5.12 (D2+), U14.1 (D+); also elsewhere on the board
USB3_1_RX_N: J5.14 (SSRX2-), U13.2 (D1-); also elsewhere on the board
USB3_1_RX_P: J5.15 (SSRX2+), U13.1 (D1+); also elsewhere on the board
USB3_1_TX_N: J5.17 (SSTX2-), U13.5 (D2-); also elsewhere on the board
USB3_1_TX_P: J5.18 (SSTX2+), U13.4 (D2+); also elsewhere on the board
USB_ILIM: R23.1, U10.7 (ILM)
USB_VBUS1: C61.1, C62.1, J5.1 (VBUS1), U10.9 (OUT1)
USB_VBUS2: C63.1, C64.1, J5.10 (VBUS2), U10.8 (OUT2)
USB_VBUS_EN: R24.1, U10.4 (EN1), U10.5 (EN2); also elsewhere on the board

Notes on the sheet:
NVMe (M.2 Key M) and USB 3.0 host ports
PCIe x1: TX AC-coupling capacitors are on the CM5, RX capacitors are on the SSD. Route as 90 ohm pairs (CM5 datasheet 2.3). USB VBUS: TPS2561 dual switch, about 1.2A per port (R_ILIM 47k). Each port has 150uF bulk as USB requires 120uF minimum.

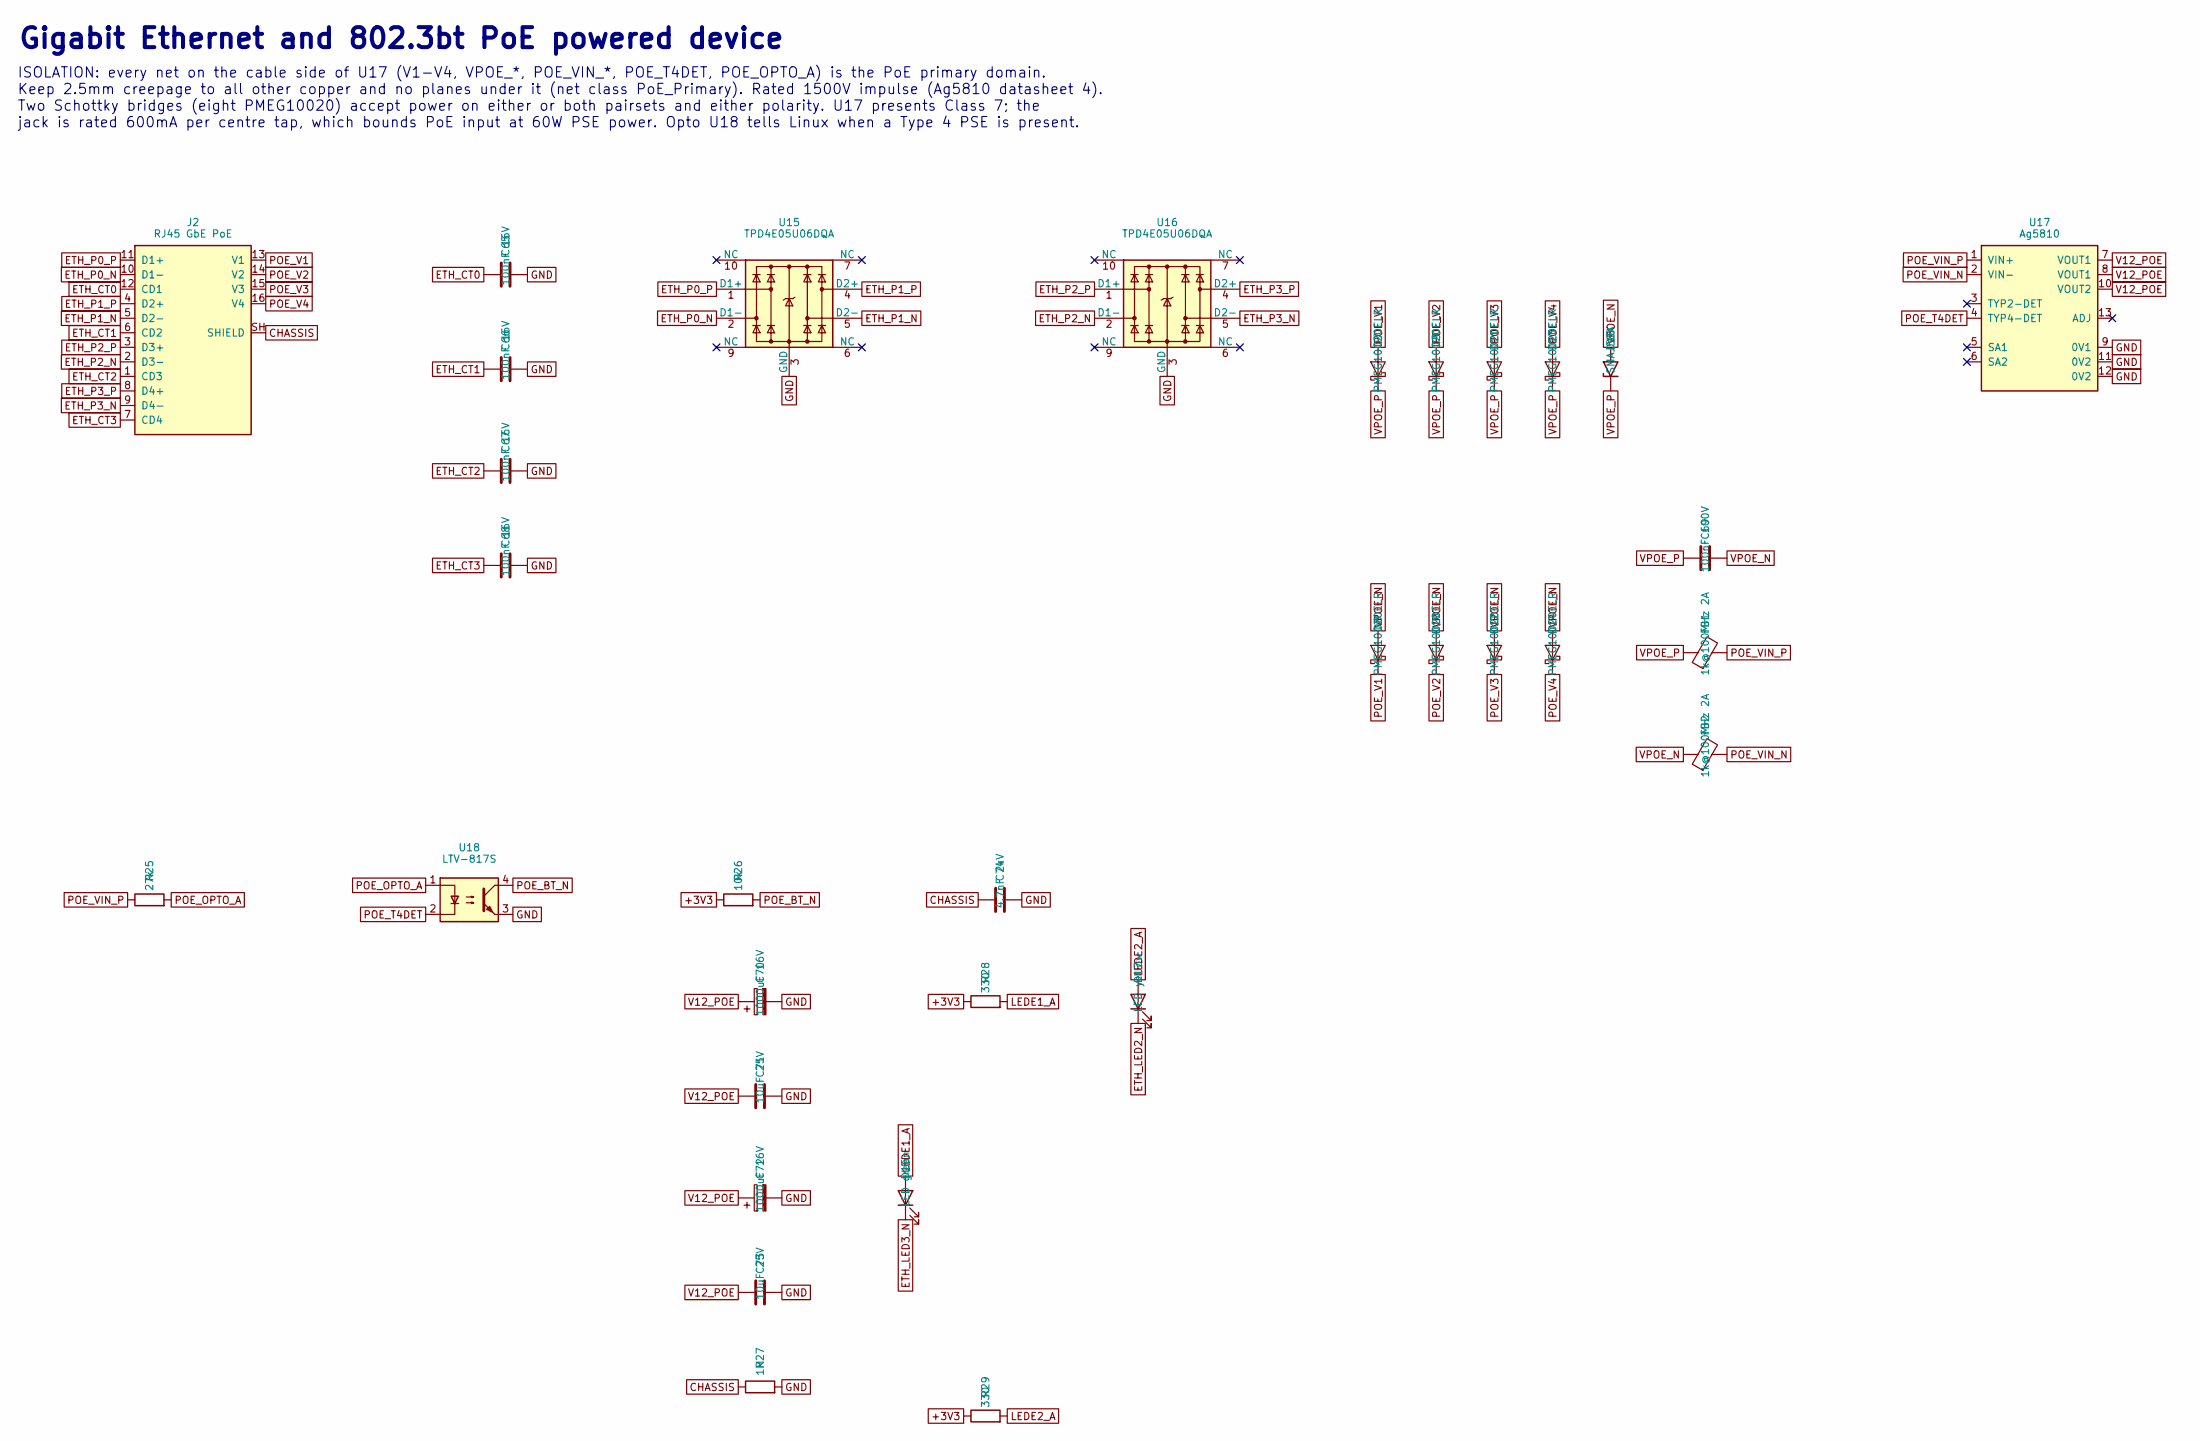
[picture p21: schematic ethernet_poe.kicad_sch, Tahanan Hub - Gigabit Ethernet and 802.3bt PoE powered devi…]

Parts:
C65, C66, C67, C68: 100nF 16V; C_0402_1005Metric; MPN CL05B104KO5NNNC
C69: 100nF 100V; C_0805_2012Metric; MPN CL21B104KCFNNNE
C70, C72: 1000uF 16V; CP_Elec_10x10.5; MPN EEE-FT1C102AP
C71, C73: 10uF 25V; C_1206_3216Metric; MPN CL31B106KAHNNNE
C74: 4.7nF 2kV; C_1812_4532Metric; MPN C1812C472KGRACTU
D7, D8, D9, D10, D11, D12, D13, D14: PMEG10020ELR; Nexperia_CFP3_SOD-123W; MPN PMEG10020ELRX
D15: SMAJ58A; D_SMA; MPN SMAJ58A
D16: LED green; LED_0603_1608Metric; MPN 150060GS75000
D17: LED yellow; LED_0603_1608Metric; MPN 150060YS75000
FB1, FB2: 1k@100MHz 2A; L_1210_3225Metric; MPN FBMH3225HM102NT
J2: RJ45 GbE PoE; RJ45_Wuerth_7499511001A; MPN 7499511001A
R25: 27k; R_1206_3216Metric; MPN RC1206FR-0727kL
R26: 10k; R_0402_1005Metric; MPN RC0402FR-0710kL
R27: 1M; R_1206_3216Metric; MPN RC1206FR-071ML
R28, R29: 330; R_0402_1005Metric; MPN RC0402FR-07330RL
U15, U16: TPD4E05U06DQA; USON-10_2.5x1.0mm_P0.5mm; MPN TPD4E05U06DQAR
U17: Ag5810; Silvertel_Ag5810; MPN Ag5810
U18: LTV-817S; SMDIP-4_W9.53mm; MPN LTV-817S

Connections:
+3V3: R26.1, R28.1, R29.1; also elsewhere on the board
CHASSIS: C74.1, J2.SH (SHIELD), R27.1; also elsewhere on the board
ETH_CT0: C65.1, J2.12 (CD1)
ETH_CT1: C66.1, J2.6 (CD2)
ETH_CT2: C67.1, J2.1 (CD3)
ETH_CT3: C68.1, J2.7 (CD4)
ETH_LED2_N: D17.1 (K); also elsewhere on the board
ETH_LED3_N: D16.1 (K); also elsewhere on the board
ETH_P0_N: J2.10 (D1-), U15.2 (D1-); also elsewhere on the board
ETH_P0_P: J2.11 (D1+), U15.1 (D1+); also elsewhere on the board
ETH_P1_N: J2.5 (D2-), U15.5 (D2-); also elsewhere on the board
ETH_P1_P: J2.4 (D2+), U15.4 (D2+); also elsewhere on the board
ETH_P2_N: J2.2 (D3-), U16.2 (D1-); also elsewhere on the board
ETH_P2_P: J2.3 (D3+), U16.1 (D1+); also elsewhere on the board
ETH_P3_N: J2.9 (D4-), U16.5 (D2-); also elsewhere on the board
ETH_P3_P: J2.8 (D4+), U16.4 (D2+); also elsewhere on the board
GND: C65.2, C66.2, C67.2, C68.2, C70.2, C71.2, C72.2, C73.2, C74.2, R27.2, U15.3 (GND), U15.8 (GND), U16.3 (GND), U16.8 (GND), U17.9 (0V1), U17.11 (0V2), U17.12 (0V2), U18.3; also elsewhere on the board
LEDE1_A: D16.2 (A), R28.2
LEDE2_A: D17.2 (A), R29.2
POE_BT_N: R26.2, U18.4; also elsewhere on the board
POE_OPTO_A: R25.2, U18.1
POE_T4DET: U17.4 (TYP4-DET), U18.2
POE_V1: D7.2 (A), D8.1 (K), J2.13 (V1)
POE_V2: D9.2 (A), D10.1 (K), J2.14 (V2)
POE_V3: D11.2 (A), D12.1 (K), J2.15 (V3)
POE_V4: D13.2 (A), D14.1 (K), J2.16 (V4)
POE_VIN_N: FB2.2, U17.2 (VIN-)
POE_VIN_P: FB1.2, R25.1, U17.1 (VIN+)
V12_POE: C70.1, C71.1, C72.1, C73.1, U17.7 (VOUT1), U17.8 (VOUT1), U17.10 (VOUT2); also elsewhere on the board
VPOE_N: C69.2, D8.2 (A), D10.2 (A), D12.2 (A), D14.2 (A), D15.2 (A2), FB2.1
VPOE_P: C69.1, D7.1 (K), D9.1 (K), D11.1 (K), D13.1 (K), D15.1 (A1), FB1.1

Notes on the sheet:
Gigabit Ethernet and 802.3bt PoE powered device
ISOLATION: every net on the cable side of U17 (V1-V4, VPOE_*, POE_VIN_*, POE_T4DET, POE_OPTO_A) is the PoE primary domain. Keep 2.5mm creepage to all other copper and no planes under it (net class PoE_Primary). Rated 1500V impulse (Ag5810 datasheet 4). Two Schottky bridges (eight PMEG10020) accept 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

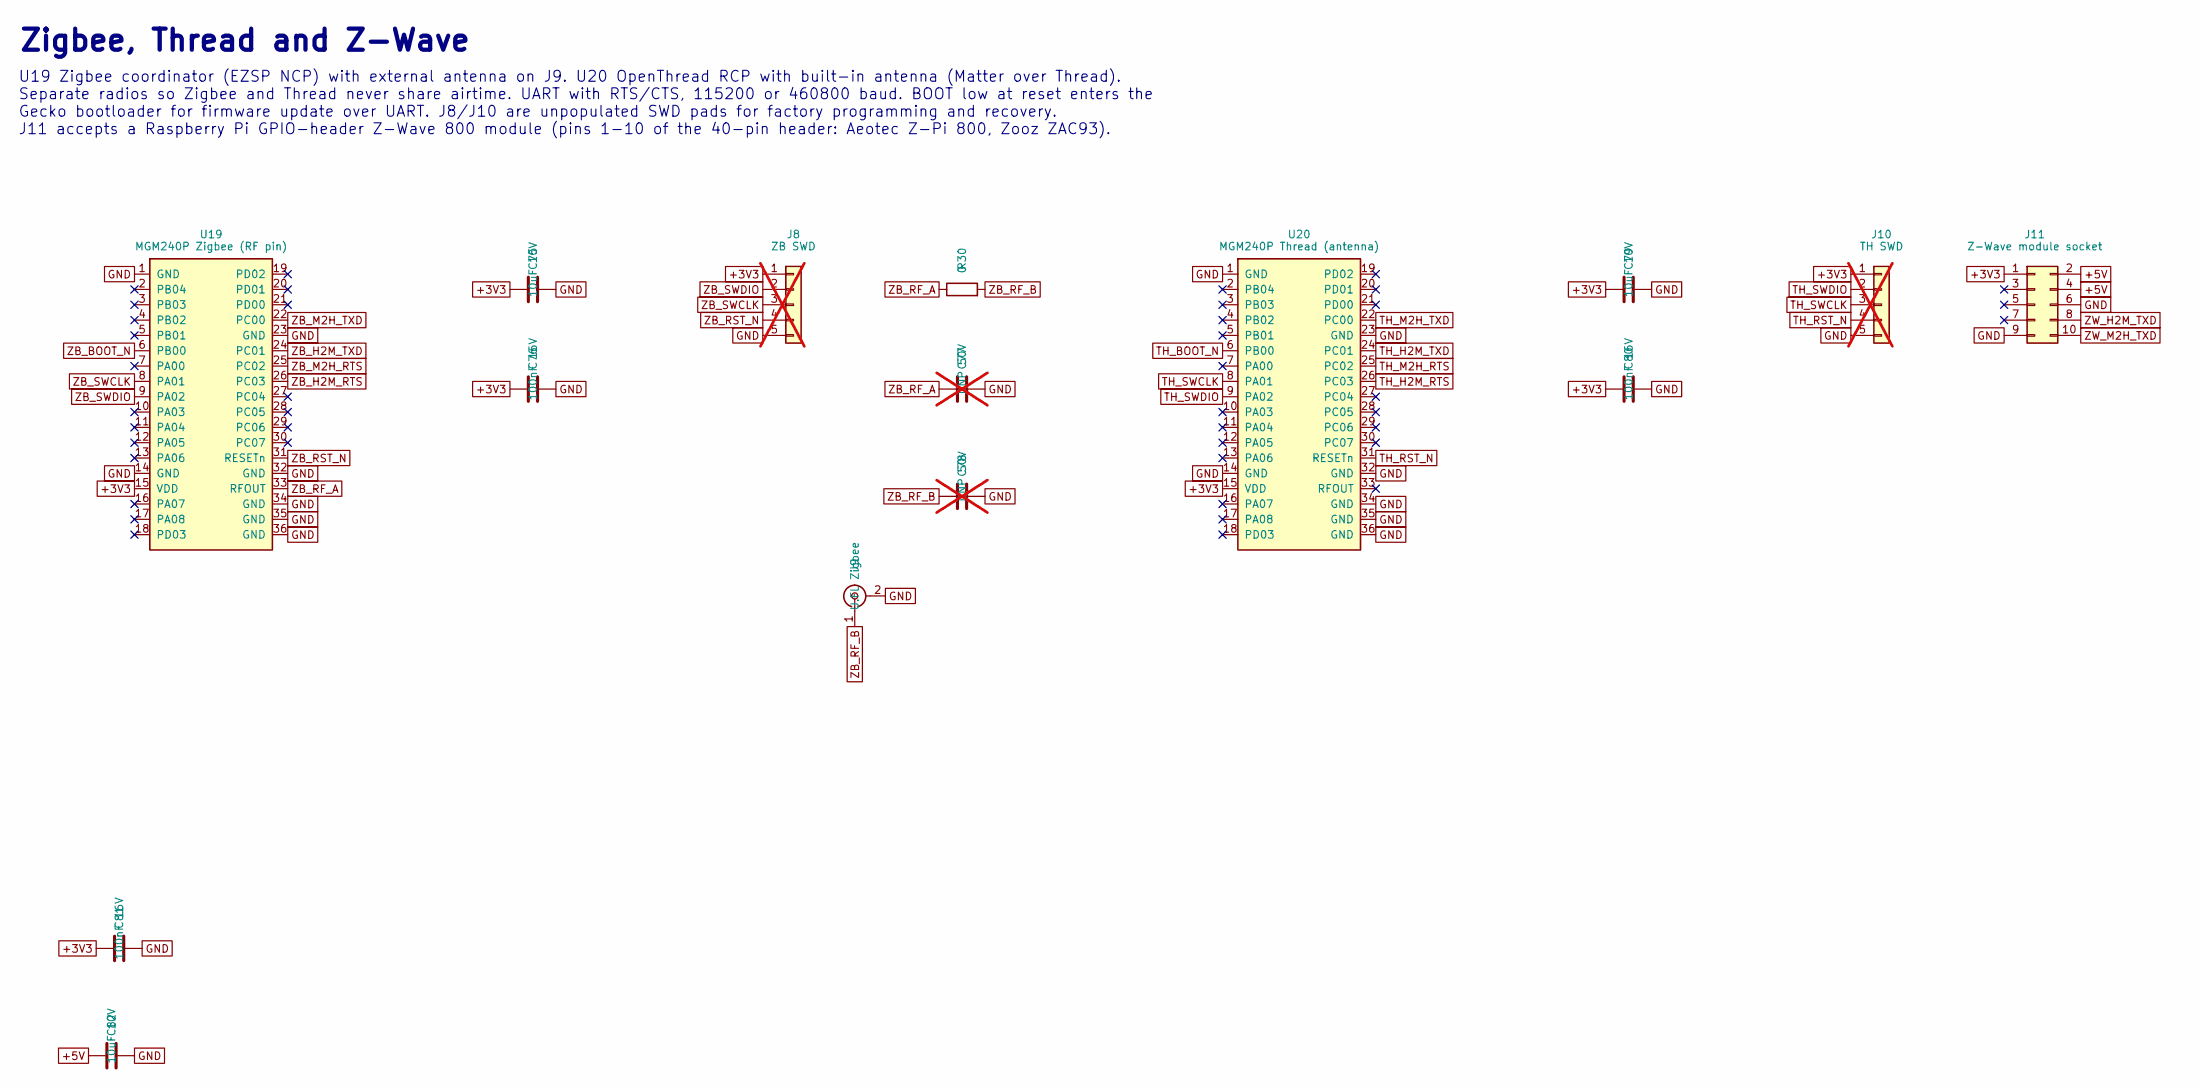
[picture p22: schematic radios.kicad_sch, Tahanan Hub - Zigbee, Thread and Z-Wave]

Parts:
C75, C79, C82: 10uF 10V; C_0603_1608Metric; MPN CL10A106KP8NNNC
C76, C80, C81: 100nF 16V; C_0402_1005Metric; MPN CL05B104KO5NNNC
C77, C78: DNP 50V; C_0402_1005Metric; not fitted
J8: ZB SWD; PinHeader_1x05_P1.27mm_Vertical; not fitted
J9: U.FL Zigbee; U.FL_Hirose_U.FL-R-SMT-1_Vertical; MPN U.FL-R-SMT-1(80)
J10: TH SWD; PinHeader_1x05_P1.27mm_Vertical; not fitted
J11: Z-Wave module socket; PinSocket_2x05_P2.54mm_Vertical; MPN SSW-105-01-G-D
R30: 0; R_0402_1005Metric; MPN RC0402FR-070RL
U19: MGM240P Zigbee (RF pin); SiliconLabs_MGM240P; MPN MGM240PA32VNN3
U20: MGM240P Thread (antenna); SiliconLabs_MGM240P; MPN MGM240PA32VNA3

Connections:
+3V3: C75.1, C76.1, C79.1, C80.1, C81.1, J8.1, J10.1, J11.1, U19.15 (VDD), U20.15 (VDD); also elsewhere on the board
+5V: C82.1, J11.2, J11.4; also elsewhere on the board
GND: C75.2, C76.2, C77.2, C78.2, C79.2, C80.2, C81.2, C82.2, J8.5, J9.2 (Ext), J10.5, J11.6, J11.9, U19.1 (GND), U19.14 (GND), U19.23 (GND), U19.32 (GND), U19.34 (GND), U19.35 (GND), U19.36 (GND), U20.1 (GND), U20.14 (GND), U20.23 (GND), U20.32 (GND), U20.34 (GND), U20.35 (GND), U20.36 (GND); also elsewhere on the board
TH_BOOT_N: U20.6 (PB00); also elsewhere on the board
TH_H2M_RTS: U20.26 (PC03); also elsewhere on the board
TH_H2M_TXD: U20.24 (PC01); also elsewhere on the board
TH_M2H_RTS: U20.25 (PC02); also elsewhere on the board
TH_M2H_TXD: U20.22 (PC00); also elsewhere on the board
TH_RST_N: J10.4, U20.31 (RESETn); also elsewhere on the board
TH_SWCLK: J10.3, U20.8 (PA01)
TH_SWDIO: J10.2, U20.9 (PA02)
ZB_BOOT_N: U19.6 (PB00); also elsewhere on the board
ZB_H2M_RTS: U19.26 (PC03); also elsewhere on the board
ZB_H2M_TXD: U19.24 (PC01); also elsewhere on the board
ZB_M2H_RTS: U19.25 (PC02); also elsewhere on the board
ZB_M2H_TXD: U19.22 (PC00); also elsewhere on the board
ZB_RF_A: C77.1, R30.1, U19.33 (RFOUT)
ZB_RF_B: C78.1, J9.1 (In), R30.2
ZB_RST_N: J8.4, U19.31 (RESETn); also elsewhere on the board
ZB_SWCLK: J8.3, U19.8 (PA01)
ZB_SWDIO: J8.2, U19.9 (PA02)
ZW_H2M_TXD: J11.8; also elsewhere on the board
ZW_M2H_TXD: J11.10; also elsewhere on the board

Notes on the sheet:
Zigbee, Thread and Z-Wave
U19 Zigbee coordinator (EZSP NCP) with external antenna on J9. U20 OpenThread RCP with built-in antenna (Matter over Thread). Separate radios so Zigbee and Thread never share airtime. UART with RTS/CTS, 115200 or 460800 baud. BOOT low at reset enters the Gecko bootloader for firmware update over UA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

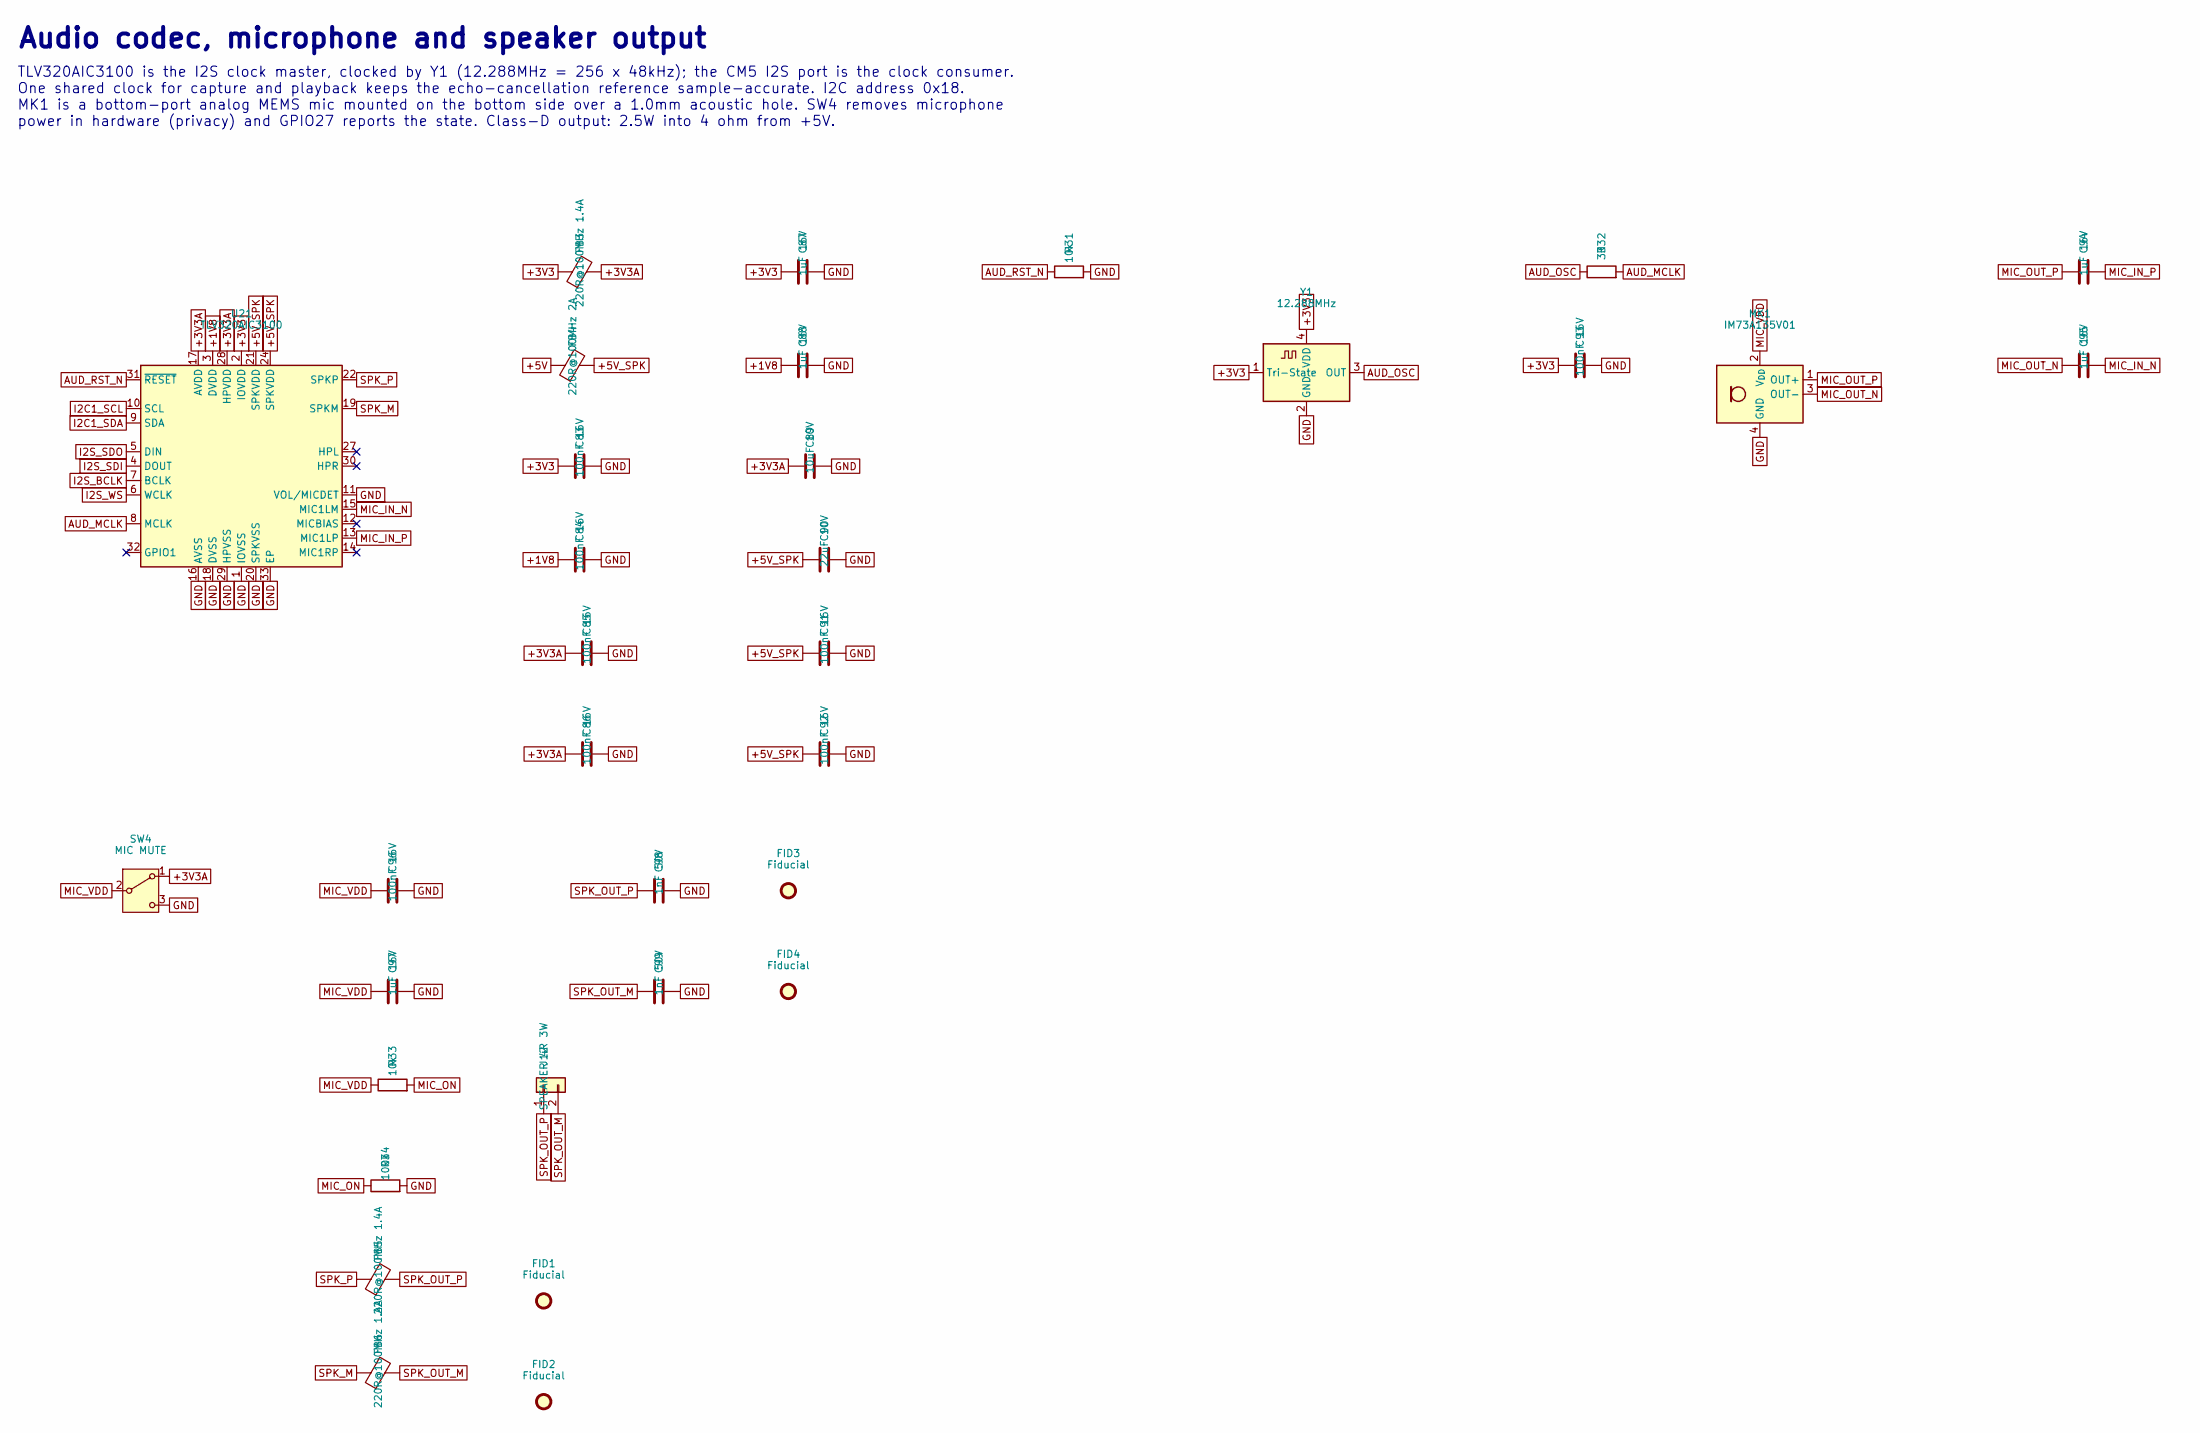
[picture p23: schematic audio.kicad_sch, Tahanan Hub - Audio codec, microphone and speaker output]

Parts:
C83, C84, C85, C86, C91, C92, C93, C96: 100nF 16V; C_0402_1005Metric; MPN CL05B104KO5NNNC
C87, C88, C94, C95, C97: 1uF 16V; C_0402_1005Metric; MPN CL05A105KO5NNNC
C89: 10uF 10V; C_0603_1608Metric; MPN CL10A106KP8NNNC
C90: 22uF 10V; C_0805_2012Metric; MPN CL21A226MPQNNNE
C98, C99: 1nF 50V; C_0402_1005Metric; MPN CL05B102KB5NNNC
FB3, FB5, FB6: 220R@100MHz 1.4A; L_0603_1608Metric; MPN BLM18PG221SN1D
FB4: 220R@100MHz 2A; L_0805_2012Metric; MPN BLM21PG221SN1D
FID1, FID2, FID3, FID4: Fiducial; Fiducial_1mm_Mask2mm
J12: SPEAKER 4R 3W; JST_PH_S2B-PH-K_1x02_P2.00mm_Horizontal; MPN S2B-PH-K-S
MK1: IM73A135V01; Infineon_PG-LLGA-5-2; MPN IM73A135V01XTSA1
R31, R33: 10k; R_0402_1005Metric; MPN RC0402FR-0710kL
R32: 33; R_0402_1005Metric; MPN RC0402FR-0733RL
R34: 100k; R_0402_1005Metric; MPN RC0402FR-07100kL
SW4: MIC MUTE; SW_SPDT_CK_JS102011SAQN; MPN JS102011SAQN
U21: TLV320AIC3100; VQFN-32-1EP_5x5mm_P0.5mm_EP3.5x3.5mm; MPN TLV320AIC3100IRHBR
Y1: 12.288MHz; Oscillator_SMD_ECS_2520MV-xxx-xx-4Pin_2.5x2.0mm; MPN ECS-2520MVLC-122.8-BN-TR

Connections:
+1V8: C84.1, C88.1, U21.3 (DVDD); also elsewhere on the board
+3V3: C83.1, C87.1, C93.1, FB3.1, U21.2 (IOVDD), Y1.1 (Tri-State), Y1.4 (VDD); also elsewhere on the board
+3V3A: C85.1, C86.1, C89.1, FB3.2, SW4.1 (A), U21.17 (AVDD), U21.28 (HPVDD)
+5V: FB4.1; also elsewhere on the board
+5V_SPK: C90.1, C91.1, C92.1, FB4.2, U21.21 (SPKVDD), U21.24 (SPKVDD)
AUD_MCLK: R32.2, U21.8 (MCLK)
AUD_OSC: R32.1, Y1.3 (OUT)
AUD_RST_N: R31.1, U21.31 (~RESET); also elsewhere on the board
GND: C83.2, C84.2, C85.2, C86.2, C87.2, C88.2, C89.2, C90.2, C91.2, C92.2, C93.2, C96.2, C97.2, C98.2, C99.2, MK1.4 (GND), MK1.5 (GND), R31.2, R34.2, SW4.3 (C), U21.1 (IOVSS), U21.11 (VOL/MICDET), U21.16 (AVSS), U21.18 (DVSS), U21.20 (SPKVSS), U21.25 (SPKVSS), U21.29 (HPVSS), U21.33 (EP), Y1.2 (GND); also elsewhere on the board
I2C1_SCL: U21.10 (SCL); also elsewhere on the board
I2C1_SDA: U21.9 (SDA); also elsewhere on the board
I2S_BCLK: U21.7 (BCLK); also elsewhere on the board
I2S_SDI: U21.4 (DOUT); also elsewhere on the board
I2S_SDO: U21.5 (DIN); also elsewhere on the board
I2S_WS: U21.6 (WCLK); also elsewhere on the board
MIC_IN_N: C95.2, U21.15 (MIC1LM)
MIC_IN_P: C94.2, U21.13 (MIC1LP)
MIC_ON: R33.2, R34.1; also elsewhere on the board
MIC_OUT_N: C95.1, MK1.3 (OUT-)
MIC_OUT_P: C94.1, MK1.1 (OUT+)
MIC_VDD: C96.1, C97.1, MK1.2 (V_{DD}), R33.1, SW4.2 (B)
SPK_M: FB6.1, U21.19 (SPKM), U21.23 (SPKM)
SPK_OUT_M: C99.1, FB6.2, J12.2
SPK_OUT_P: C98.1, FB5.2, J12.1
SPK_P: FB5.1, U21.22 (SPKP), U21.26 (SPKP)

Notes on the sheet:
Audio codec, microphone and speaker output
TLV320AIC3100 is the I2S clock master, clocked by Y1 (12.288MHz = 256 x 48kHz); the CM5 I2S port is the clock consumer. One shared clock for capture and playback keeps the echo-cancellation reference sample-accurate. I2C address 0x18. MK1 is a bottom-port analog MEMS mic mounted on the bottom side 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

Board: 4 copper layers, 230 parts (6 on the bottom side), 155 nets, no tracks yet.
