maglambayan/tahanan/firmware/radios/manifests/tahanan/tahanan_zigbee_ncp.yaml

# Tahanan Hub U19: Zigbee coordinator firmware (EmberZNet NCP, EZSP over UART).
# Format: NabuCasa/silabs-firmware-builder manifest, derived from manifests/nabucasa/yellow/yellow_zigbee_ncp.yaml
# as of 2026-11. Differences from Yellow: device, UART pins, 460800 baud, no activity LED, no MGM210 clock workaround.
# Status: NOT built and NOT flashed. See ../../README.md.
name: Tahanan Zigbee
device: MGM240PA32VNN
base_project: src/zigbee_ncp
filename: "{manifest_name}_{ezsp_version}"
sdk: "simplicity_sdk:2026.6.1"
toolchain: "14.2.1.20241119"

gbl:
  fw_type: zigbee_ncp
  ezsp_version: dynamic
  baudrate: 460800

sdk_extension:
  - id: xncp
    vendor: nabucasa
    version: 1.0.0
  - id: xncp_common
    vendor: nabucasa
    version: 1.0.0

add_components:
- id: xncp_core
  vendor: nabucasa
  package: xncp
- id: xncp_common_commands
  vendor: nabucasa
  package: xncp_common

c_defines:
  XNCP_EZSP_VERSION_PATCH_NUM_OVERRIDE: 1

  XNCP_MFG_MANUF_NAME: '"Tahanan"'
  XNCP_MFG_BOARD_NAME: '"Tahanan Hub rev A"'
  XNCP_BUILD_STRING: template:"{now:%Y%m%d%H%M%S}"
  XNCP_MANUAL_SOURCE_ROUTE_TABLE_SIZE: 200

  SL_ZIGBEE_APS_UNICAST_MESSAGE_COUNT: 64
  SL_ZIGBEE_BINDING_TABLE_SIZE: 32
  SL_ZIGBEE_BROADCAST_TABLE_SIZE: 64
  SL_ZIGBEE_KEY_TABLE_SIZE: 12
  SL_ZIGBEE_MAX_END_DEVICE_CHILDREN: 32
  SL_ZIGBEE_SOURCE_ROUTE_TABLE_SIZE: 200
  SL_ZIGBEE_NEIGHBOR_TABLE_SIZE: 26
  SL_ZIGBEE_ADDRESS_TABLE_SIZE: 32

  SL_ZIGBEE_CHILD_TABLE_SIZE:
    type: c_flag
    value: 32

  SL_ZIGBEE_ROUTE_TABLE_SIZE:
    type: c_flag
    value: 250

  SL_ZIGBEE_MULTICAST_TABLE_SIZE:
    type: c_flag
    value: 26

  SL_ZIGBEE_DISCOVERY_TABLE_SIZE:
    type: c_flag
    value: 8

  SL_IOSTREAM_USART_VCOM_BAUDRATE: 460800
  SL_IOSTREAM_USART_VCOM_FLOW_CONTROL_TYPE: usartHwFlowControlCtsAndRts

  SL_IOSTREAM_USART_VCOM_PERIPHERAL: USART0
  SL_IOSTREAM_USART_VCOM_PERIPHERAL_NO: 0

  # Schematic nets: PC00 ZB_M2H_TXD, PC01 ZB_H2M_TXD, PC02 ZB_M2H_RTS, PC03 ZB_H2M_RTS
  SL_IOSTREAM_USART_VCOM_TX_PORT: SL_GPIO_PORT_C
  SL_IOSTREAM_USART_VCOM_TX_PIN:  0
  SL_IOSTREAM_USART_VCOM_RX_PORT: SL_GPIO_PORT_C
  SL_IOSTREAM_USART_VCOM_RX_PIN:  1
  SL_IOSTREAM_USART_VCOM_RTS_PORT: SL_GPIO_PORT_C
  SL_IOSTREAM_USART_VCOM_RTS_PIN:  2
  SL_IOSTREAM_USART_VCOM_CTS_PORT: SL_GPIO_PORT_C
  SL_IOSTREAM_USART_VCOM_CTS_PIN:  3

  SL_IOSTREAM_USART_VCOM_RX_BUFFER_SIZE: 128
