maglambayan/tahanan/(commit log)

2026-11-10 Add Tahanan Hub rev A design package
    Home Assistant hub on the Raspberry Pi Compute Module 5 with NVMe,
    Gigabit Ethernet with 802.3bt PoE, USB-C PD, Zigbee, Thread, a Z-Wave
    module socket and voice audio.
    - hardware: KiCad 10 project generated from gen/design.py. Schematic
    passes ERC with 0 violations and matches the design netlist on all
    989 pins. Board is placed and passes DRC with 0 errors, but it is
    not routed (499 unconnected), so no fabrication files are included.
    - mechanical: parametric enclosure with STEP, STL and 3MF exports.
    - manufacturing: BOM with part numbers and alternates. Prices are
    estimates, not verified quotes.
    - software, firmware: bootloader config, device tre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
    [audio.kicad_sch, cm5.kicad_sch, ethernet_poe.kicad_sch, power_in.kicad_sch, power_rails.kicad_sch, radios.kicad_sch, storage_usb.kicad_sch, tahanan-assembly.step]
2026-11-11 Check open values, price BOM, complete firmware and HAOS build files
    - hardware: LMR33640 inductors 6.8 uH and 220 nF input capacitors per
    datasheet table; replace obsolete inductor and non-existent oscillator
    part numbers. ERC 0, netlist 989/989, DRC 0 errors, still unrouted.
    - manufacturing: BOM priced from DigiKey (41 of 86 lines, 2026-11-11)
    with stock and supply notes.
    - firmware: STUSB4500 programming script (self-test only, not run on
    hardware); radio manifests in silabs-firmware-builder format.
    - software: fix overlay (undefined MICBIAS_OFF, CAM_GPIO0 conflict),
    audio init script and unit, HAOS 18.5 build recipe and hook patch.
    - docs: status page updated. Board is not rout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
    [audio.kicad_sch, power_rails.kicad_sch, tahanan-pcba-bom.csv, tahanan.kicad_pcb]
2026-11-11 Re-save KiCad project file in KiCad 10 format
    KiCad rewrote tahanan.kicad_pro when the project was opened. The change
    reorders the metadata and adds default settings. No net class or design
    values were edited. Routing is not started; the board is still placed
    and unrouted.
